MarcelZawadzki/autonomous-rover-thesis/rover_media/robot.png

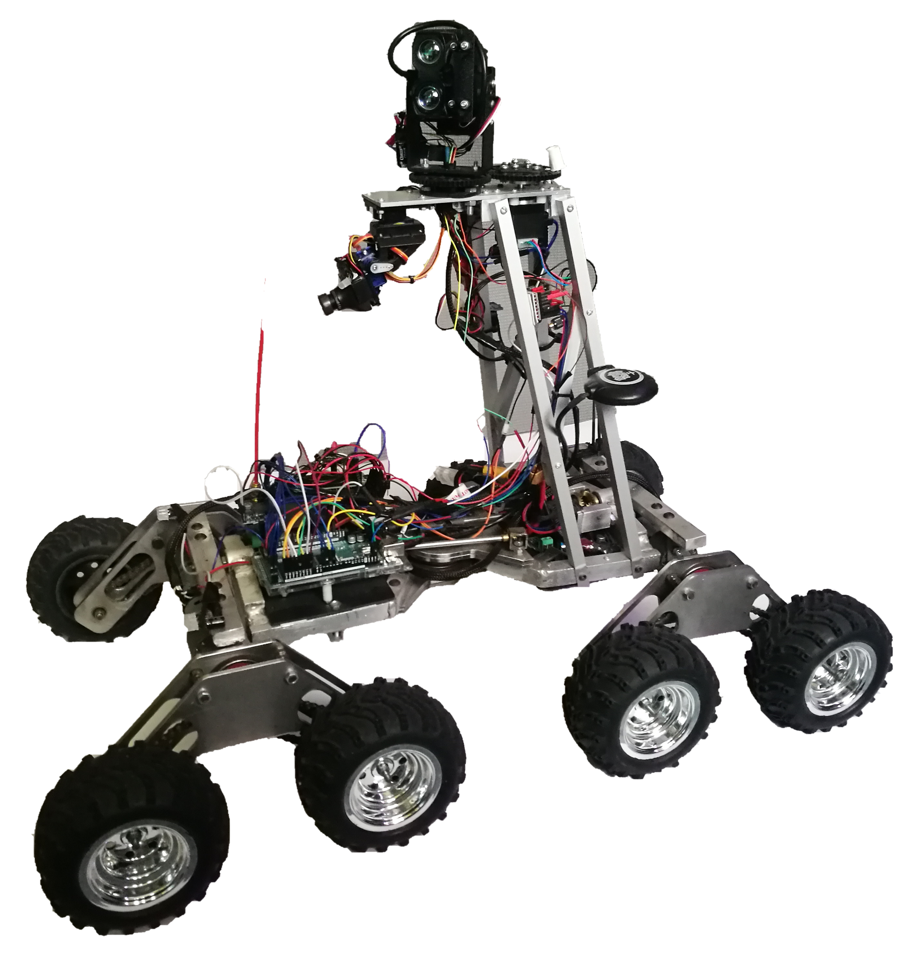
rover_media/robot.png
