MarcelZawadzki/autonomous-rover-thesis/autonomous_navigation_system_for_the_outdoor_mobile_robot_PL.pdf

Instytut Automatyki i Informatyki Stosowanej

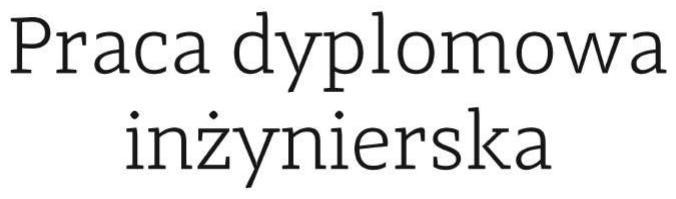
[picture p2: figure]

na kierunku Automatyka i Robotyka

### System autonomicznej nawigacji dla terenowego robota mobilnego

# Marcel Zawadzki

Numer albumu 310361

promotor
dr inz. Wojciech Dudek ˙

WARSZAWA 2024

### System autonomicznej nawigacji dla terenowego robota mobilnego

Streszczenie. Niniejsza praca skupia się na problemie autonomicznej nawigacji w nieusystematyzowanych terenach. Jej celem było opracowanie i implementacja systemu nawigacji autonomicznej dla terenowego robota mobilnego własnej konstrukcji, z wykorzystaniem skanera LiDAR.
Projekt obejmował opracowanie trójwymiarowego skanera LiDAR, rozbudowę platformy mobilnej o dodatkowe czujniki, utworzenie sterowników niskopoziomowych dla skanera i platformy mobilnej, opracowanie sterowników sprzętu w systemie ROS2 i utworzenie systemu nawigacji autonomicznej w ROS2. System ten jest zdolny do wykonywania kluczowych aspektów nawigacji, takich jak lokalizacja robota, mapowanie otoczenia, planowanie ściezki i jej realizacja. ˙
W ramach badań przeprowadzono szczegółowe testy poszczególnych modułów systemu, a następnie zweryfikowano skuteczno´sć całego systemu w zadaniu nawigacji autonomicznej. Wyniki testów potwierdziły efektywno´sć oraz poprawno´sć działania systemu, wskazuj ąc na jego zdolno´sć do skutecznego poruszania się w naturalnych, nieusystematyzowanych środowiskach.

Słowa kluczowe: robotyka, nawigacja autonomiczna, robot mobilny, łazik, LiDAR, ROS

### Autonomous navigation system for the outdoor mobile robot

Abstract. This thesis addresses the problem of autonomous navigation in unstructured environments. The goal was to develop and implement an autonomous navigation system for an all-terrain mobile robot made by the author, utilising a LiDAR scanner.
The project involved the development of a 3D LiDAR scanner, an expansion of the mobile platform’s capabilities with additional sensors, the creation of low-level controllers for the scanner and mobile platform, the development of hardware drivers in ROS2, and the creation of an autonomous navigation system in ROS2. This system is capable of executing the key aspects of navigation, such as robot localization, environment mapping, path planning and path execution.
As part of the research, detailed tests were conducted on individual modules of the system. Afterwards, the effectiveness of the entire system in the task of autonomous navigation was verified. The test results confirmed the effectiveness of the system, proving its ability to successfully navigate in natural, unstructured environments.

Keywords: robotics, autonomous navigation, mobile robot, rover, LiDAR, ROS

## Spis treści

0. Spis treści

## 1. Wstęp

Współczesna robotyka stanowi obszar nasilonych badań i rozwoju, który dynamicznie kształtuje krajobraz technologiczny. Dziedzina ta ł ączy obszary inzynierii mechanicznej, ˙ elektronicznej i oprogramowania pozwalaj ąc inzynierom na tworzenie robotów, zaawan- ˙ sowanych systemów zdolnych do interakcji ze światem rzeczywistym, których głównym celem jest wspomaganie człowieka w niektórych czynnościach, lub zastępowanie go [1]
- szczególnie gdy automatyzowana czynno´sć wi ąze się z niebezpieczeństwem dla wyko- ˙ nawcy lub cechuje się powtarzalności ą i monotoni ą, mog ąc ą doprowadzić do spadku dokładności wykonywanego przez człowieka zadania.
Roboty mobilne, w szczególności, staj ą się istotnym punktem zainteresowania ze względu na swoj ą zdolno´sć do poruszania się w przestrzeni i wykonywania róznorodnych ˙ zadań, poza określonym stanowiskiem instalacji. Umozliwiaj ą większ ą elastyczno´sć wyko- ˙ nywania zadań niz tradycyjne rozwi ązania automatyczne, jednocześnie nie wymagaj ąc ˙ zastosowania ludzkiej siły roboczej.
Najpopularniejsz ą podkategori ą robotów mobilnych s ą roboty przeznaczone do uzytku ˙ w przestrzeniach zamkniętych. Stanowi ą rozwi ązania łatwiejsze w implementacji, gdyz˙ pozwalaj ą na przyjęcie wielu załozeń upraszczaj ących projekt robota, m.in: ˙
- ograniczony poślizg kół,
- brak przechyłu robota,
- analizę przeszkód jedynie dwóch wymiarach,
- wykorzystanie infrastruktury np. przygotowanych punktów orientacyjnych lub linii

magnetycznych.

W przeciwieństwie do robotów mobilnych przeznaczonych do przestrzeni zamkniętych, roboty terenowe stawiaj ą przed inzynierami dodatkowe wyzwania. Musz ą podołać ˙ niebezpiecznym warunkom terenowym, zmiennym nachyleniom trenu i przeszkodom trójwymiarowym, co wymaga bardziej zaawansowanych systemów nawigacyjnych i lepszej adaptacji do zmiennych warunków otoczenia. Dzięki temu ich zastosowania mog ą być znacznie szersze. Cechuj ą się zdolności ą do operowania w nieustrukturyzowanych środowiskach, takich jak krajobrazy naturalne i rolnicze oraz obszary po kataklizmach. Umozliwia to wykorzystanie ich w zadaniach jak m.in.: ˙

- eksploracji trudno dostępnych i niebezpiecznych terenów np. obszarów skazonych, ˙
- zadaniach inspekcyjnych infrastruktury np. energetycznej i gazowej,
- zastosowaniach militarnych np. patrolowych i rozbrajaniu ładunków wybuchowych,
- branzy rolniczej np. monitorowania rozległych upraw. ˙

Szczególn ą odmian ą pierwszego z wymienionych zastosowań jest eksploracja kosmiczna Księzyca i Marsa, będ ąca pierwotnym zastosowaniem terenowych robotów mobilnych - ˙
łazików kosmicznych. Łaziki umozliwiaj ą przeprowadzanie badań bez zagro ˙ | zenia ˙ | zycia ˙
ludzkiego i konieczności transportu zywności, wody, czy tworzenia systemów podtrzyma- ˙ nia zycia. ˙

1. Wstęp
Powyzsze zastosowania wymagałyby od człowieka nara ˙ | zenia na niebezpieczeństwo lub ˙
wykonywania powtarzalnych czynności, s ą więc dobrze dostosowane do wykonywania przez robota w sposób autonomiczny. W przypadku aplikacji pozaziemskich, dodatkowym argumentem za automatyzacj ą jest znacz ące opóźnienie w komunikacji - w przypadku transmisji pomiędzy Ziemi ą a Marsem wynosi ono od 5 do 20 minut[2], co znacz ąco utrudnia bezpośrednie sterowanie.
W niniejszej pracy omówiona zostanie problematyka zwi ązana z projektowaniem i implementacj ą autonomicznego systemu nawigacji dla robota terenowego. W tym kontek-ście analizowane będ ą rózne aspekty, takie jak platforma mobilna, systemy sensoryczne, a ˙ takze algorytmy nawigacyjne. ˙

## 2. Cel pracy

Celem niniejszej pracy było stworzenie autonomicznego systemu dla robota mobilnego własnej konstrukcji, zdolnego do nawigacji w nieustrukturyzowanych środowiskach. Zastosowana platforma mobilna technicznie umozliwia poruszanie się po nieregularnym ˙ terenie. Opracowany system posiada zdolno´sć lokalizacji robota, mapowania otoczenia, wyznaczania trasy do określonego celu, a następnie skutecznego jej pokonywania, uwzględniaj ąc omijanie przeszkód. W ramach projektu opracowano trójwymiarowy skaner LiDAR jako kluczowe narzędzie do percepcji otoczenia przez robota. Dodatkowo, przygotowano sterowniki niskopoziomowe, umozliwiaj ące zbieranie danych oraz skuteczne sterowanie ˙ ruchem robota.

### 2.1. Załozenia projektowe ˙

Na podstawie analizy dziedziny i istniej ących rozwi ązań, które zostan ą szczegółowo przeanalizowane w rozdziałach 3 i 4, przyjęte zostały następuj ące załozenia projektowe: ˙

- Nawigacja autonomiczna - system zdolny będzie do wykonywania zadania nawigacji

autonomicznej zgodnie z definicj ą w sekcji 3.5.
- Dane wejściowe do systemu - współrzędne celu
- Wykorzystanie autorskiej terenowej platformy mobilnej, opisanej w sekcji 3.2. Oferuje

ona bardzo dobr ą mobilno´sć i jest przystosowana do poruszania się po nieregularnym terenie, oraz pozwala na instalację szerokiego zakresu czujników.
- Skonstruowanie trójwymiarowego skanera LiDAR. Z przyczyn przytoczonych w sekcji

3.3 jest odpowiednim źródłem danych w robocie terenowym, jednocześnie mieszcz ąc się w budzecie autora. Ponadto, konstrukcja własnego czujnika pozwoli na zbadanie ˙ wpływu parametrów skanera na działanie systemu.
- Wykorzystanie mikrokontrolerów ATmega i języka C++ do sterowania niskopozio-

mow ą części ą systemu. W ramach niniejszej pracy oprogramowanie zostało poszerzone o obsługę dodatkowych sensorów oraz mozliwo´sć komunikacji z komputerem ˙ obsługuj ącym funkcje wysokopoziomowe.
- Zastosowanie struktury ramowej ROS2 w wersji Humble [3] przeznaczonej na system

Ubuntu 22.04 LTS do rozwijania oprogramowania wysokopoziomowego, z powodów przedstawionych w sekcji 3.6. Wybrana została najnowsza wersja z długim terminem wsparcia. Ponadto ROS w wersji 2 oferuje zwiększone bezpieczeństwo i stabilno´sć. Do programowania pojedynczych węzłów uzyto język Python, ze względu na szybko´sć ˙ tworzenia kodu i dostępności obszernej gamy bibliotek.
- Do tworzenia schematów blokowych SysML zgodnie z metamodelem MeROS [4]

wykorzystano Visual Paradigm.
- Pozostałe wykorzystane oprogramowanie: IDE VS Code, MatLab R2021a do analizy

danych, Solidworks 2021 do modelowania 3D, CURA 5.0 do przygotowania modeli do druku 3D.

2. Cel pracy

### 2.2. Ograniczenia

Ponadto, przyjęte zostały następuj ące ograniczenia zakresu pracy:
- Podczas wykonywania zadania nawigacji ignorowane będ ą dynamiczne przeszkody. Robot z załozenia poruszać ma się po terenach niezamieszkanych, ponadto jego ˙ niska prędko´sć ogranicza wpływ poruszaj ących się z duz ą prędkości ą obiektów na ˙ jego ściezkę. ˙
- Mozliwości porównania wyników z innymi rozwi ązaniami s ą ograniczone, ze względu ˙ na brak dostępu do standaryzowanych warunków testowych i duze ró ˙ znice w kon- ˙ strukcjach robotów.
- W czasie nawigacji ignorowane s ą zbiorniki wodne. Woda jest przezroczysta i odblaskowa, co uniemozliwia poprawne jej wykrycie przez czujnik LiDAR. Konieczne ˙ byłoby zastosowanie dodatkowych czujników np. ultradźwiękowych, których wi ązka odbija się od wody.

### 2.3. Walidacja działania systemu

Skuteczno´sć rozwi ązania przetestowana została podczas testów terenowych całości systemu oraz testów działania odseparowanych podsystemów. Działanie skanera LiDAR zostało przetestowane w szerokim zakresie warunków otoczenia i porównane z komercyjnym sensorem. Sterowniki niskopoziomowe testowane były w odseparowaniu od warstwy wysokopoziomowej. Algorytmy autonomiczne przetestowano w pomieszczeniu w poblizu˙ stanowiska roboczego, w celu ułatwienia modyfikacji oprogramowania na biez ąco. Dalsze ˙ testy przeprowadzono w warunkach naturalnych, w nierównym terenie z przeszkodami, najczęściej drzewami lub dodatkowymi przeszkodami umieszczonymi ręcznie w środowisku. W celu walidacji działania kompletnego systemu, przeprowadzono testy w naturalnym, nieregularnym środowisku z przeszkodami. Zadano robotowi cel, następnie obserwowano realizację zadania. Przejazd zarejestrowano z wykorzystaniem zewnętrznej kamery, oraz zapisano wizualizację stanu systemu.

## 3. Narzędzie i technologie

### 3.1. Roboty mobilne

Robot mobilny jest to robot zdolny do zmiany połozenia w przestrzeni, je ˙ | zd˙ z ąc, krocz ąc, ˙
lataj ąc lub pływaj ąc. Ponizsza analiza ograniczona będzie do robotów l ądowych. Podstaw ą ˙ robota jest napęd. W robotach terenowych najczęściej wykorzystywane s ą napędy:
- napęd róznicowy - podstawowo obejmuj ący dwa współosiowe koła o regulowanej ˙

prędkości. W takiej konfiguracji powszechny w robotach zaprojektowanych do poruszania się po płaskim terenie. W robotach terenowych na ogół poszerzony o dodatkowe nieskrętne koła, lub wyposazony w g ąsienice zamiast kół. Dodatkowe koła ˙ lub g ąsienice powoduj ą poślizg podczas skręcania, ale ułatwiaj ą jazdę po nierównym terenie.
- napęd holonomiczny (ang. omnidirectional) - robot wyposazony w wiele kół skręt- ˙ nych, lub inne, niestandardowe rozwi ązanie. Robot holonomiczny z definicji moze˙ mieć zadany dowolny wektor prędkości. Wad ą takiego rozwi ązania jest wysokie skomplikowanie konstrukcji.
- robot krocz ący - ruch robota odbywa się poprzez poruszanie kończynami skonstru-
owanymi na wzór organizmów zywych. Wyposa ˙ | zone w du ˙ | z ą liczbę stopni swobody, ˙
skomplikowane mechaniczne i wymagaj ące do sterowania skomplikowanych algorytmów.

Dany rodzaj napędu determinuje konstrukcję robota. Przy robotach kołowych zalecane jest wykorzystanie mechanizmu umozliwiaj ącego utrzymanie kontaktu kół z nierów- ˙ nym podłozem, czyli zawieszenia. Zastosowanie takiego mechanizmu poprawia zdolno´sć ˙ robota do pokonywania przeszkód, zwiększa stabilno´sć robota, zmniejsza poślizg kół i
zapewnia równomierne obci ązenie napędów. Typ zawieszenia zale ˙ | zny jest od liczby kół, ˙
powszechnie wykorzystywane jest np. zawieszenie typu rocker-bogie [5], wykorzystane m.in. w łaziku NASA Perserverence [2] (rys. 3.1) lub zawieszenie wahaczowe.
Ponadto, aby robot mobilny był uzyteczny, powinien dysponować autonomi ą energe- ˙
tyczn ą, co oznacza, ze powinien posiadać zintegrowane źródło zasilania. Takie źródło mo ˙ | ze˙
obejmować akumulatory, ogniwa paliwowe lub reaktor j ądrowy (w przypadku łazików ko-
smicznych). Kluczowe jest równiez wyposa ˙ | zenie robota w układy niezbędne do sterowania ˙
napędami i innymi elementami mechanicznymi. Co więcej, w kontekście współczesnych systemów robotycznych, istotnym aspektem jest równiez brak konieczności wykorzystania ˙ przewodów do komunikacji. W przypadku robotów autonomicznych wystarczaj ące jest otrzymanie komend z celem i przesyłanie telemetrii drog ą radiow ą.

### 3.2. Platforma mobilna

W niniejszej pracy wykorzystano platformę mobiln ą własnej konstrukcji (rys. 3.2), zbudowan ą we wcześniejszym czasie. Ponizej przedstawiona została jej specyfikacja. ˙

3. Narzędzie i technologie

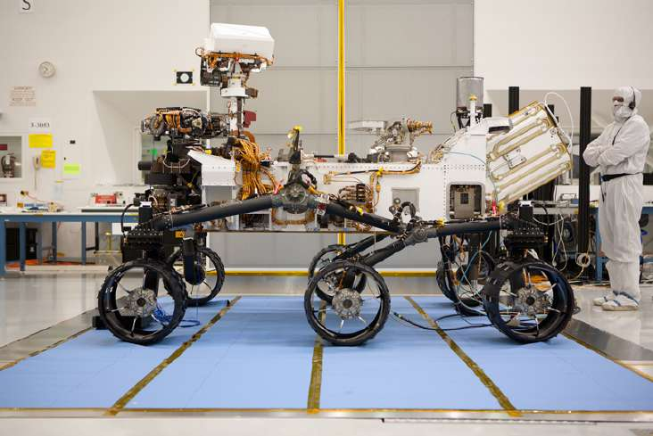
[picture p3: figure]

Rysunek 3.1. Zawieszenie łazika Perserverence [2]

Robot jest wyposazony w niestandardowy rodzaj napędu, składaj ący się z 8 napędza- ˙ nych kół oraz centralnie umieszczonego przegubu. Koła napędzane s ą silnikami pr ądu stałego (po 2 koła na pojedynczy silnik). Wykorzystane zostały silniki szczotkowe Igarashi 2738-125 [6] wraz z przekładni ą 50:1. Do wychylenia przegubu wykorzystywany jest serwonapęd PowerHD LF-20MG [7] z systemem cięgien.
Napęd w istocie stanowi rozszerzenie napędu róznicowego - steruj ąc jedynie prędko- ˙ ści ą kół z prawej i lewej strony sterowanie odbywałoby się na zasadzie standardowego napędu róznicowego. Dodany przegub poprawia właściwości jezdne platformy, redukuj ąc ˙ poślizg kół podczas skręcania. Poślizg (w obrocie robota wokół osi pionowej) nie zachodzi, gdy o´s koła przechodzi przez środek rotacji robota. Przyjmuj ąc obrót wokół punktu O, z przegubem w punkcie S odpowiednie wychylenie przegubu powoduje zmniejszenie k ąta odchylenia kierunku osi kół (o1,o2,o3,o4) od kierunku promienia skrętu (Promień skrętu robota Rs

, promienie dla poszczególnych kół odpowiednio o1,o2,o3,o4). (Rys. 3.3, 3.4). Szczegółowe równania ruchu układu napędowego zostan ą wyprowadzone w dalszej części pracy. Napęd ma tak ą sam ą swobodę ruchu jak napęd róznicowy. Nie jest holonomiczny, ˙
moze realizować trajektorie o niezerowej prędkości liniowej w osi ˙ | x oraz prędkości k ątowej
wokół osi z w układzie odniesienia robota ¹
Zastosowanie przegubu, poza ograniczeniem poślizgu skutkuje zwiększeniem pre-
cyzji pokonywania zakrętów i zmniejsza obci ązenie silników podczas skręcania. Nale ˙ | zy˙
jednak zaznaczyć, ze k ąt wychylenia przegubu jest ograniczony. W przypadku obrotów ˙ o zbyt małym promieniu skrętu, na przykład podczas skręcania w miejscu, gdy środek obrotu znajduje się pomiędzy prawymi i lewymi kołami, przegub nie moze być efektywnie ˙

1 Konwencja nazewnictwa osi w tej i kolejnych wzmiankach, to o´s x skierowana w przód robota, o´s z w górę

3. Narzędzie i technologie

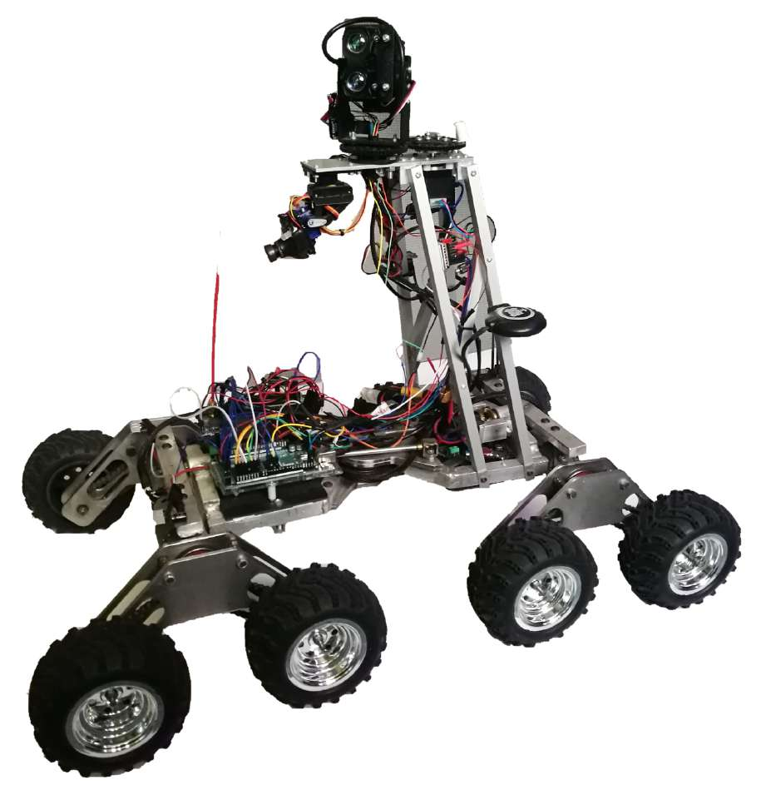
[picture p4: figure]

Rysunek 3.2. Platforma mobilna

3. Narzędzie i technologie

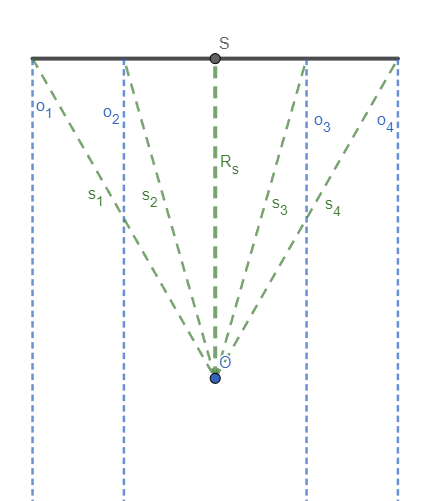
[picture p5: figure]

Rysunek 3.3. Skręt w napędzie róznicowym ˙

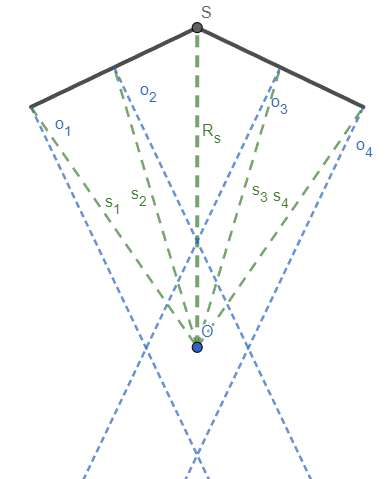
[picture p6: figure]

Rysunek 3.4. Skręt z dodatkowym przegubem

3. Narzędzie i technologie

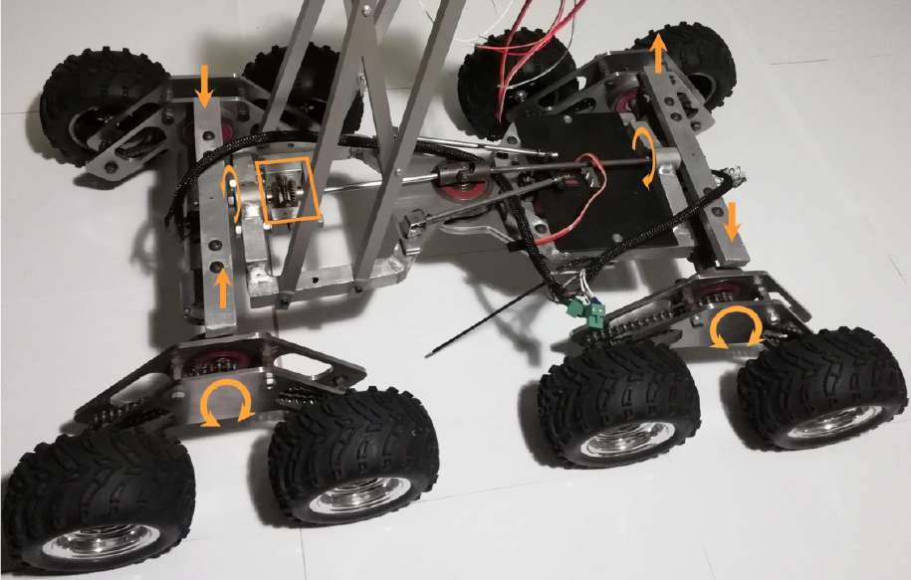
[picture p7: figure]

Rysunek 3.5. Zawieszenie platformy mobilnej

wykorzystywany. W takich sytuacjach robot traktowany jest jako platforma z napędem róznicowym. ˙
Kolejnym istotnym komponentem jest zawieszenie łazika (Rys. 3.5). Składa się ono z dwóch poziomych kolebek, umieszczonych z przodu i z tyłu pojazdu. Na końcach kazdej ˙ kolebki znajduje się wózek, który obraca się wokół osi kolebki. Kazdy z tych wózków ˙ jest wyposazony w dwa koła, napędzane jednym silnikiem. Napęd ten jest przenoszony ˙ poprzez łozysko umieszczone między kolebk ą a wózkiem, a następnie za pomoc ą łańcu- ˙ cha wewn ątrz wózka. Dodatkowo, przez środek łazika przechodzi wał, który ł ączy obie kolebki. Wewn ątrz kadłuba znajduje się przekładnia odwracaj ąca kierunek obrotu wału. W rezultacie, k ąt wychylenia kadłuba jest średni ą z k ątów wychyleń obu kolebek. Ten złozony ˙ system zawieszenia umozliwia łazikowi utrzymanie stabilności na nierównym terenie, ˙ dostosowuj ąc k ąt pochylenia kadłuba do warunków terenowych.
Robot zasilany jest dwiema bateriami litowo-polimerowymi poł ączonymi równolegle, o ł ącznej pojemności 3,6Ah i napięciu nominalnym 18,5V.
W rezultacie robot posiada następuj ąc ą specyfikację:
- maksymalna prędko´sć liniowa: 0,230 m/s
- maksymalna prędko´sć k ątowa: 1,34 rad/s
- maksymalne wychylenie przegubu: 20,1◦
- wymiary podwozia: 660mm długości x 410mm szerokości x 160mm wysokości (520mm z wiez ą sensoryczno-komunikacyjn ą) ˙
Ponadto, robot jest wyposazony w wie ˙ | zę sensoryczno-komunikacyjn ą, która umo ˙ | zliwia ˙

3. Narzędzie i technologie

umieszczenie sensorów z dala od potencjalnych źródeł zakłóceń, zwiększa widoczno´sć anten w przypadku nierównego terenu, oraz pozwala na montaz skanerów lub kamer na ˙ większej wysokości, co z kolei zwiększa ich efektywno´sć i pole widzenia.
Funkcje niskopoziomowe platformy sterowane s ą za pomoc ą mikrokontrolera ATmega2560. Obejmuj ą sterowanie silnikami, odczyt danych z czujników oraz zarz ądzanie komunikacj ą z urz ądzeniami steruj ącymi. Mozliwości komunikacyjne samej platformy ˙ obejmuj ą dwustronn ą ł ączno´sć radiow ą w częstotliwości 433 MHz ze stacj ą bazow ą (obsługuj ąc ą sterowanie i telemetrię), a takze przesyłanie obrazu z kamery analogowej na ˙ głowicy typu Pan-Tilt (ang., obrót i pochylenie) w częstotliwości 5.8 GHz. Te funkcje umoz-˙ liwiaj ą operatorowi na ręczne sterowanie platform ą, co było pierwotnym przeznaczeniem platformy.

### 3.3. Czujniki wizyjne

Aby mozliwa była automatyzacja robota, kluczowa jest jego zdolno´sć do efektywnego ˙ pozyskiwania informacji o otoczeniu. Porównane zostanie kilka popularnych technologii słuz ących do pozyskiwania danych z otoczenia. ˙

LiDAR
LiDAR (ang. Light Detection and Ranging) to technologia wykorzystywana do mierzenia odległości poprzez pomiar czasu, jaki wysłana przez emiter wi ązka laserowa potrzebuje na powrót do sensora po odbiciu od obiektu. Proces ten umozliwia precyzyjne określe- ˙ nie odległości między czujnikiem a otaczaj ącymi obiektami. LiDAR charakteryzuje się
duz ą szybkości ą pojedynczego odczytu, co sprawia, ˙ | ze jest efektywnym narzędziem do ˙
pomiarów w dynamicznych środowiskach. Dodatkowo, technologia ta cechuje się wysok ą
dokładności ą, sięgaj ąc ą ponizej 1 cm, oraz du ˙ | zym zasięgiem działania do 300 metrów [ ˙ | 8].

Skaner LiDAR 2D
Skaner LiDAR 2D składa się z pojedynczego sensora z mechanizmem obrotowym lub wielu sensorów (przykładowy sensor na rys. 3.6). Dostarcza informacji o odległości do obiektów znajduj ących się w płaszczyźnie sensora, co sprawia, ze jest dedykowany głównie ˙ do regularnych pomieszczeń, gdzie większo´sć przeszkód ma niewielkie zmiany w pionie. Dodatkowo, w przypadku przechylenia robota względem płaszczyzny poziomej, pomiar moze ulec zaburzeniu. W rezultacie, skaner LiDAR 2D nie sprawdza się dobrze w przypadku ˙ nieusystematyzowanego terenu.

Kamera głębi
Kamera głębi opiera się na technologii stereowizji, wykorezystuj ąc 2 kamery RGB (przykła-
dowy sensor na rys. 3.7). Jej działanie jest wrazliwe na warunki oświetleniowe [ ˙ | | 10], co moze˙
stanowić utrudnienie w otwartych przestrzeniach. Dodatkowo, moze napotykać trudności ˙ przy interpretacji nieregularnych, naturalnych obiektów takich jak roślinno´sć czy skały, które znacz ąco zmieniaj ą wygl ąd zaleznie od padania światła i niewielkich przesunięć. ˙

3. Narzędzie i technologie

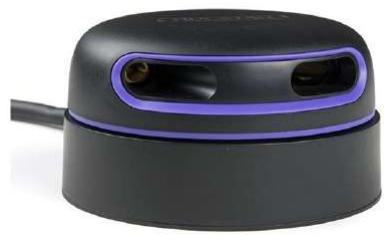
[picture p8: figure]

Rysunek 3.6. Skaner 2D RPLIDAR A3M1 [9]

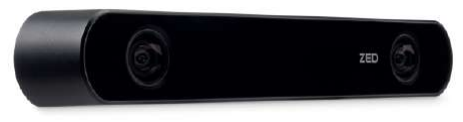
[picture p9: figure]

Rysunek 3.7. Kamera głębi StereoLabs ZED 2 [11]

Skaner LiDAR 3D
Skaner LiDAR 3D składa się z pojedynczego lub wielu sensorów z mechanizmem obrotowym w jednej lub wielu osiach (przykładowy sensor na rys. 3.8). Skaner LiDAR 3D generuje chmurę punktów reprezentuj ąc ą całe otoczenie, co czyni go odpowiednim do pozyskiwania danych z nieusystematyzowanego terenu. Wad ą rozwi ązania jest wysoki koszt, przekraczaj ący 10 000 zł.

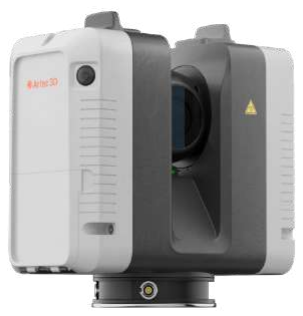
[picture p10: figure]

Rysunek 3.8. Skaner 3D Artec Ray II [12]

Własny skaner LiDAR 3D
Alternatyw ą jest zbudowanie własnego skanera LiDAR 3D, stworzonego przy uzyciu czuj- ˙ nika 1D. Rozwi ązanie to posiada zalety charakterystyczne dla skanerów 3D, ale cechuje
się znacznie nizszym kosztem, który mo ˙ | ze być jednak skorelowany z potencjalnie ni ˙ | zsz ą ˙
szybkości ą i rozdzielczości ą w porównaniu do urz ądzeń komercyjnych.

3. Narzędzie i technologie

### 3.4. Pozostałe czujniki

W robotach mobilnych powszechnie wykorzystywane s ą równiez inne rodzaje czujni- ˙ ków:

IMU
IMU (ang. Inertial measurement unit), czyli jednostka pomiarowa inercji, to moduł zawieraj ący akcelerometr, zyroskop i magnetometr. Akcelerometr mierzy przyspieszenie liniowe, ˙ zyroskop rejestruje prędko´sć k ątow ą, a magnetometr dostarcza informacje o wektorze pola ˙ magnetycznego. Uzyskiwany jest wektor 9 wartości. Dzięki tym danym IMU umozliwia ˙ śledzenie ruchu i orientacji obiektu. Przykładowy czujnik przedstawiono na rys. 3.9.

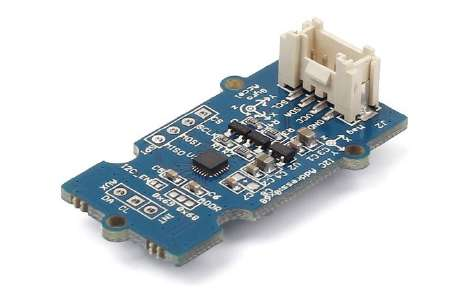
[picture p11: figure]

Rysunek 3.9. Czujnik Grove IMU 9DOF v2.0 MPU-9250 [13]

GNSS
GNSS (ang. Global Navigation Satellite System) to system obejmuj ący rózne grupy sateli- ˙ tów umieszczonych na orbicie, takie jak najbardziej znany GPS, oraz GLONASS, Galileo czy BeiDou. Czujnik GNSS, wykorzystuj ąc sygnały z tych satelitów, dostarcza informacje o lokalizacji - współrzędne geograficzne (długo´sć, szeroko´sć, wysoko´sć). Te informacje pozwalaj ą na określenie globalnej lokalizacji. Przykładowy odbiornik przedstawiono na rys. 3.10.

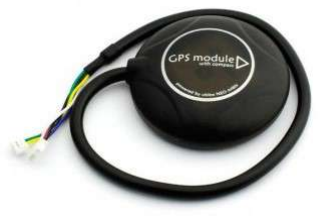
[picture p12: figure]

Rysunek 3.10. Odbiornik GNSS Ublox NEO-M8N [14]

3. Narzędzie i technologie

### 3.5. Autonomiczna nawigacja

Zadanie nawigacji autonomicznej odnosi się do zdolności do autonomii decyzyjnej robota. Obejmuje kompleksowy zestaw operacji, maj ących na celu umozliwienie robotowi ˙ skutecznego poruszania się w nieznanym środowisku. Kluczowymi aspektami tego zadania s ą:
- Lokalizacja robota: Określenie dokładnego połozenia robota w przestrzeni, w pew- ˙

nym globalnym układzie odniesienia.
- Mapowanie otoczenia: Tworzenie reprezentacji otoczenia robota poprzez zbieranie informacji o strukturze przestrzeni wokół niego. Mapowanie moze obejmować ˙ zarówno elementy stałe, jak i zmienne, takie jak przeszkody, ściany, drzewa i skały.
- Wyznaczanie ściezki do celu: Opracowanie optymalnej trasy prowadz ącej z aktualnej ˙

lokalizacji robota do, określonego przez operatora lub algorytm, celu. Algorytmy planowania trasy uwzględniaj ą trudno´sć ściezki i znajduj ące się na niej przeszkody. ˙
- Przejechanie ściezki omijaj ąc przeszkody: Realizacja zaplanowanej trasy przez robota, ˙

przy jednoczesnym unikaniu przeszkód oraz dostosowywaniu się do zmieniaj ącego się otoczenia.

Wszystkie te operacje maj ą być wykonane autonomicznie, bez konieczności ingerencji
ze strony operatora. To oznacza, ze robot musi być wyposa ˙ | zony w zaawansowane systemy ˙
percepcji oraz oprogramowanie zdolne do planowania i sterowania, umozliwiaj ące mu ˙ samodzielne funkcjonowanie w róznorodnych warunkach środowiskowych. ˙

### 3.6. Robot Operating System

Najpopularniejszym rozwi ązaniem do tworzenia oprogramowania robotów jest ROS [3] (ang. Robot Operating System). ROS to oprogramowanie typu open source stanow ące strukturę ramow ą dedykowan ą tworzeniu systemów robotycznych. System ten oferuje zestaw narzędzi i bibliotek, które ułatwiaj ą programowanie, kontrolę i interakcję między
róznymi komponentami. Jedn ą z kluczowych cech ROS jest modularno´sć, która umo ˙ | zliwia ˙
łatwe ł ączenie programów w jeden konfigurowalny system. Komunikacja między róznymi ˙ komponentami systemu opiera się na mechanizmach tematów i węzłów.
Węzły (Nodes): Węzły to autonomiczne jednostki wykonawcze w systemie ROS, które
realizuj ą konkretne zadania. Kazdy węzeł mo ˙ | ze zawierać logikę programu, kontrolować ˙
konkretne elementy robota lub zbierać dane z sensorów. Węzły komunikuj ą się ze sob ą
poprzez tematy. Rózne węzły mog ą być zaimplementowane w ró ˙ | znych językach programo- ˙
wania, co pozwala na wykorzystanie niskopoziomowych języków w węzłach krytycznych dla wydajności systemu.
Tematy (Topics): Tematy s ą jednym z podstawowych mechanizmów komunikacyjnych w ROS. S ą to nazwane strumienie danych, które pozwalaj ą jednemu węzłowi publikować informacje (dane sensoryczne, dane stanu, itp.), a inne węzły mog ą się na nie subskrybować.

3. Narzędzie i technologie

Tematy umozliwiaj ą bezpośredni ą komunikację między węzłami poprzez przekazywanie ˙ komunikatów w czasie rzeczywistym.
Mechanizm ten umozliwia elastyczn ą i zdecentralizowan ą architekturę systemu, gdzie ˙
rózne węzły, odpowiedzialne za ró ˙ | zne aspekty funkcjonalne robota, mog ą współpracować ˙
poprzez publikowanie i subskrybowanie danych.
| ROS obsługuje szeroki zakres zastosowań w robotyce mobilnej, manipulacyjnej, sen-
sorycznej i innych dziedzinach. Dzięki bogatej społeczności uzytkowników i aktywności ˙ deweloperskiej, ROS stanowi preferowane narzędzie wśród badaczy i inzynierów. ˙

### 3.7. Lokalizacja

Lokalizacja w kontekście robotyki często wykorzystuje dwa kluczowe układy odniesienia: układ odometrii (odom) i układ mapy (map). Lokalizację w układzie odom stanowi lokalizację lokaln ą, za´s w układzie map globaln ą.
Układ odometrii opiera się na pomiarach przemieszczenia robota, wykorzystuj ąc dane z ruchu kół, jednostki inercyjnej, lub odometrii wizualnej. Jest to lokalny układ odniesienia, który dostarcza informacji o ruchu w czasie rzeczywistym, w sposób ci ągły. Jest jednak podatny na kumulację błędów.
Z drugiej strony, układ mapy reprezentuje globalne środowisko, w którym porusza się robot. Jest to reprezentacja przestrzeni zawieraj ąca informacje o przeszkodach, kształcie terenu itp. Układ mapy umozliwia robotowi orientację w globalnej skali, co jest istotne dla ˙ nawigacji w duzych środowiskach. Układ globalny pozwala na wyeliminowanie kumulowa- ˙ nego błędu odometrii.

### 3.8. SLAM

SLAM (ang. Simultaneous Localization and Mapping) to algorytm, który jednocześnie lokalizuje obiekt (np. robota) w przestrzeni oraz aktualizuje na biez ąco mapę otoczenia. ˙ Algorytmy SLAM integruj ą dane pochodz ące z sensorów wizyjnych, takich jak kamery i skanery, w czasie rzeczywistym. Algorytm moze działać zarówno na mapach otoczenia ˙ i źródłach danych dwu- i trójwymiarowych. SLAM dopasowuje najnowszy skan lub obraz do przechowywanej w pamięci mapy - uzyskane połozenie nowego skanu stanowi ˙ now ą wyznaczon ą lokalizację. Następnie nowy skan jest wykorzystywany do aktualizacji mapy. Dodatkowo, wraz z algorytmem SLAM często stosuje się algorytmy domykaj ące
pętlę (ang. loop closure), które koryguj ą cało´sć mapy, gdy wykryj ą, ze znane ju ˙ | z miejsce ˙
zostało ponownie odwiedzone. Zapewnia to zachowanie ci ągłości mapy, i jednoznaczno´sć odwzorowania rzeczywistych lokalizacji na mapie.

### 3.9. Filtr komplementarny

Filtr komplementarny działa na zasadzie ł ączenia informacji z sensorów w IMU. Bazuje na dokładnych danych z zyroskopu, eliminuj ąc przy tym dryf tego sensora za pomoc ą ˙

3. Narzędzie i technologie

informacji z akcelerometru i magnetometru. Te ostatnie, choć charakteryzuj ą się mniejsz ą dokładności ą, nie posiadaj ą dryfu. Dzięki takiemu podejściu, filtr komplementarny eliminuje dryf pomiarowy i zapewnia stabiln ą orientację obiektu.

### 3.10. Filtr Kalmana

Filtr Kalmana to algorytm estymuj ący wektor stanu modelu na podstawie pomiarów wejścia i wyjścia. W robotyce jego głównym celem jest integracja informacji z róznych ˙ rodzajów sensorów, wykorzystuj ąc informacje o niepewności pomiarów dostarczane przez czujniki. W efekcie uzyskiwana jest najdokładniejsza mozliwa ci ągła estymata stanu sys- ˙ temu. Algorytm reprezentowany jest następuj ącymi wzorami [15]:
Predykcja stanu:

xˆk|k−1 = F xˆk−1|k−1 +Guk

Predykacja kowariancji:

Pk|k−1 = F Pk−1|k−1F

T +Q

Wzmocnienie Kalmana:

Kk = Pk|k−1H

T
(HPk|k−1H

T +Rk)
−1

Aktualizacja stanu:

xˆk|k = xˆk|k−1 +Kk(zk − Hxˆk|k−1)

Aktualizacja kowariancji:

Pk|k = (I −KkH)Pk|k−1(I −KkH)

T +KkRkK

T
k

Oznaczenia:

xˆk|k−1 : Przewidywana warto´sć stanu w chwili k, obliczona w chwili k −1.

F : Macierz przejścia stanu.

xˆk−1|k−1 : Estymowana warto´sć stanu w chwili k −1

G : Macierz sterowania.

uk : Wejście (sterowanie) w chwili k.

Pk|k−1 : Przewidywana kowariancja stanu w chwili k, obliczona w chwili k −1.

Q : Kowariancja szumu procesu.

3. Narzędzie i technologie

Kk : Wzmocnienie Kalmana.

H : Macierz obserwacji.

Rk : Kowariancja szumu pomiarowego.

xˆk|k : Estymowana warto´sć stanu w chwili k

zk : Wektor pomiarów w chwili k.

I : Macierz jednostkowa.

Istnieje równiez rozszerzony filtr Kalmana (ang. Extended Kalman Filter, EKF) - roz- ˙ szerzony o przypadki, gdy model matematyczny systemu jest nieliniowy, umozliwiaj ąc ˙ skuteczn ą estymację stanu nieliniowych systemów dynamicznych.

### 3.11. MeROS

MeROS [4] to metamodel ułatwiaj ący modelowanie systemów robotycznych bazuj ących na ROS1 i ROS2 z wykorzystaniem SysML (ang. Systems Modeling Language). Zapewnia ustandaryzowan ą formę diagramów blokowych, ułatwiaj ąc ą projektowanie i interpretację.

## 4. Przegl ąd rozwi ązań

W niniejszym rozdziale przedstawiono przegl ąd róznych rozwi ązań istniej ących na ˙ rynku i prac naukowych, które konkuruj ą lub stanowi ą alternatywę dla proponowanego systemu.

### 4.1. Łaziki marsjańskie

Pierwsze łaziki marsjańskie (Sojourner (1997), Spirit (2003), Opportunity (2003)) [16] nie wykorzystywały pełnej nawigacji autonomicznej. Roboty realizowały uproszczon ą autonomię bazuj ąc ą na wykonywaniu określonych zachowań, z reakcjami na zagroze- ˙ nia. Stopniowo wprowadzano planowanie ruchów. Rozwi ązania w pełni autonomicznej nawigacji zaczęto stosować w robotach Curiosity (2011) i Perseverance (2020) (rys. 4.1). Pozwoliło to na znacz ące zmniejszenie czasu reakcji sterowania i zwiększyło bezpieczeństwo działania.

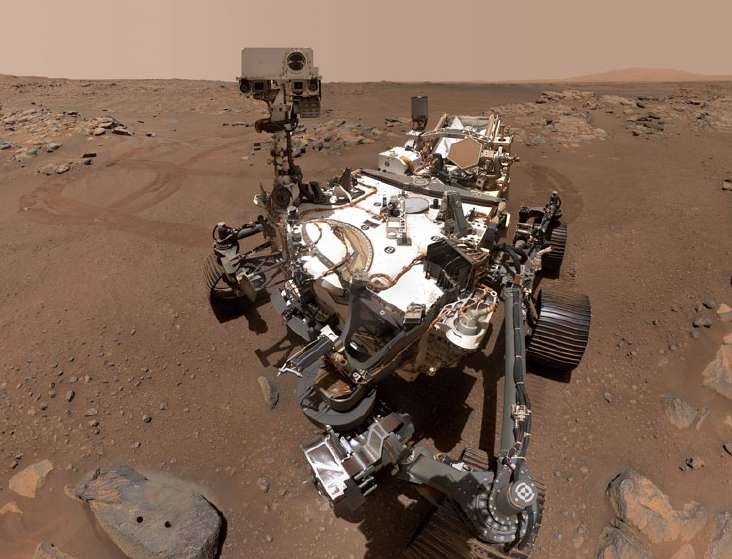
[picture p13: figure]

Rysunek 4.1. Łazik Perseverance [2]

### 4.2. Leo rover

Leo Rover [17] (rys. 4.2) to platforma mobilna dostępna na rynku, dedykowana zastosowaniom edukacyjnym. Stanowi gotowe rozwi ązanie sprzętowe z mozliwości ą samodziel- ˙ nego programowania z wykorzystaniem ROS 1. Stanowi jednakze zamknięty produkt, z ˙
ograniczonymi mozliwościami modyfikacji przez u ˙ | zytkownika, wykorzystuje określony ˙
zestaw sensorów (domyślnie wyposazony w kamerę). Ponadto cechuje się wysokim kosz- ˙

4. Przegl ąd rozwi ązań

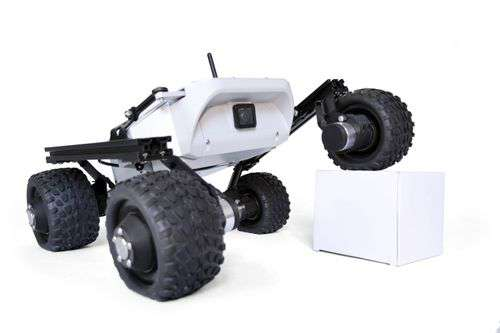
[picture p14: figure]

Rysunek 4.2. Leo Rover [17]

tem zakupu ok. 20000 zł. Stanowi pewn ą alternatywę dla proponowanego rozwi ązania, w zakresie sprzętowym.

### 4.3. Mapowanie pni

W pracy "SLAM-Aided Stem Mapping for Forest Inventory with Small-Footprint Mobile LiDAR"[18] wykorzystano robota mobilnego (rys. 4.3) wyposazonego w LiDAR. System jest ˙ dostosowany do nawigacji w terenach leśnych. Wykorzystuje kształt pni do mapowania i
lokalizacji - przy załozeniu ˙ | ze pnie s ą pionowe, mo ˙ | zliwe jest zwiększenie precyzji lokalizacji ˙
dzięki wykorzystaniu trójwymiarowego skanera. Jednakze, choć rozwi ązanie jest efektywne ˙ w specyficznych warunkach leśnych, jego zastosowanie moze być ograniczone ze względu ˙ na niewielk ą uniwersalno´sć. Celem autora niniejszej pracy jest natomiast utworzenie rozwi ązania do nawigacja w dowolnym terenie.

### 4.4. Nawigacja w nierównym terenie

W pracy "Autonomous mobile robot navigation in uneven and unstructured indoor environments"[19] wykorzystano robota mobilnego (rys. 4.4) wyposazonego w LiDAR o ˙ niskiej rozdzielczości. Robot nawiguje w nieusystematyzowanym środowisku, jest ono jednak uproszczone względem naturalnego - reprezentowane przez rampy i bryły. Pewnym ograniczeniem jest tu zastosowanie robota nie terenowego.

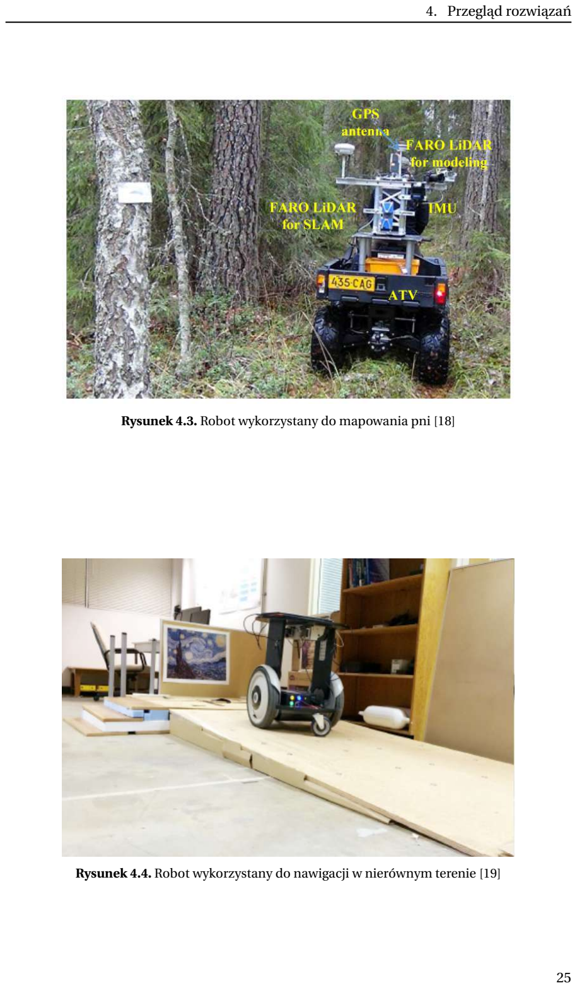
[picture p15: page 25]

4. Przegl ąd rozwi ązań

Rysunek 4.3. Robot wykorzystany do mapowania pni [18]

Rysunek 4.4. Robot wykorzystany do nawigacji w nierównym terenie [19]

## 5. Projekt systemu

### 5.1. Struktura systemu

Zaprojektowany system składa się z kilku kluczowych modułów, reprezentuj ących zarówno fizyczne urz ądzenia, jak i fragmenty oprogramowania. Strukturę systemu przedstawiono na rys. 5.1. Komunikację pomiędzy poszczególnymi modułami przedstawiono na rys. 5.2. Ponadto, system mozna podzielić na warstwę sprzętow ą, niskopoziomow ą i ˙ wysokopoziomow ą.

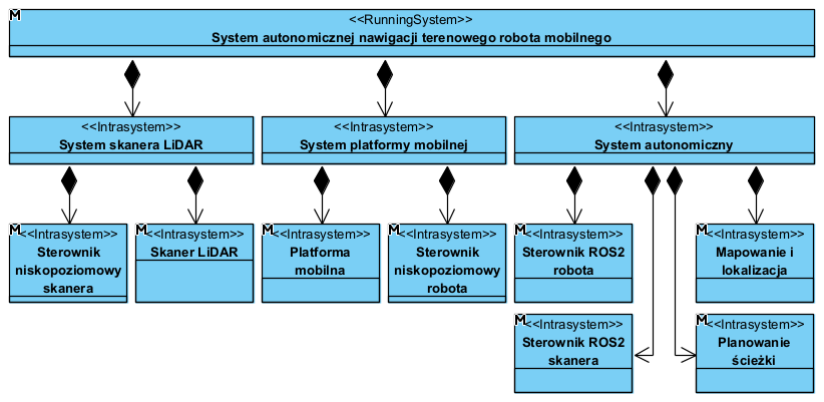
[picture p16: figure]

Rysunek 5.1. Proponowana kompozycja systemu

Warstwa sprzętowa to fizyczna czę´sć systemu, obejmuj ąca wszystkie urz ądzenia, komponenty elektroniczne, czujniki, efektory. Składaj ą się na ni ą:
- Fizyczna platforma mobilna, z efektorami (silniki napędowe) i zainstalowanymi

czujnikami.
- Moduł skanera LiDAR, z efektorami (silniki poruszaj ące mechanizmem) i czujnikiem

odległości.

Warstwa niskopoziomowa to element systemu, który zajmuje się bezpośrednim sterowaniem sprzętem i realizacj ą podstawowych funkcji, często w kontekście interakcji z fizycznym środowiskiem. Składaj ą się na ni ą:
- Sterownik robota, odpowiadaj ący za kontrolę silników powoduj ących ruch robota i

przesyłanie do warstwy wysokopoziomowej danych z czujników.
- Sterownik skanera, komponent zarz ądzaj ący działaniem skanera LiDAR, kontroluj ący

ruch głowicy skanuj ącej i przesyłaj ący pomiary.

Warstwa wysokopoziomowa to fragment systemu, który obejmuje bardziej złozone ˙ funkcje i algorytmy, działaj ące na wyzszym poziomie abstrakcji. Jest odpowiedzialna za ˙ nawigację autonomiczn ą, gdzie jedyn ą informacj ą wymagan ą od uzytkownika s ą współ- ˙

5. Projekt systemu

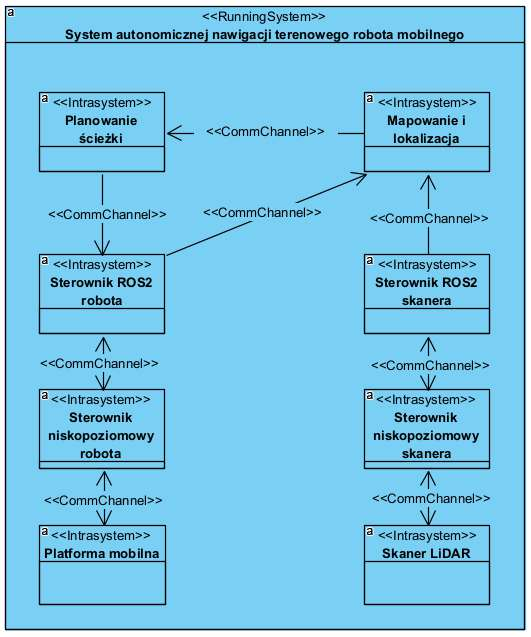
[picture p17: figure]

Rysunek 5.2. Proponowana struktura komunikacji

rzędne celu robota. W oparciu o te współrzędne oraz dane otrzymywane z nizszych warstw ˙ systemu, warstwa wysokopoziomowa przeprowadza autonomiczn ą nawigację, wykonuj ąc zadania opisane w sekcji 3.5.
Podział systemu na warstwy i moduły pozwala na oddzielenie róznych funkcjonalności ˙
i mozliwo´sć ich niezale ˙ | znej rozbudowy i testowania, pod warunkiem zachowania określo- ˙
nych interfejsów komunikacji. Ponadto wykonywanie funkcjonalności niskopoziomowych i wysokopoziomowych na oddzielnych urz ądzeniach, zapewnia ci ągło´sć działania. W kolejnych rozdziałach opisany zostanie projekt, realizacja i działanie wymienionych powyzej ˙ fragmentów systemu.

### 5.2. Skaner LiDAR

### 5.2.1. Projekt skanera

Zadaniem skanera LiDAR jest wykonanie skanu otoczenia, poprzez pomiar odległości pomiędzy czujnikiem a elementami środowiska, w wielu kierunkach, o określonej rozdziel-

5. Projekt systemu

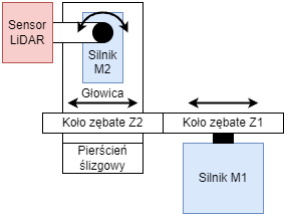
[picture p18: figure]

Rysunek 5.3. Szkic struktury mechanicznej skanera

czości. Poniewaz w pracy wykorzystany ma być jeden czujnik jednowymiarowy, konieczne ˙ jest zaprojektowanie mechanizmu obracaj ącego czujnikiem w dwóch osiach.
Czujnik powinien cechować się jak największ ą częstotliwości ą odczytów aby zmaksymalizować równiez częstotliwo´sć pełnych skanów. Zasięg sensora powinien być adekwatny ˙ do uzytku w otwartych przestrzeniach i przekraczać 10m. ˙
Przeszkody oraz obiekty charakterystyczne znajduj ą się w płaszczyźnie robota, na róznych wysokościach. Optymalne jest więc wykonanie skanu we wszystkich kierunkach w ˙ poziomie (obrót wokół osi z), oraz w róznych odchyleniach od płaszczyzny (obrót wokół ˙
osi y czujnika). Mozliwe byłoby równie ˙ | z skanowanie jedynie wycinka przestrzeni (np. ˙
z przodu robota), byłoby to jednak niepraktyczne - zmiana kierunku ruchu głowicy na
skrajach wycinka obci ązałaby silnik bezwładności ą głowicy i uniemo ˙ | zliwiałaby uzyskanie ˙
wysokich prędkości. Przy ci ągłym obrocie, bezwładno´sć głowicy jest utrzymywana. Skoro więc szybka zmiana kierunku ruchu jest kosztowna, optymalnym sposobem skanowania jest wykonywanie szybkich obrotów wokół osi z, zmieniaj ąc za kazdym razem ˙ nachylenie o pewien k ąt. Wówczas ruch którego zwrot musi być zmieniany będzie na
tyle wolny, ze nie obci ą ˙ | zy znacz ąco silnika i sterowanie nim nie będzie zaburzone przez ˙
bezwładno´sć.
Wybrany sposób poruszania wymaga dwóch silników. Silnik M1 obracaj ący głowic ą wokół osi z i silnik M2 nachylaj ący czujnik wokół osi y. Schemat opracowanej struktury przedstawiono na rys. 5.3. Obrót wokół osi z jest szybszy, wymaga więc silnika o większej mocy i masie. W łańcuchu kinematycznym umieszczony więc został on jako pierwszy, zamontowany do platformy mobilnej będ ącej podstaw ą. Porusza on głowic ą, do której zamontowany jest silnik M2, zmieniaj ący nachylenie sensora przegubem obrotowym.
Silnik M1 musi umozliwiać precyzyjne sterowanie pozycj ą - w ka ˙ | zdej chwili wykony- ˙
wania pomiaru kierunek musi być zgodny z zadanym, aby ten był poprawny. Ponadto, pomiary powinny następować w równych odstępach k ątowych. W powyzsze wymagania ˙

5. Projekt systemu

doskonale wpisuje się silnik krokowy. Wykonanie kroku następuje między odczytami i skutkuje przemieszczeniem głowicy do pozycji następnego pomiaru. Precyzja jest zachowywana w przypadku gdy kroki wykonywane s ą asynchronicznie (co moze nast ąpić, ˙ poniewaz czas wykonywania pomiaru przez LiDAR nie jest stały). Silnik krokowy wymaga ˙ dedykowanego sterownika, aby mozliwe było sterowanie nim za pomoc ą mikrokontrolera. ˙ Wymagania wobec silnika M2 s ą mniejsze, poniewaz mo ˙ ze poruszać się on wolniej. ˙ Priorytetem jest natomiast minimalna masa silnika, gdyz umieszczony jest na ruchomej ˙ głowicy. Sprawdzi się więc w tym przypadku serwomechanizm modelarski. Umozliwia on ˙ zadanie i utrzymanie pozycji.
Ci ągły obrót głowicy uniemozliwia wykorzystanie przewodów do zasilania i komunika- ˙ cji z czujnikiem i silnikiem M2. Zastosowany został więc pierścień ślizgowy, umozliwiaj ący ˙ transmisję bez skręcania przewodów poprzez szczotki i pierścienie do elementu obracaj ącego się. Pierścień uniemozliwia napędzanie obrotu współosiowo, dodana została więc ˙ przekładnia z dwóch kół zębatych (Z1 przyczepione do wału silnika krokowego, Z2 do obrotowej części pierścienia i głowicy).
Aby wykonać skan poprawnie, konieczna jest znajomo´sć centralnej pozycji skanera,
poniewaz silnik krokowy nie daje mo ˙ | zliwości pomiaru absolutnej pozycji. Aby j ą wykryć ˙
wykorzystany jest czujnik magnetyczny typu kontaktron.
Skaner ma obracać się z duz ą prędkości ą, konieczne jest więc ˙ | zeby jego środek cię ˙ | z-˙
kości znajdował się jak najblizej osi obrotu jak to mo ˙ | zliwe, aby zapewnić równomierne ˙
obci ązenie mechanizmu i ograniczyć wibracje. ˙

### 5.2.2. Sterownik niskopoziomowy skanera

System sterowania skanerem oparty jest na mikrokontrolerze, oddzielnym od mikrokontrolera obsługuj ącego niskopoziomowe funkcje łazika. Pozwala to ograniczyć potencjalne opóźnienia (które mogłyby wynikać z równoległej obsługi róznych sensorów), oraz ˙ ułatwić oddzielne testowanie skanera. Zadaniem układu jest akwizycja danych z sensora, sterowanie silnikami i przesyłanie danych.
Mikrokontroler obsługuje następuj ące urz ądzenia:
- LiDAR, wykorzystuj ąc interfejs I2C.
- Sterownik silnika krokowego do kontroli obrotu wokół osi z, poł ączony z silnikiem

krokowym za pomoc ą 4 przewodów fazowych, z wyprowadzeniami do sygnałów kroku i kierunku kroku podł ączonymi do mikrokontrolera. Kalibracja pr ądu sterownika i mikrokroków odbywa się poprzez zwory.
- Serwonapęd do sterowania obrotem wokół osi y, sterowany sygnałem PWM.
- Kontaktron do centrowania.

Układ komunikuje się z głównym komputerem za pośrednictwem protokołu UART przez kabel USB.
Oprogramowanie na mikrokontrolerze pozwala na:

5. Projekt systemu
- Zlecanie i odczyt pomiaru z czujnika LiDAR za pomoc ą odpowiednich wiadomości

przesyłanych protokołem I2C.
- Sterowanie silnikami poruszaj ącymi głowic ą.
- Otrzymywanie poleceń (start, stop) i ustawień przez UART.
- Przesyłanie pomiarów przez UART.
- Kalibrację i centrowanie skanera z wykorzystaniem kontaktronu. Głowica obraca się

wokół osi z do momentu rozł ączenia kontaktronu (po wcześniejszym zał ączeniu). Jako pozycja centralna wykorzystywana jest średnia pozycji rozł ączenia i zał ączenia.
- Rozpędzanie głowicy po rozpoczęciu skanowania - natychmiastowe zadanie peł-

nej prędkości silnikowi krokowemu doprowadziłoby do pomijania kroków i utraty pozycji.

Proces sterowania silnikami i przesyłania danych realizowany jest w czasie, gdy sensor dokonuje pomiaru, a operacje te s ą przerwane w chwili, gdy nadejdzie czas na odczyt.
Pomiary dokonywane s ą od najnizszej linii do najwy ˙ | zszej. Aby przeskoki między liniami ˙
były jak najmniejsze, po dotarciu do najwyzszej linii kierunek ruchu jest odwracany. ˙
Z zewn ątrz przez odpowiedni ą wiadomo´sć przesłan ą przez UART (gdy nie jest wykony-
wany skan) mozliwa jest zmiana ustawień wymienionych w tab. ˙ | 5.1.
Warto´sć | Jednostka | Opis
Rozdzielczo´sć mikrokroków | Liczba (1, 2, 4, 8) | Zmienia rozdzielczo´sć poziom ą skanu (odpowiednio 200, 400, 800, 1600).
Rozdzielczo´sć pionowa | Liczba całkowita | Zmienia rozdzielczo´sć pionow ą skanu (liczba róznych nachyleń). ˙
Minimalny k ąt nachylenia | Warto´sć w stopniach | Określa nachylenie najnizszej linii skanu. ˙ Warto´sć 90 stopni odpowiada skanom w płaszczyźnie skanera.
Krok skanu w pionie | Warto´sć w stopniach | Określa róznicę w k ącie pomiędzy ˙ pomiarami w pionie.
Maksymalny k ąt nachylenia | n.d. (wyliczany automatycznie) | Obliczany z wzoru (Minimalny k ąt + Krok w pionie · Rozdzielczo´sć pionowa)

Tabela 5.1. Ustawienia skanera

Pomiary przesyłane s ą pojedynczo protokołem UART, jako odległości w centymetrach, bez zbędnego przetwarzania. Kierunek danego odczytu określany jest w wysokopoziomowym sterowniku na podstawie kolejności napływaj ących danych. Aby umozliwić wykrycie ˙ błędu w transmisji np. pominięcia odczytu, na koniec kazdej linii i skanu przesyłane s ą ˙ dodatkowe znaki informacyjne.

### 5.3. Dostosowanie platformy mobilnej

Aby platforma mobilna mogła operować autonomicznie, konieczne jest rozszerzenie jej funkcjonalności. Musi być mozliwe sterowanie robotem poprzez komunikację z kom- ˙ puterem autonomii (w odróznieniu od domyślnego sposobu sterowania drog ą radiow ą) ˙

5. Projekt systemu

oraz platforma musi być wyposazona w dodatkowe czujniki dostarczaj ące informacji o ˙ połozeniu i orientacji robota. ˙

### 5.3.1. Czujniki

Poza skanerem LiDAR opisanym w rozdziale 5.2, platforma została wyposazona w IMU ˙ i odbiornik GNSS (opisane w sekcji 3.4).
Z IMU pozyskiwane s ą dane z akcelerometru, zyroskopu i magnetometru. Pomiar ˙ kierunku wektora przyspieszenia ziemskiego (z akcelerometru), oraz całkowanie warto-ści prędkości k ątowej (z zyroskopu) pozwala na precyzyjne obliczenie orientacji robota. ˙
Całkowanie prędkości k ątowej narazone jest na dryf w czasie (je ˙ | zeli rejestrowana jest ˙
niezerowa prędko´sć gdy sensor się nie obraca). Wykorzystanie kierunku wektora przyspieszenia ziemskiego pozwala skorygować ten bł ąd. W niniejszej pracy wykorzystane będzie bardziej kompleksowy sposób obliczania orientacji, opisany w sekcji 5.4.3. Dane z magnetometru pozwalaj ą na określenie kierunku północy, co zapewnia bezwzględn ą warto´sć obrotu robota wokół osi z. Dane z akcelerometru, po dwukrotnym całkowaniu, stanowi ą potencjalne źródło informacji do wyznaczenia połozenia robota. Dwukrotne ˙ całkowanie powoduje jednak kumulację błędów, co prowadzi do powstania znacznego dryfu w krótkim czasie i ogranicza praktyczn ą uzyteczno´sć tej informacji. ˙
Odbiornik GNSS pozwala na uzyskanie informacji o lokalizacji globalnej. Komunikacja z satelitami GNSS jest mozliwa w dowolnym miejscu, poza zamkniętymi przestrzeniami. ˙
Warto jednak podkreślić, ze dokładno´sć pomiarów GNSS mo ˙ | ze być podatna na zakłóce- ˙
nia, przez co precyzja pomiarów jest ograniczona do około ±1 m. Ponadto lokalizacja otrzymywana przez GNSS zmienia się w sposób skokowy, gdy otrzymywane s ą nowe dane.

### 5.3.2. Model ruchu

Robot jest kompatybilny z modelem ruchu napędu róznicowego, poniewa ˙ | z jego model ˙
ruchu stanowi rozszerzenie napędu róznicowego (omówione w sekcji ˙ | 3.2). Standardowo
robotowi zadawana jest prędko´sć liniowa wzdłuz osi ˙ | x (Vx ) oraz prędko´sć k ątowa wokół
osi z (ωz ). Wówczas wzory na prędko´sć k ątow ą kół prezentuj ą się następuj ąco [20]:

θ˙
L =

Vx
R

−

L ·ωz
2R
θ˙
R =

Vx
R

+

L ·ωz
2R

5. Projekt systemu

Gdzie:

Vx = prędko´sć liniowa

ωz = prędko´sć k ątowa

R = promień koła

L = odległo´sć między kołami
θ˙
L = prędko´sć k ątowa lewego koła θ˙
R = prędko´sć k ątowa prawego koła

Wyznaczony został wzór na k ąt wychylenia przegubu zaleznie od zadanych prędkości: ˙

α = 2arctan(

Dωz
Vx

)

Gdzie:

D = odległo´sć między przegubem

i osi ą wózka napędowego

α = k ąt skrętu

Warto´sć k ąta skrętu jest ograniczona mechanicznie do 90◦ ± 20,1

◦
. Gdy wymagane jest
większe wychylenie robot moze być sterowany jako standardowy napęd ró ˙ | znicowy (z ˙
zablokowanym przegubem w środkowej pozycji).
Wartości uzywanych we wzorach parametrów zostały zmierzone i wynosz ą: ˙

R = 59,3mm

L = 344mm

D = 192mm

### 5.3.3. Sterownik niskopoziomowy

Robot pierwotnie wyposazony był w sterownik niskopoziomowy bazuj ący na mikrokon- ˙ trolerze ATmega2560 w Arduino Mega 2560. Do mikrokontrolera podł ączono dodatkowo:
- IMU, wykorzystuj ąc interfejs I2C.
- GPS, wykorzystuj ąc interfejs UART.

Do oprogramowania zainstalowanego na mikrokontrolerze dodano obsługę oraz pozyskiwanie danych z wymienionych czujników. Dane z modułu GNSS nie wymagaj ą wstępnego przetwarzania. Konieczna natomiast była wstępna konfiguracja modułu. Czujnik IMU natomiast wymaga kalibracji. Proces kalibracji został opisany w sekcji 6.2.2. Ponadto dodano mozliwo´sć sterowania silnikami platformy poprzez interfejs UART. ˙

5. Projekt systemu

Otrzymywane s ą wiadomości ze sterowaniem, zgodne z opracowanym interfejsem przedstawionym w tab. 5.2.

Warto´sć | Jednostka | Opis
Prędko´sć lewa | Liczba (0 - 510) | Prędko´sć zadana kół z lewej strony. 255 odpowiada wył ączeniu, wartości > 255 jeździe w przód, < 255 jeździe w tył
Prędko´sć prawa | Liczba (0 - 510) | Prędko´sć zadana kół z prawej strony. 255 odpowiada wył ączeniu, wartości > 255 jeździe w przód, < 255 jeździe w tył
Wychylenie skrętu | Liczba (0 - 180) | Skręt centralnego przegubu. 90 odpowiada jeździe prosto, wartości > 90 skręcaniu w prawo, < 90 w lewo

Tabela 5.2. Interfejs sterowania robotem

Sterowanie jest realizowane w pętli otwartej ze względu na brak enkoderów w wyposa-
zeniu platformy mobilnej. Napędy korzystaj ą z przekładni o bardzo niskim przeło ˙ | zeniu, co ˙
skutkuje niewielkim obci ązeniem silników. Gdy silnik jest obci ą ˙ | zony małym momentem ˙
obrotowym, dana zmiana procentowa momentu (np. wynikaj ąca ze zmiany nachylenia terenu), powoduje proporcjonalnie mał ą zmianę prędkości, poniewaz zmiana prędkości ˙ silnika jest proporcjonalna do wartości zmiany obci ązaj ącego go momentu obrotowego ˙ [21]:

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
dω = −

R
k

2

·d M

Gdzie:

U = Napięcie zasilania

R = Rezystancja silnika

k = Współczynnik zalezny od projektu silnika ˙

M = Moment obrotowy

ω = Prędko´sć k ątowa silnika

Taka konfiguracja bezpośrednio przyczynia się do zwiększenia precyzji sterowania w pętli otwartej. Obliczanie współczynników do przeliczania prędkości zadanej na prędko´sć silników odbywa się w sekcji 5.4.2 zgodnie z wzorami wyznaczonymi w 5.3.2. Gdy wymagany k ąt skrętu jest większy od maksymalnego wychylenia przegubu, ale ponizej określonego ˙ progu, k ąt wychylenia przegubu utrzymywany jest na maksymalnej wartości. Powyzej tego ˙ progu przegub blokowany jest w pozycji środkowej.

5. Projekt systemu

System sterowania i komunikacji został zabezpieczony przed błędami. Po otrzymaniu zadanej wartości prędkości, jest ona utrzymywana do momentu nast ąpienia jednego z następuj ących wydarzeń:
- otrzymania nowej wiadomości z zadan ą prędkości ą (np. w szczególności prędkości

255 w celu zatrzymania),
- upłynięcia określonego limitu czasu od ostatniej wiadomości z prędkości ą (ustawione

na 0.5s co odpowiada przejechaniu przez robota maksymalnie 12 cm),
- utraty komunikacji radiowej ze stacj ą bazow ą (wykorzystywanej standardowo do

sterowania ręcznego robotem).

Ponadto, platforma mobilna przesyła dane z czujników, równiez za pośrednictwem ˙ interfejsu UART. Przesyłane s ą bezpośrednio, skalibrowane dane, pozyskane z sensorów.

### 5.4. Obsługa sprzętu w systemie ROS2

Aby umozliwić integrację sprzętu w systemie ROS, konieczne jest stworzenie dedykowa- ˙ nych sterowników zapewniaj ących skuteczn ą komunikację z urz ądzeniami. Te sterowniki powinny równiez wspierać standardy komunikacji wewn ątrz ROS2 poprzez subskrybo- ˙ wanie i publikowanie wiadomości odpowiedniego typu, które zawieraj ą dane z sensorów oraz polecenia steruj ące dla robota. Taka implementacja umozliwi efektywn ą interak- ˙
cję z innymi węzłami w systemie ROS2 oraz umozliwi wizualizację danych przy u ˙ | zyciu ˙
zintegrowanej aplikacji RVIZ.

### 5.4.1. Obsługa skanera

Utworzono węzeł ROS dedykowany do obsługi skanera. Po uruchomieniu węzła przesyłane s ą do skanera ustawienia rozdzielczości (ustawiane jako parametry ROS) i polecenie rozpoczęcia skanowania. Po kalibracji i rozpędzeniu głowicy przesyłane s ą pomiary. Głównym zadaniem węzła jest przetworzenie otrzymywanych pomiarów w chmurę punktów. W ROS2 chmura punktów standardowo przesyłana jest jako wiadomo´sć typu sensor_msgs/PointCloud2 [22] na temacie /lidar_scan. Ma ona zawierać listę współrzędnych punktów. Na podstawie kolejności otrzymywanych punktów, określany jest kierunek w jakim skierowany był sensor podczas wykonywania danego pomiaru i obliczane s ą współrzędne punktu w przestrzeni odpowiadaj ące pomiarowi, zgodnie z wzorami:

x = d · cosφ· sinθ

y = d · cosφ· cosθ

z = d · sinφ

5. Projekt systemu

Gdzie:

φ = K ąt pionowy

θ = K ąt poziomy

d = Odległo´sć z pomiarów

x = Współrzędna x w przestrzeni

y = Współrzędna y w przestrzeni

z = Współrzędna z w przestrzeni

Następnie po otrzymaniu wszystkich punktów z danego skanu, publikowana jest wiadomo´sć PointCloud2, z odpowiedni ą sygnatur ą czasow ą i układem współrzędnych.

### 5.4.2. Obsługa robota

Utworzono węzeł ROS dedykowany do obsługi platformy mobilnej. Węzeł odbiera od sterownika platformy mobilnej dane z IMU i odbiornika GNSS (3.4), oraz przesyła do robota informacje o prędkości.
Węzeł subskrybuje w ROS temat /cmd_vel, na którym publikowana jest zadana prędko´sć. Gdy otrzymana jest nowa wiadomo´sć, jest ona przeliczana na prędkości kół oraz nachylenie przegubu, zgodnie z wzorami w sekcji 5.3.2. Następnie jest przeliczana do zakresu wartości [0, 510] do sterowania w pętli otwartej, tak aby maksymalne prędkości w obu kierunkach ruchu odpowiadały wartościom na skraju przedziału. Skręt przegubu jest przeliczany do zakresu [0, 180]. Prędko´sć jest ponadto ograniczana aby nie przekroczyła wartości maksymalnej.
Gdy otrzymane s ą dane z IMU przez interfejs UART. Jednostki zostaj ą przekonwertowane do standardowych dla ROS, aby dane mogły być poprawnie interpretowane. Następnie zostaj ą opublikowane na tematach /imu/data_raw (przyspieszenie, prędko´sć k ątowa) i /imu/mag (wektor pola magnetycznego). Dane musz ą być podzielone na 2 tematy ze względu na typ danych wiadomości w systemie ROS - wiadomo´sć typu sensor_msgs/Imu
[23] powinna zawierać orientację robota, nie wektor pola magnetycznego. Konieczne będzie więc dokonanie dalszego przetwarzania.
Dane z GNSS po otrzymaniu zostaj ą publikowane na temacie /gps_rover w wiadomości typu sensor_msgs/NavSatFix [24]. Na podstawie uzyskanych wartości błędu generowana jest macierz kowariancji błędu sensora.
Ze względu na brak enkoderów na kołach robota, utworzony został dodatkowy węzeł, generuj ący informacje o odometrii kół na podstawie zadanej prędkości. Nie zastępuje rzeczywistych danych o prędkości pojazdu, ale moze być wykorzystana jako dodatkowe ˙ źródło informacji o ograniczonej dokładności.

5. Projekt systemu

### 5.4.3. Przetwarzanie IMU

Aby uzyskać dane o orientacji i utworzyć pełn ą wiadomo´sć w systemie ROS, konieczne jest dokonanie dodatkowego przetwarzania na danych w temacie /imu/data_raw. W tym celu został wykorzystany filtr komplementarny (3.9). Na podstawie danych z zyroskopu ˙ i akcelerometru, filtr komplementarny eliminuje dryf pomiarowy i zapewnia stabiln ą orientację obiektu. Węzeł publikuje wiadomo´sć ze skomponowanymi danymi z IMU (generowany jest kwaternion orientacji) na temacie /imu/data.

### 5.5. System autonomiczny

### 5.5.1. Struktura oprogramowania wysokopoziomowego

Elementy opisane w sekcji 5.4 dostarczaj ą danych, umozliwiaj ących utworzenie funk- ˙ cjonalnego oprogramowania zarz ądzajacego nawigacj ą autonomiczn ą. Oprogramowa-
nie musi umozliwiać lokalizację robota, mapowanie, planowanie ście ˙ | zki i jej wykonanie. ˙
Opracowano strukturę wykonuj ąc ą te zadania, przedstawion ą na rys. 5.4. Komunikację pomiędzy modułami przedstawiono na rys. 5.5

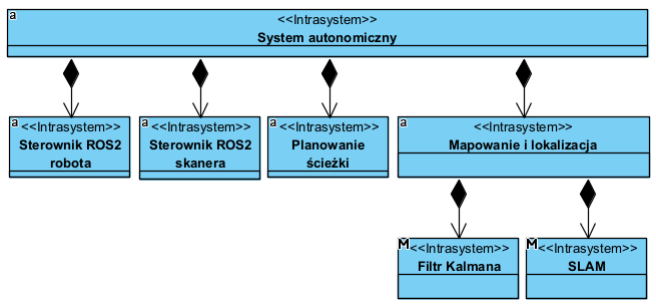
[picture p19: figure]

Rysunek 5.4. Proponowana struktura oprogramowania

Lokalizacja, zgodnie z konwencj ą opisan ą w sekcji 3.7 została podzielona na lokalizację lokaln ą i globaln ą. Lokalizacja lokalna realizowana jest z wykorzystaniem filtru kalmana (3.10), na podstawie danych z IMU i zadanej prędkości kół. Dostarcza informację o lokalizacji robota w układzie odniesienia odometrii. Lokalizacja globalna natomiast, generowana jest z wykorzystaniem algorytmu SLAM (3.8), na podstawie skanów z LiDARA
a takze danych z czujników IMU i GPS. Algorytm tworzy równie ˙ | z mapę otoczenia. W efekcie ˙
uzyskane jest przesunięcie układu odom względem układu map (z lokalizacji globalnej) i przesunięcie robota względem układu odom (z odometrii).
Dysponuj ąc lokalizacj ą robota, map ą otoczenia i zadanymi współrzędnymi celu, za-
daniem planera jest wygenerowanie ściezki po której ma poruszać się robot. ˙ | Scie ´ | zka ta ˙

podobnie do lokalizacji jest podzielona na plan globalny, aktualizowany z nisk ą częstotli-

5. Projekt systemu

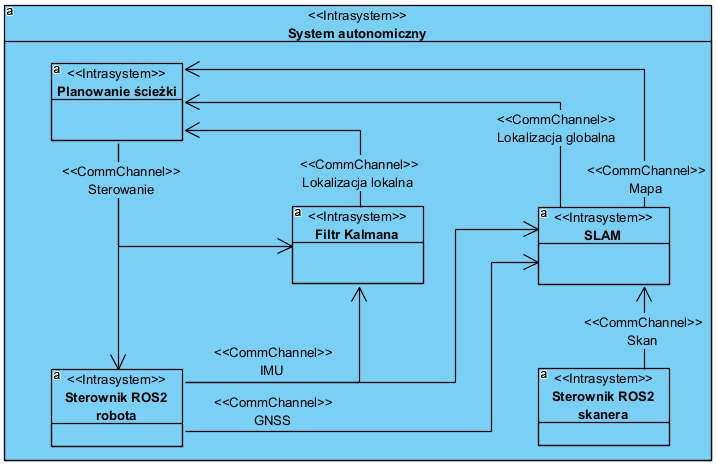
[picture p20: figure]

Rysunek 5.5. Proponowana struktura oprogramowania

wości ą i uwzględniaj ący topologię terenu oraz plan lokalny, bior ący pod uwagę pobliskie przeszkody. Następnie ściezka jest wykonywana, poprzez zadanie odpowiedniej prędkości ˙ liniowej i k ątowej robota.

### 5.5.2. Lokalizacja

Filtr Kalmana uzywany do lokalizacji lokalnej wykorzystuje jedynie informacje o orien- ˙ tacji z IMU. Wykorzystanie informacji o prędkości k ątowej doprowadziłoby do dwukrotnego wykorzystania tych samych danych - orientacja jest obliczana na podstawie danych z zyroskopu przez filtr komplementarny. Wykorzystanie przyspieszenia mogłoby pozwolić ˙ na obliczanie przesunięcia robota, ale doprowadziłoby do duzego dryfu lokalizacji spowo- ˙ dowanego przez dwukrotne całkowanie przyspieszenia. Ponadto filtr wykorzystuje zadan ą prędko´sć liniow ą. Zadana prędko´sć k ątowa została pominięta, poniewaz IMU jest znacznie ˙ precyzyjniejszym źródłem orientacji. Prędko´sć zadana zastępuje bezpośrednie dane o
prędkości kół, gdyz platforma nie jest wyposa ˙ | zona w enkodery. ˙
Do lokalizacji globalnej wykorzystany został algorytm SLAM w wersji trójwymiarowej. Jego zadaniem jest dopasowywanie chmur punktów ze skanów do przechowywanej w pamięci mapy otoczenia. Zastosowanie trójwymiarowej wersji algorytmu jest kluczowe
przy nawigacji w nieusystematyzowanym terenie - robot moze znajdować się pod ró ˙ | znymi ˙
nachyleniami, oraz zmienia połozenie równie ˙ | z w osi pionowej. Dane o orientacji otrzymy- ˙
wane z IMU s ą wykorzystywane przez algorytm do ograniczenia mozliwych przekształceń ˙ pomiędzy map ą a nowymi skanami. Ponadto dane otrzymane przez SLAM s ą ł ączone

5. Projekt systemu

ze współrzędnymi pochodz ącymi z odbiornika GNSS. Współrzędne GNSS cechuj ą się zdecydowanie mniejsz ą dokładności ą niz dopasowania skanów, ale pomagaj ą wyelimi- ˙ nować dryf lokalizacji podczas długich przejazdów, oraz porównać mapę globaln ą do rzeczywistych współrzędnych geograficznych.

### 5.5.3. Mapowanie

Trójwymiarowa mapa otoczenia generowana jest równiez przez algorytm SLAM. Jed- ˙ nakze planowanie trajektorii robota w przestrzeni byłoby problematyczne - robot, jako ˙ pojazd l ądowy, zdolny jest jedynie to sterowania prędkości ą w płaszczyźnie. Wobec tego generowane s ą na biez ąco dwuwymiarowe mapy kosztu otoczenia (ang. costmap), lokalna ˙ i globalna, przeznaczone do wyznaczania trajektorii. Koszt na mapie reprezentuje trudno´sć przejechania danego fragmentu przez robota. Mapa lokalna odnosi się do niewielkiego obszaru w bezpośrednim s ąsiedztwie robota i jest aktualizowana na podstawie najnowszych skanów otoczenia. Mapa globalna obejmuje cały obszar znanego środowiska, w którym porusza się robot. Aktualizowana jest równiez ze skanów LiDAR i wykorzystuje ˙ lokalizację wyznaczon ą przez algorytm SLAM. W mapach stosowana jest tzw. inflacja -wykryte przeszkody s ą powiększane, aby zmniejszyć prawdopodobieństwo kolizji robota.

### 5.5.4. Planowanie

Na podstawie dwuwymiarowej mapy globalnej, i celu zdanego przez operatora opracowywana jest ściezka prowadz ąca od lokalizacji robota do docelowych współrzędnych. ˙
Scie ´ | zka omija znane przeszkody znajduj ące się na mapie, bior ąc równie ˙ | z pod uwagę ich ˙
inflację. Scie ´ | zka globalna nie jest jednak ˙ | ze realizowana w czasie rzeczywistym - to bezpo- ˙

średniego sterowania robotem w czasie rzeczywistym wykorzystywana jest mapa lokalna i umieszczane na niej dynamicznie wykrywane przeszkody. Kierunek ściezki globalnej jest ˙ celem dla planera lokalnego. Planer lokalny bezpośrednio oblicza zadan ą prędko´sć dla robota, bior ąc pod uwagę mobilno´sć platformy.

## 6. Realizacja projektu

Utworzone zasoby s ą udostępnione w repozytorium w serwisie github [25] .

### 6.1. Realizacja skanera

### 6.1.1. Budowa skanera

Zrealizowane zostały dwie wersje skanera. Opisana zostanie implementacja ostatecznej wersji, a następnie przedstawione będ ą problemy pierwotnej wersji oraz sposób ich naprawy. Ostateczn ą wersję przedstawiono na rys. 6.1.

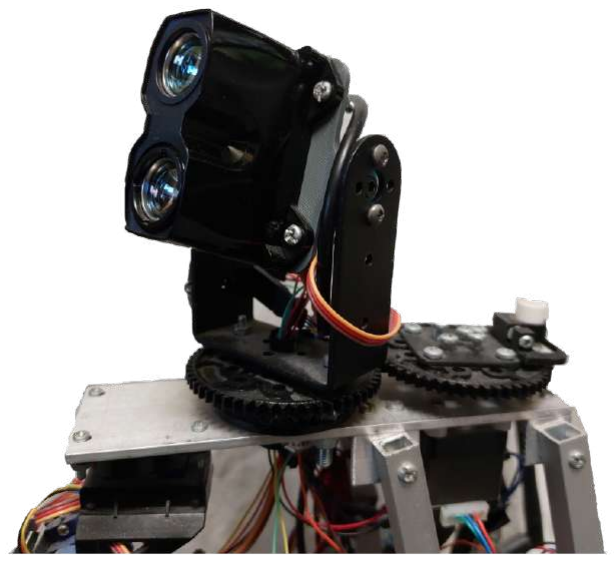
[picture p21: figure]

Rysunek 6.1. Skaner LiDAR

Jako punkt montazu skanera wybrano najwy ˙ | zszy punkt platformy mobilnej, na szczycie ˙
masztu sensoryczno-komunikacyjnego. Pozwala to zminimalizować przysłanianie otoczenia przez robota, oraz zapewnić większe pole widzenia, dalej od podłoza. Na szczycie ˙ masztu zamontowano silnik krokowy, pierścień ślizgowy i przekładnię zębat ą z przełoze- ˙ niem 1:1. W efekcie na napędzanym kole zębatym uzyskano obrotowy punkt montazowy ˙ dla głowicy, z doprowadzonymi przewodami. Ponadto zainstalowany został kontaktron (detektor na szczycie platformy i magnes w określonej pozycji na kole zębatym). Wykorzystano silnik krokowy JK28HS32-0674 [26] w standardzie NEMA 11. Zapewnia on wystarczaj ący moment obrotowy i prędko´sć, zachowuj ąc nisk ą jak na silnik krokowy masę. Ma on rozdzielczo´sć wynosz ąc ą 200 kroków na obrót, co odpowiada k ątowi 1,8 stopnia na krok.
Dodany został mechanizm kalibracji kontaktronu – zaprojektowany został mechanizm umozliwiaj ący przesuwanie magnesu prostopadle do promienia zębatki, co przekłada się ˙

6. Realizacja projektu

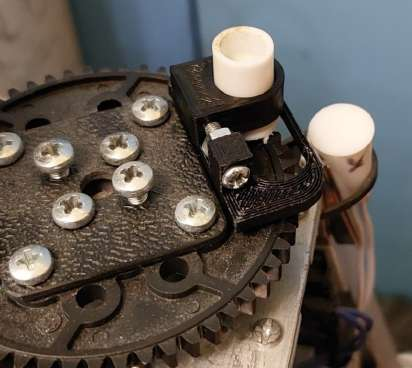
[picture p22: figure]

Rysunek 6.2. Mechanizm kalibracji kontaktronu

na kalibracje k ąta uznawanego za środkow ą pozycję LiDARu (rys. 6.2). Wykonany został w technologii druku 3D.
Do koła zębatego zamontowana została aluminiowa rama głowicy, sztywno poł ączona z wałem silnika M2. Wybrany został serwomechanizm TowerPro SG-90 [27] o masie 9g. Obudowa silnika i czujnik odległości poł ączone zostały za pomoc ą dedykowanego zaprojektowanego elementu wykonanego technologi ą druku 3D. W efekcie, ruch wału silnika powoduje zmianę nachylenia sensora.
Do pomiaru odległości wybrany został moduł firmy Garmin, Lidar Lite V3 HP [28]. Moduł pozwala na dokonywanie odczytów z częstotliwości ą do 1500 Hz na odległo´sć do 40m. Mozliwa jest komunikacja z nim za pośrednictwem interfejsu I2C. ˙
Czujnik wazy 38 g i nie jest umieszczony na osi obrotu głowicy. W celu osi ągnięcia ˙ równowagi, konieczne było zainstalowanie przeciwwagi symetrycznie względem sensora. Przeciwwaga została dobrana tak, aby środek cięzkości całego zespołu sensora (czujnik, ˙ element drukowany, silnik M2 i przeciwwaga) znajdował się na obu osiach obrotu skanera. Dzięki temu konstrukcja jest zbalansowana niezaleznie od orientacji sensora. Rozmieszcze- ˙ nie podzespołów zostało starannie dobrane, aby zminimalizować moment bezwładności modułu. Wybrano modele o jak najmniejszej masie, umieszczone jak najblizej osi obrotu ˙ (minimalne ramię momentu).
Silnik M1 sterowany jest za pomoc ą sterownika silników krokowych Pololu 2968 [29] bazuj ącego na układzie MP6500. Pozwala on na poruszanie silnikiem w trybie mikrokroków (do 1/8 kroku), co zwiększa rozdzielczo´sć obrotu silnika na 1600 mikrokroków/obrót. Sterownik zasilany jest pr ądem 1A i napięciem 32V (bliskim maksymalnemu), aby uzyskać jak
najwyzszy moment obrotowy przy wysokich prędkościach [ ˙ | 30]. Wyzsze napięcie powoduje ˙
szybsze narastanie zboczy sygnału na fazach, przy tym samym pr ądzie ustawionym w sterowniku.
Jako sterownik skanera, wybrany został mikrokontroler ATMega 328 w Arduino Nano

6. Realizacja projektu

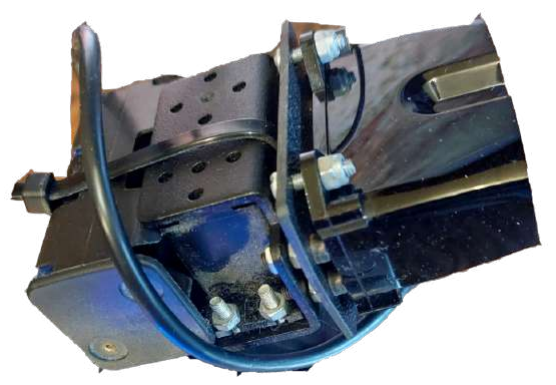
[picture p23: figure]

Rysunek 6.3. Stara wersja zespołu czujnika

z uwagi na wystarczaj ące mozliwości obliczeniowe, dostępn ą liczbę wyprowadzeń i ko- ˙ rzystn ą cenę. Sterownik widoczny jest na rys. 6.7.
Do obsługi czujnika LiDAR wykorzystano dedykowan ą bibliotekę LIDARLite_v3HP [31].
W konfiguracji biblioteki dodana została własna konfiguracja czujnika, pozwalaj ąca na wykonywanie szybszych odczytów poprzez ograniczenie liczby powtórzeń odczytów (SIG_COUNT_VAL, REF_COUNT_VAL) oraz zmianę trybu szybkiego zako ńczenia odczytu (ACQ_CONFIG_REG). Parametry s ą opisane w dokumentacji sensora [28].
Aby zwiększyć stabilno´sć czasu pomiaru, wprowadzono dodatkowe opóźnienia, równowazne czasowi zmiany nachylenia skanera, gdy w danym pomiarze nie zachodzi jego ˙ zmiana. Wprowadzono równiez opóźnienia stabilizuj ące czas przesyłania wyniku skanu, ˙ bez względu na ilo´sć przesyłanych znaków (liczbę cyfr wyniku w centymetrach). Inne podej-ścia mogę wydawać się skuteczniejsze, na przykład zastosowanie przerwań od wyst ąpienia zdarzenia uzyskania nowego wyniku, czy wykorzystanie timerów. Pierwsze podejście nie było jednak mozliwe - czujnik nie udostępnia przerwań. Drugie podejście nie pozwala- ˙ łoby wykorzystać pewnych róznic w czasach pomiarów, więc wszystkie skany musiałyby ˙ być wykonywane z równ ą, mniejsz ą częstotliwości ą. Opóźnienia dobrano mierz ąc czas wykonywania równowazonych operacji w mikrosekundach na mikrokontrolerze. ˙

### 6.1.2. Porównanie wersji skanera

Najpierw została zbudowana wstępna wersja skanera, nie stosuj ąca elementów wy-
konanych w druku 3D i wykorzystuj ąca większy i cięzszy serwonapęd (rys. ˙ | 6.3. W efekcie
waga zespołu czujnika wynosiła 167g (w porównaniu do 80g w najnowszej wersji).
Stara wersja borykała się z duz ą bezwładności ą, powoduj ąc ą niekiedy pomijanie kro- ˙ ków przez silnik, co doprowadzało do skorumpowania skanu. Redukcja wagi wyeliminowała to zjawisko poprzez zmniejszenie obci ązenia silnika. Ponadto, stara wersja ce- ˙ chowała się niezbalansowaniem, co doprowadzało do obserwowalnych oscylacji wiezy˙

6. Realizacja projektu

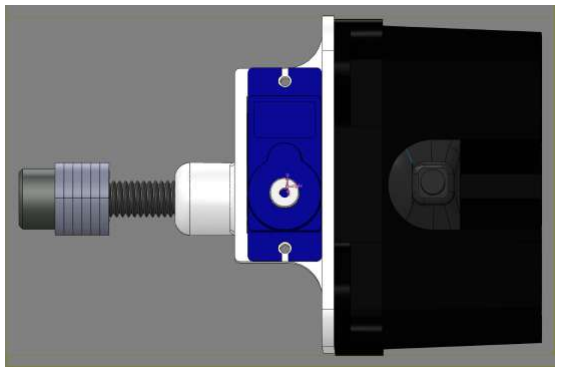
[picture p24: figure]

Rysunek 6.4. Symulacja środka cięzkości zespołu czujnika ˙

komunikacyjno-sensorycznej, zaburzaj ących stabilno´sć pomiaru. W nowej wersji więc, przygotowany został model 3D i połozenie oraz masa przeciwwagi została dobrana w ˙ symulacji w programie Solidworks, tak, aby środek cięzkości zespołu sensora znajdował ˙ się na osiach obrotu sensora (rys. 6.4). Ponadto, dzięki wykorzystaniu śruby jako przeciw-
wagi mozliwe było dostrojenie środka cię ˙ | zkości na fizycznym obiekcie. Waga przeciwwagi ˙
została dostosowana poprzez obserwację oscylacji masztu. Nagranie filmu w zwolnio-
nym tempie pozwoliło na obserwację środka cięzkości głowicy. Zastosowano równie ˙ | z˙
dodatkow ą przeciwwagę na głowicy, aby zbalansować j ą wzdłuz osi ˙ | y.

### 6.2. Dostosowanie platformy mobilnej

### 6.2.1. Czujniki

Jako sensor IMU w projekcie zastosowany został czujnik Grove IMU 9DOF v2.0 [13], bazuj ący na układzie MPU-9250. Pozwala na odczyt wartości z dokładności ą do 16 bit i komunikację przez magistralę I2C.
Istotnym aspektem było umieszczenie czujnika na robocie. Sensor został zamontowany w poziomie, zgodnie z orientacjami osi. Magnetometr jest wrazliwy na zakłócenia pola ˙ magnetycznego, które mog ą być powodowane przez silniki, przewody pr ądu, lub duze˙ elementy wykonane z ferromagnetyków. Czujnik został więc umieszczony na maszcie robota, z dala od innych komponentów (rys. 6.5). Pole magnetyczne w tym miejscu zostało wcześniej zmierzone (43µT ), i nie odbiegało od typowych wartości (średnio 45µT w pomieszczeniu). W głównej części robota pole ma warto´sć ok. 100µT . Do montazu˙ zaprojektowany został dedykowany element, wytworzony metod ą druku 3D.
Jako odbiornik GNSS wykorzystany został Ublox NEO-M8N [32]. Jest on kompatybilny ze wspomnianymi systemami satelit i jest wyposazony w zintegrowan ą antenę. Komunika- ˙ cja z modułem odbywa się przez protokół UART.
Odbiornik został równiez umieszczony na maszcie platformy mobilnej, przesunięty w ˙ bok aby ograniczyć przysłanianie satelit przez resztę masztu. Antena została skierowana

6. Realizacja projektu

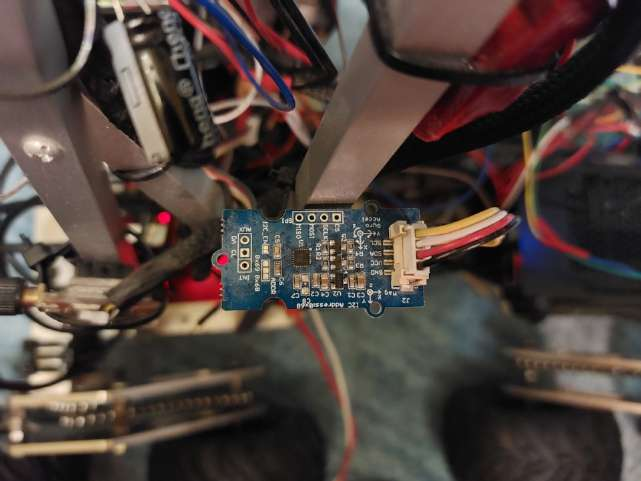
[picture p25: figure]

Rysunek 6.5. Czujnik Grove IMU 9DOF v2.0 zamontowany na robocie

pionowo w górę by zapewnić widoczno´sć satelit na całym niebie (rys. 6.6). Do montazu˙ zaprojektowany został dedykowany element, wytworzony metod ą druku 3D.

### 6.2.2. Sterownik niskopoziomowy

Sterownik niskopoziomowy stanowi rozwinięcie pierwotnego sterownika robota, wykorzystuj ącego mikrokontroler ATmega2560. Sterownik widoczny jest na rys. 6.7.
Do obsługi IMU wykorzystano bibliotekę MPU9250[33]. Proces kalibracji magnetometru odbywa się za pomoc ą wbudowanych funkcji dostępnych w bibliotekę. Kalibracja
polega na zbieraniu danych w róznych orientacjach. Natomiast kalibracja ˙ | zyroskopu ˙
przeprowadzana została ręcznie przez autora. Przeprowadzono akwizycję danych, gdy czujnik był w spoczynku. Odczyty s ą przesuwane o średni ą warto´sć zarejestrowanych pomiarów, aby podczas działania czujnika nie następował dryf orientacji. W przypadku akcelerometru kazda o´s została przeskalowana tak, aby warto´sć odpowiadała przyspieszeniu ˙ grawitacyjnemu, gdy czujnik był umieszczony zgodnie ze zwrotem danej osi w pionie. Moduł GNSS obsługiwany jest przez bibliotekę NeoGPS[34]. Moduł został skonfigurowany aby uzyskać wybrane wiadomości w standardzie NMEA [35] przy maksymalnej częstotliwości odczytu, poprzez przesłanie odpowiednich ramek z danymi. Wybrane zostały wiadomości w standardzie NMEA: RMC, GGA, GST - zapewniaj ące współrzędne geograficzne z wysokości ą oraz dokładno´sć pomiaru (odchylenie standardowe pozycji). Zmieniona została częstotliwo´sć odczytu na maksymaln ą mozliw ą przy wybranych wiado- ˙ mościach, wynosz ąc ą 4Hz.

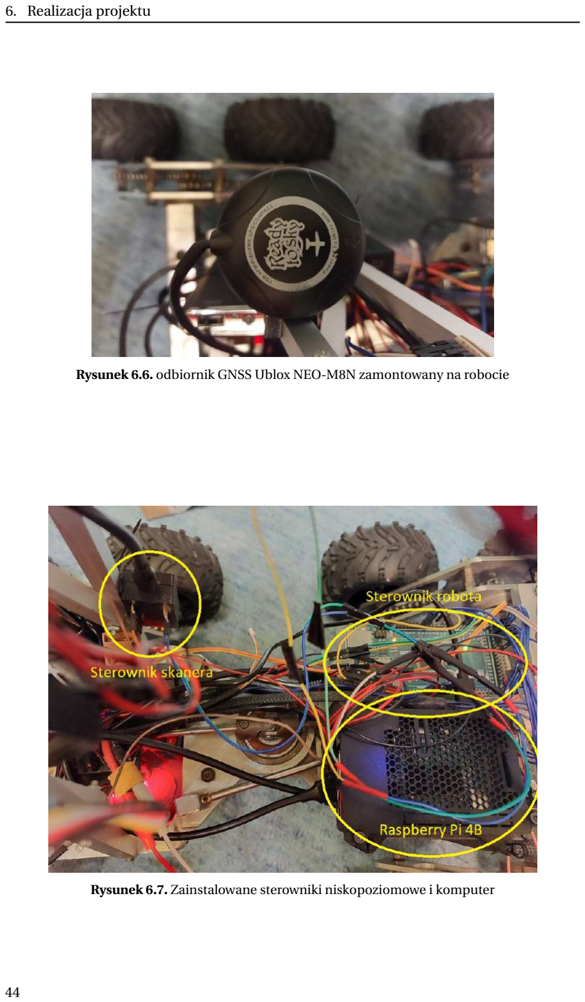
[picture p26: page 44]

6. Realizacja projektu

Rysunek 6.6. odbiornik GNSS Ublox NEO-M8N zamontowany na robocie

Rysunek 6.7. Zainstalowane sterowniki niskopoziomowe i komputer

6. Realizacja projektu

### 6.3. Obsługa sprzętu w systemie ROS2

Główny komputer wykorzystywany w sekcji autonomicznej to Raspberry Pi 4B. Jest to kompaktowy komputer jednopłytkowy. Czterordzeniowy procesor ARM Cortex-A72, oraz 4GB pamięci RAM w wybranym wariancie zapewniaj ą wystarczaj ąc ą wydajno´sć do obsługi wysokopoziomowej części projektu. Niewielkie wymiary i pobór mocy ponizej ˙ 15W s ą adekwatne do wielkości robota i dostępnej pojemności baterii. Ponadto dzięki wystarczaj ącej mocy obliczeniowej, komputer nie ogranicza uzytkownika pod względem ˙ wyboru systemu operacyjnego, pozwalaj ąc wykorzystać standardowe dystrybucje. Wybrano systemem Ubuntu Server 22.04 LTS, pozbawiony interfejsu graficznego i zbędnych dodatków oraz kompatybilny z wybran ą wersj ą ROS2. Zainstalowany komputer widoczny jest na rys. 6.7.
Zarówno robot jak i skaner podł ączone zostały do głównego komputera przez UART, przewodami USB. Konieczna jest więc obsługa portu szeregowego w systemie. Aby ujednolicić działanie po podł ączeniu i odł ączeniu urz ądzeń (aby zachować stałe identyfikatory portów), dodano zasady udev mapuj ące urz ądzenia do własnych portów na podstawie identyfikatorów producenta i modelu, odpowiednio do ttyRVR dla łazika i ttyLID dla skanera.
Węzły ROS do obsługi skanera (lidar controller) i robota (rover controller) zostały zaimplementowane w języku Python. Do obsługi komunikacji szeregowej wykorzystano bibliotekę pySerial [36]. Skonfigurowano baud rate na maksymaln ą obsługiwan ą warto´sć 115200 bps. Istotne było skonfigurowanie limitów czasu dla komunikacji szeregowej, aby zapewnić płynn ą komunikację bez zbędnego oczekiwania. Realizacja przesyłania danych wykorzystuje mechanizm odwołań zwrotnych (ang. callback) aby zapewnić płynn ą obsługę róznych funkcji. Reakcja na wiadomości wewn ątrz systemu ROS odbywa się poprzez ˙ bezpośrednie odwołania, natomiast odbieranie danych od robota odbywa się poprzez timer.
Obsługa sprzętu została zabezpieczona na wypadek wył ączenia. W przypadku wył ączenia węzła steruj ącego skanerem, przesyłana jest komenda kończ ąca skanowanie i zatrzymuj ąca głowicę skanuj ąc ą, poprzez obsługę sygnału przerwania SIGINT. Dzięki temu głowica skanuj ąca nie porusza się gdy jest to zbędne i oszczędzana jest energia poprzez odcięcie zasilania silnika krokowego. W przypadku wył ączenia węzła odpowiedzialnego za komunikację z robotem, wysyłana jest komenda steruj ąca z zerow ą prędkości ą. Utworzono równiez węzeł odom cmd, zastępuj ący enkodery robota. Subskrybuje on ˙ wiadomości na temacie /cmd_vel i na ich podstawie generuje wiadomości na temacie /odom_cmd. Gdy nie jest zadawana prędko´sć, węzeł nadaje wiadomości z zerow ą prędko-ści ą. Ponadto, wygenerowano macierz kowariancji symulowanego czujnika - odchylenie standardowe prędkości określono na 10% prędkości maksymalnej, na podstawie pomiarów prędkości pojazdu na róznych nawierzchniach. ˙
Do generowania orientacji został wykorzystany filtr komplementarny w implementacji

6. Realizacja projektu

z biblioteki imu_tools: imu_complementary_filter [37]. Filtr został skonfigurowany, aby wykorzystywać dane z magnetometru.

### 6.4. System autonomiczny

### 6.4.1. Wstępne wymagania

Aby stworzyć system robotyczny z wykorzystaniem ROS2, niezbędne jest przeprowadzenie pocz ątkowej konfiguracji. W tym celu utworzono przestrzeń robocz ą projektu, a takze˙ przygotowano uproszczon ą reprezentację robota w formie pliku URDF. Konfiguracja URDF opisuje transformacje między układami współrzędnymi obecnymi w robocie, jednocześnie stanowi ąc wizualn ą reprezentację, któr ą mozna wykorzystać do wizualizacji. Schemat ˙ układów współrzędnych przedstawiono na rys. 6.8.

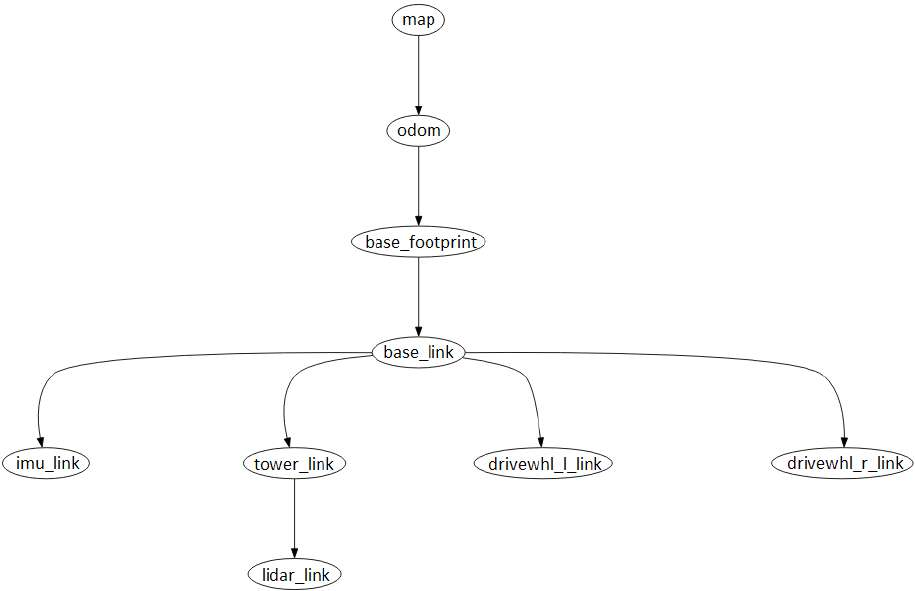
[picture p27: figure]

Rysunek 6.8. Układy współrzędnych w robocie

Następnie przygotowano plik uruchamiaj ący system w języku python, z wykorzystaniem biblioteki launch będ ącej części ą ROS2. Uruchamia on następuj ące programy:
- robot state publisher
- joint state publisher
- rviz2
- rover controller
- lidar controller
- odom cmd
- imu filter

6. Realizacja projektu

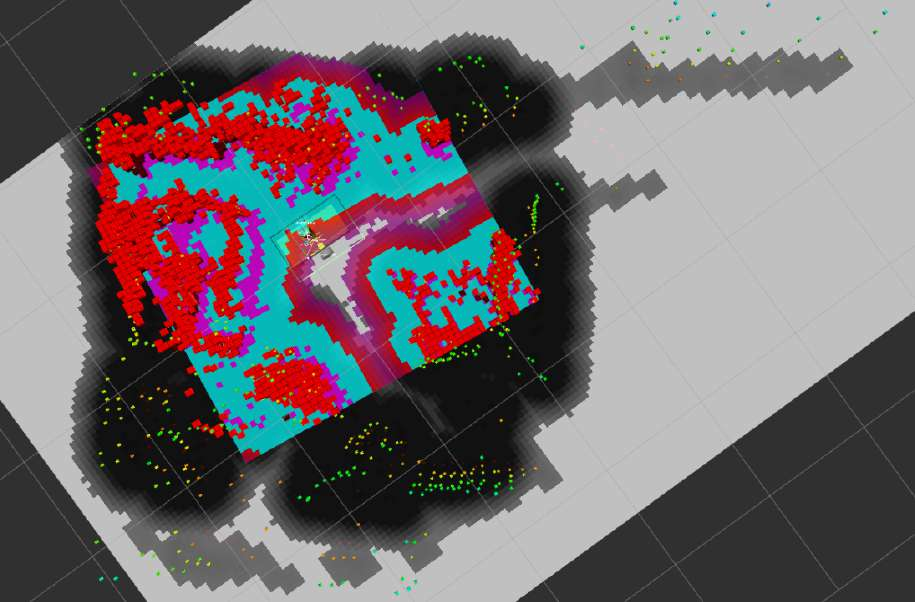
[picture p28: figure]

Rysunek 6.9. Wizualizacja działaj ącego systemu w RVIZ 2

- robot localiztion
- cartographer occupancy grid
- cartographer
- nav2
- nav2 costmap 2d markers

Robot state publisher i joint state publisher to standardowe narzędzia ROS, odpowiedzialne za publikowanie przekształceń pomiędzy układami współrzędnych, i stanu stawów pomiędzy nimi.
Węzeł rviz2 odpowiedzialny jest za wyświetlanie wizualizacji działania systemu (rys. 6.9). Uruchamiany jest jedynie w konfiguracji z aktywnym interfejsem graficznym. W wizualizacji zastosowano następuj ące oznaczenia, zgodnie ze standardem ROS:
- Mapa globalna - skala szarości, proporcjonalna do kosztu
- Mapa lokalna - koszt malej ący w kolejności magenta -> cyjan -> czerwony
- Robot - zółty ˙
- Najnowszy skan LiDAR - punkty, wysoko´sć punktu w osi z rosn ąca w kolejności

czerwony -> zielony
- Lokalne przeszkody - czerwone voxele

Węzły rover controller, lidar controller, odom cmd i imu filter to węzły których tworzenie opisano w sekcji 6.3. Pozostałe programy i ich role zostan ą opisane kolejno w dalszej części pracy.

6. Realizacja projektu

### 6.4.2. Odometria

Do lokalizacji lokalnej robota wykorzystano węzeł robot localization. Węzeł wykorzystuje ekf_filter_node z pakietu robot_localization [38], stanowi ący standardowe rozwi ązanie w systemie ROS. Węzeł bazuj ące na rozszerzonym filtrze Kalmana i publikuje przekształcenie z układu odom do układu robota. Został skonfigurowany, aby wykorzystywać dane o orientacji z imu zgodnie z planem projektowym. Z węzła odom cmd, do estymacji stanu wykorzystywana jest jedynie prędko´sć liniowa. Zadana prędko´sć k ątowa i rzeczywista
s ą zbyt rózne ze względu na poślizgi podczas skręcania, by dane były u ˙ | zyteczne. Zostało to ˙
potwierdzone eksperymentami, doł ączenie prędkości k ątowej pogarszało odwzorowanie. Przetestowano równiez działanie odometrii z wykorzystaniem przyspieszenia z akclero- ˙ metru. Mimo poprawnego działania po uruchomieniu, błędy szybko się kumulowały co doprowadzało do szybkiego dryfu lokalizacji lokalnej. Ponadto węzeł wykorzystuje otrzymywane kowariancje sensorów. Określono równiez ograniczenia przyspieszenia robota, ˙ na podstawie obserwacji czasu uzyskania maksymalnej prędkości przez platformę (0,5s dla przyspieszania i 0,25s dla zatrzymania).

### 6.4.3. SLAM

Zadania lokalizacji globalnej i mapowania otoczenia wykonywane s ą przez algorytm SLAM. Większo´sć dostępnych implementacji algorytmu, w tym te wbudowane w system ROS2, działa dla środowisk dwuwymiarowych i jest dostosowana do lokalizacji w pomieszczeniach z wykorzystaniem skanera 2D, co stanowi najpopularniejsz ą konfigurację robota mobilnego. W niniejszej pracy zastosowano trójwymiarowy algorytm SLAM, kompatybilny ze skanerami 3D. Tak ą funkcjonalno´sć dostarcza implementacja w bibliotece cartographer ros [39], integruj ącej z ROS rozwi ązanie firmy Google, Cartographer [40]. Rozwi ązanie zostało uruchomione w węźle cartographer. Węzeł publikuje przekształcenie z układu map do odom, oraz generowan ą mapę.
Biblioteka umozliwia zastosowanie szerokiej gamy sensorów, w tym skanerów 2D i ˙ 3D. Schemat jej działania przedstawiono na rys. 6.10 i opiera się na dwóch głównych komponentach:
- SLAM lokalny, wykorzystuj ący algorytm Ceres Scan Matcher. Dopasowuje on kolejne

skany, tworz ąc tzw. submapy. Wykorzystuje solwer Ceres [41] do zadania optymalizacji. Dopasowanie wspierane jest informacjami o względnym przesunięciu skanów, pozyskiwanymi z IMU i odometrii. Mechanizm został skonfigurowany przez autora podczas testów terenowych. Platforma poruszała się z zadan ą prędkości ą i obserwowano jako´sć lokalizacji. Zwiększono wagi przyporz ądkowane karom za przesunięcie i rotację skanu, do momentu wyeliminowania sytuacji gdy pozycja robota zmieniała się w sposób skokowy do innego, błędnego dopasowania. Zachowano przy tym ci ągło´sć trafnego odwzorowania zmian pozycji robota. Szczególnie zwiększona
została kara za rotację, poniewaz rotacja jest odwzorowana z du ˙ | z ą dokładności ą w ˙
transformacji odom -> robot.

6. Realizacja projektu

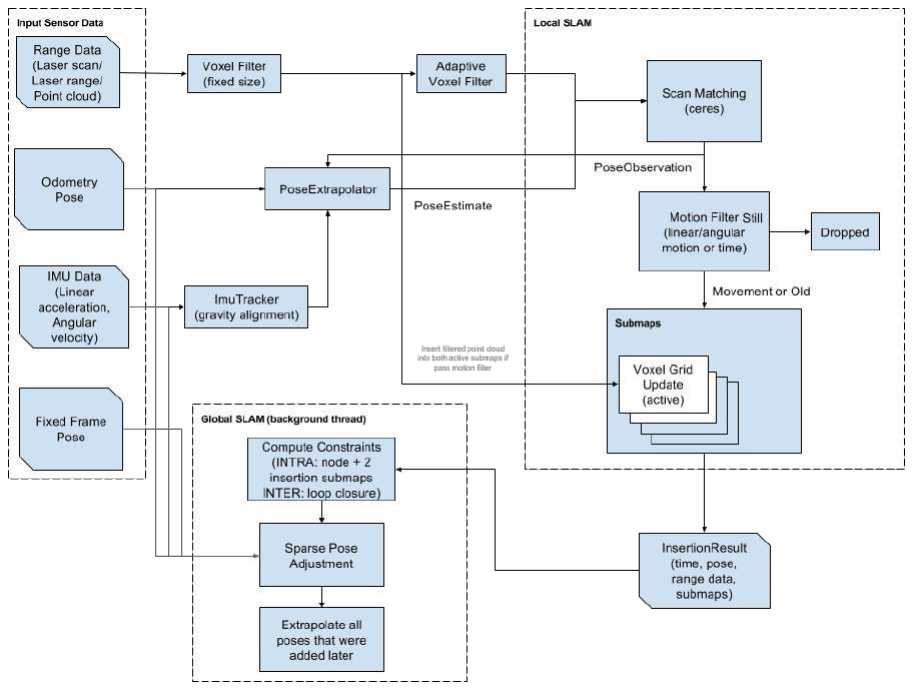
[picture p29: figure]

Rysunek 6.10. Schemat działania systemu cartographer [39]

- SLAM globalny, którego zadaniem jest optymalizacja wzajemnego ułozenia submap. ˙ Jest to wolniejszy mechanizm wykonywany w tle, rozwi ązuj ący równiez problem ˙ domykania pętli. Dzięki niemu uzyskiwana jest spójna mapa globalna. Ze względu na działanie na wysokim poziomie abstrakcji, nie było konieczna zmiana konfiguracji SLAM globalnego.

Ponadto wykorzystano węzeł cartographer occupancy grid, buduj ący na podstawie dopasowanych submap, pojedyncz ą globaln ą mapę kompatybiln ą z systemem ROS, zgodnie z dopasowaniami wygenerowanymi przez SLAM globalany.
Przetestowano równiez działanie algorytmu SLAM w wersji dwuwymiarowej, po prze- ˙ tworzeniu chmury punktów do dwuwymiarowego skanu. W takiej konfiguracji nie udało się uzyskać poprawnego działania lokalizacji, ze względu na zbyt nisk ą częstotliwo´sć i rozdzielczo´sć skanów.

### 6.4.4. System nawigacji

Do zrealizowania zadania nawigacji w zakresie planowania ściezki i jej wykonania, ˙ wykorzystano kompleksowe rozwi ązanie, jakim jest zestaw oprogramowania NAV 2 [42]. Jest to rozbudowany zbiór bibliotek, umozliwiaj ący pełn ą konfigurację mechanizmów ˙ sterowania robota w ramach systemu ROS2. Ogólny schemat systemu przedstawiono na rys. 6.11.

6. Realizacja projektu

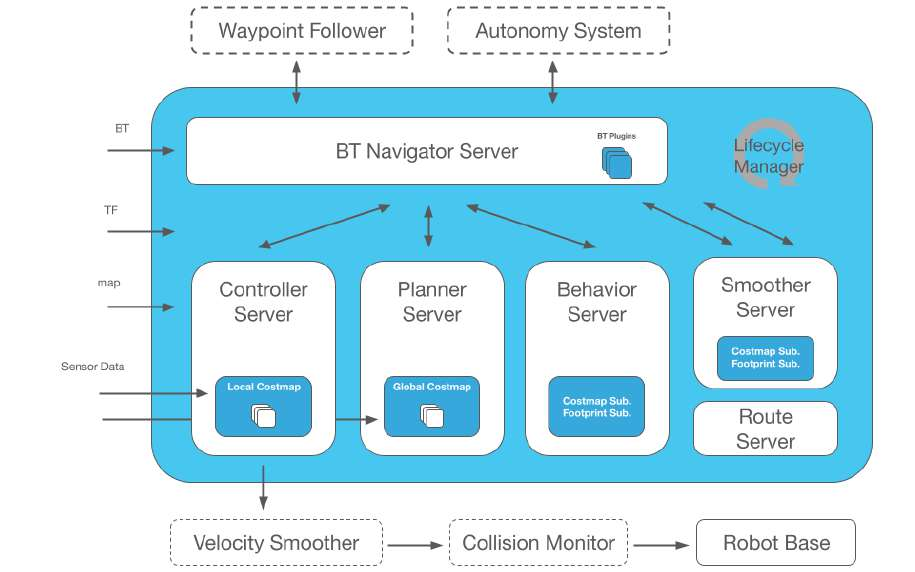
[picture p30: figure]

Rysunek 6.11. Schemat działania systemu NAV 2 [42]

W skład systemu nawigacji NAV2 wchodz ą następuj ące narzędzia:
- Globalna mapa kosztu - system NAV 2 wykorzystuje dwuwymiarow ą mapę otoczenia.

Skonfigurowana mapa składa się z trzech warstw:

— static layer - aktualizowana na podstawie mapy publikowanej przez Cartographer. — obstacle layer - aktualizowana an podstawie przeszkód wykrywanych przez chmurę punktów, rzutowana do dwóch wymiarów
— inflation layer - warstwa powiększaj ąca przeszkody by unikn ąć kolizji

W mapie skonfigurowano m.in. ślad robota - jako prostok ąt opisuj ący platformę mobiln ą bez względu na wychylenie skrętu. Dostosowano równiez parametry odpo- ˙ wiedzialne za ograniczenie dystansu i wielkości przeszkód - przeszkody nizsze ni ˙ z˙ 10cm traktowane s ą jako przejezdne. Przykładow ą zarejestrowan ą mapę globaln ą przedstawiono na rys. 6.12
- Lokalna mapa kosztu - analogiczna do globalnej, jednak reprezentuj ąca jedynie

obszar dookoła robota. Składa się z dwóch warstw:

— voxel layer - trójwymiarowa, aktualizowana an podstawie przeszkód wykrywanych przez skaner. Reprezentuje zajęto´sć wycinków widocznej przestrzeni w kształcie sześcianów.
— inflation layer - analogiczna do warstwy inflacji w mapie globalnej.

Parametry mapy zostały skonfigurowane, podobnie do mapy globalnej. Przykładow ą zarejestrowan ą mapę lokaln ą przedstawiono na rys. 6.13
- Planer - odpowiedzialny za planowanie globalnej ściezki robota. Wykorzystuje infor- ˙

6. Realizacja projektu

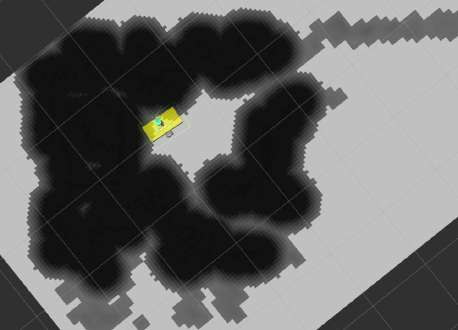
[picture p31: figure]

Rysunek 6.12. Mapa globalna. System urucho-

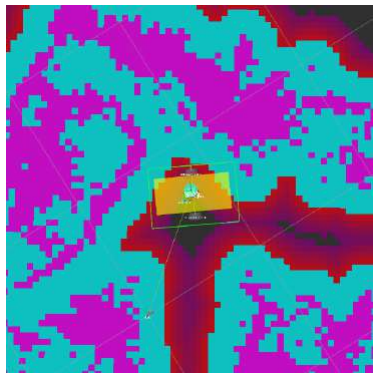
[picture p32: figure]

miony w przykładowym pomieszczeniu. | Rysunek 6.13. Mapa loklana. System urucho- miony w przykładowym pomieszczeniu.

macje z mapy globalnej. Zastosowany został niestandardowy planer SmacPlanner-Lattice [42]. Jest on znacznie lepiej przystosowany do sposobu lokomocji robota niz˙ domyślny planer NavFn [42]. Wybrany planer dostosowuje trasę do kształtu robota -jest to istotne ze względu na podłuzny kształt platformy mobilnej. Dostosowane zo- ˙ stały równiez wagi odpowiadaj ące karom za wykonywanie ostrych zakrętów - dzięki ˙ temu generowana jest ściezka o łagodnych zakrętach, odpowiednich dla układu ˙ kinematycznego robota - wówczas moze być wykorzystany centralny przegub, co za- ˙
pewnia większ ą precyzję wykonania ściezki. Ograniczone do minimum jest równie ˙ | z˙
planowanie zakrętów w punkcie - odpowiednich dla zwykłych robotów róznicowych, ˙ ale obci ązaj ących zastosowan ą platformę mobiln ą. ˙
- Kontroler - odpowiedzialny za wyznaczenie ściezki w skali lokalnej (planer loklany) i ˙

bezpośrednie wyznaczenie prędkości robota. Wykorzystuje wtyczkę DWBLocalPlanner [42]. Dostrojony został szereg parametrów planera, aby zapewnić jego kompatybilno´sć z platform ą mobiln ą. Między innymi dostosowano maksymaln ą prędko´sć do mozliwości robota oraz ograniczono maksymalne przyspieszenia by zwiększyć ˙ płynno´sć ruchu.
- Węzeł wygładzaj ący prędko´sć (ang. velocity smoother) - odpowiedzialny za ograni-

czenie nagłych zmian prędkości, które mogłyby spowodować nagłe ruchy robota. Dostosowano do momentu uzyskania płynnych zmian prędkości.
- Drzewo zachowań (ang. Behaviour tree) - umozliwia sterowanie funkcjami robota na ˙
najwyzszym poziomie abstrakcji, między innymi poprzez zadawanie celów i ście ˙ | zek, ˙
a takze bardziej skomplikowanych zadań robotycznych. W niniejszym projekcie jest ˙
stosowane w ograniczonym zakresie, logika drzewa zachowań moze być jednak ˙ | ze˙
wykorzystana do rozbudowy i wykorzystania praktycznego całego systemu. Drzewo zachowań zostało wykorzystane jedynie do wyznaczania celu, a takze obsługi zacho- ˙ wać awaryjnych (rescue).

6. Realizacja projektu

Ponadto wykorzystano węzeł nav2 costmap 2d markers, publikuj ący markery w przestrzeni oznaczaj ące przeszkody, oznaczone względem mapy lokalnej. Markery wykorzystywane s ą jedynie do wizualizacji.

## 7. Wyniki i działanie

Testy pojedynczych modułów przeprowadzany były na biez ąco, w trakcie realizacji i po ˙ ich ukończeniu. Testy całości systemu przeprowadzono po ukończeniu pierwotnej fazy realizacji. Testy spowodowały pewne zmiany w podmodułach, które zostały uwzględnione w opisach ich realizacji.

### 7.1. Działanie skanera

Przetestowane została zarówno jako´sć skanów, jak i działanie mechanizmu skanera i samego czujnika.
Uzyskano skaner o pełnej rozdzielczości poziomej 1600 punktów na obrót, co odpowiada zmianie k ąta o 0,225 stopnia pomiędzy pomiarami. Poniewaz do ruchu w pionie ˙ wykorzystany jest serwomechanizm przyjmuj ący impulsy PWM, rozdzielczo´sć pionowa jest zalezna od luzów w przekładni oraz minimalnej długości impulsu. Przetestowana ˙ została warto´sć rozdzielczości pionowej 91 punktów i kroku 1 stopnia. Wówczas kazda ˙ zmiana o 1 stopień wywołuje widoczne przemieszczenie czujnika, mozliwe jest jednak ˙ dalsze zwiększanie rozdzielczości.
Uzyteczna rozdzielczo´sć jest jednak powi ązana z szybkości ą skanowania. Ze względu ˙ na szybko´sć czujnika, dla rozdzielczości 1600x91 czas trwania pojedynczego skanu wynosi około 2 minut. Aby czujnik był praktyczniejszy, mozna zredukować rozdzielczo´sć. Wówczas ˙ potencjalna rozdzielczo´sć praktyczna, uwzględniaj ąca ograniczony k ąt widzenia w pionie, wynosi 200 punktów w poziomie na 6 punktów w pionie przy częstotliwości 1.0 Hz, co odpowiada k ątowi 1.8 stopnia na 6 stopni. Rozdzielczo´sć pozioma jest większa, poniewaz˙ przy omijaniu naturalnych przeszkód, jak np. drzewa jest ona istotniejsza. Przeszkody szerokie i niskie nie s ą tak powszechne.
Zakres skanowanych nachyleń określono w tym przypadku na od 70 stopni do 100 stopni. K ąt 70 stopni jest wystarczaj ący, poniewaz mniejsze wartości powoduj ą skanowa- ˙ nie podłoza blisko robota. (dla 70 stopni, odległo´sć 137 cm w poziomie). Niesie to mało ˙ informacji o otoczeniu kosztem czasu pracy skanera. Podobnie zbędne jest skanowanie wysokich obiektów, które nie s ą przeszkodami dla robota. Skierowanie skanera ku górze
pod duzym nachyleniem przy większych odległościach powoduje, ˙ | ze skanowane s ą punkty ˙
znajduj ące się bardzo wysoko. Np. przy odległości w poziomie 15m i nachyleniu 110 stopni, skanowane będ ą punkty na wysokości 5,5m.
Stabilno´sć skanera mozna uznać za zadowalaj ąc ą. Wibracje podczas pracy z pełn ą ˙ prędkości ą s ą niewielkie (zmierzona amplituda drgań na szczycie wiezy wyniosła 0.6 ˙ mm). Sprawdzono równiez poprawno´sć działania skanera podczas występowania wibracji ˙ zewnętrznych (np. spowodowanych przez poruszanie się łazika po przeszkodach). Nie doprowadziły one do destabilizacji skanera. Podczas rzeczywistej jazdy wibracje s ą ograniczone ze względu na nisk ą prędko´sć robota.
Testy w róznych warunkach oświetleniowych i na szerokim zakresie odległości pozwa- ˙

7. Wyniki i działanie

laj ą ocenić, jak urz ądzenie moze sprawować się w rzeczywistych warunkach. Badania ˙ zostały przeprowadzone bezpośrednio na samym sensorze, poniewaz oświetlenie nie ma ˙ wpływu na pozostałe elementy skanera.
Wyniki testów wykazały, ze czas wykonywania skanu wydłu ˙ | za się wraz ze wzrostem ˙
odległości. Gdy skaner nie napotyka przeszkody (np. gdy jest skierowany w pustkę), czas
pomiaru wydłuza się jeszcze bardziej, poniewa ˙ | z oprogramowanie układowe powtarza ˙
pomiary. Pewne nieregularności w czasie wykonywania skanu s ą akceptowalne, dzięki asynchronicznej naturze sterowania silnikiem krokowym. Czas pomiaru został ustabilizowany poprzez:
- Ograniczenie czasu maksymalnego przez zmniejszenie maksymalnej liczby powtó-

rzeń przez autora w konfiguracji czujnika.
- Wydłuzenie czasu minimalnego (gdy przeszkoda jest bliska i dobrze widoczna) przez ˙

wprowadzenie minimalnego czasu oczekiwania na pomiar w programie.
- Zapewnienie dodatkowych opóźnie ń stabilizuj ących czasy wykonywania pozostałych

operacji

Dodatkowo, dokonano weryfikacji częstotliwości odczytu poprzez analizę widma amplitudowego dźwięku generowanego przez silnik krokowy. Największa amplituda rejestrowana była dla wartości odpowiadaj ącej częstotliwości pomiarów (i jej wielokrotności). Stabilno´sć tej częstotliwości oceniano natomiast na podstawie szerokości pasa odpowiadaj ącego wysokim amplitudom. Szerszy pas sygnalizował mniejsz ą stabilno´sć częstotliwości. Zaobserwowano pewne zakłócenia przy skanowaniu błyszcz ących powierzchni, które odbijaj ą wi ązkę skanuj ąc ą, oraz jasnych obiektów. Typowe błyszcz ące powierzchnie nie występuj ą w środowiskach docelowych. Najpowszechniejsze błyszcz ące naturalne obiekty, zbiorniki wodne, s ą ignorowane w załozeniach projektu. Przykładem bardzo jasnego ˙ obiektu jest słońce. Skierowanie czujnika w słońce lub powierzchnię odbijaj ąc ą jego światło, powoduje pojedyncze błędne odczyty - mog ą one być później odfiltrowane.
Następnie przeprowadzone zostały testy wyników skanowania. Ponizej zostały przed- ˙
stawione wyniki skanowania dla róznych rozdzielczości (Rys ˙ | 7.1 - pełny zakres nachyleń,
7.2 - 7.5 - ograniczony zakres), zwizualizowane za pomoc ą programu RVIZ2 zintegrowanego w systemie ROS2.
Wyniki odpowiadaj ą topologii otoczenia. Skany w pełnej rozdzielczości zapewniaj ą najwięcej szczegółów, jednakze s ą zbyt wolne, niezbędne jest więc ograniczenie rozdzielczości. ˙ Przy wybranej rozdzielczości 200 x 6 uzyskana częstotliwo´sć 1 Hz odpowiada przejechaniu pomiędzy skanami przez robota, poruszaj ąc się z maksymaln ą prędkości ą, odległości 23 cm. O ile więc częstotliwo´sć skanów jest wolna w stosunku do rozwi ązań dostępnych na rynku, bior ąc pod uwagę prędko´sć robota powinna być wystarczaj ąca. W przeciwnym wypadku,
mozliwe jest dalsze ograniczenie prędkości robota lub zmniejszenie rozdzielczości. Je ˙ | zeli ˙
chodzi o rozdzielczo´sć skanów, powinna być ona wystarczaj ąca. W artykule "Autonomous Person Following with 3D LIDAR in Outdoor Environments"[19] wykorzystano skaner o zblizonej rozdzielczości 59 x 29. ˙

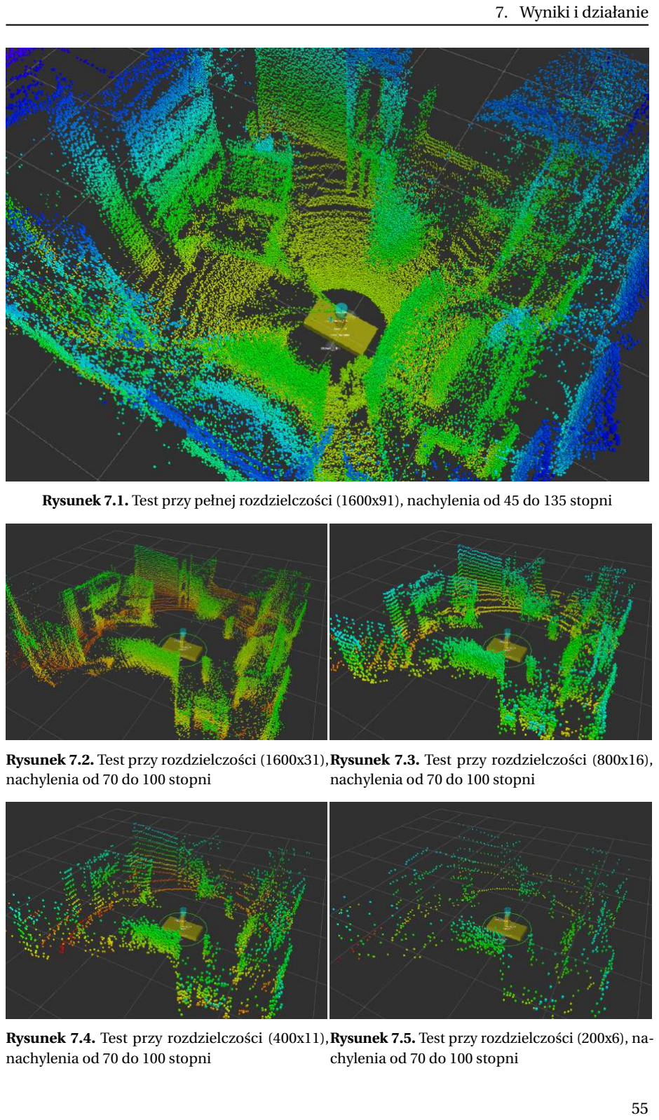
[picture p33: page 55]

7. Wyniki i działanie

Rysunek 7.1. Test przy pełnej rozdzielczości (1600x91), nachylenia od 45 do 135 stopni

Rysunek 7.2. Test przy rozdzielczości (1600x31), nachylenia od 70 do 100 stopni

Rysunek 7.3. Test przy rozdzielczości (800x16), nachylenia od 70 do 100 stopni

Rysunek 7.4. Test przy rozdzielczości (400x11), nachylenia od 70 do 100 stopni

Rysunek 7.5. Test przy rozdzielczości (200x6), nachylenia od 70 do 100 stopni

7. Wyniki i działanie

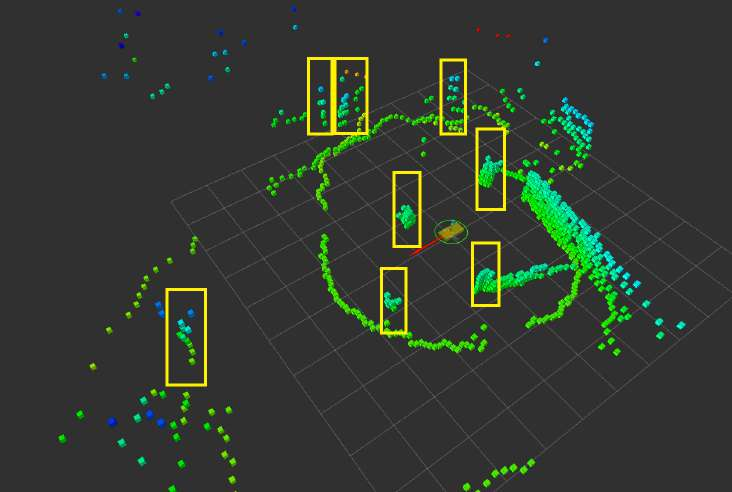
[picture p34: figure]

Rysunek 7.6. Test terenowy skanera; oznaczone drzewa

Zaobserwowano pewne odchylenia przy skanowaniu płaskich powierzchni - punkty w wizualizacji układaj ą się w płaszczyznę, ale widoczne s ą niedokładności, zalezne od ˙ m.in. koloru powierzchni i k ąta nachylenia wi ązki względem powierzchni. Niedokładności bezwzględne oszacowano na podstawie wyników na ponizej ˙ ± 5 cm.
Ponadto przetestowano działanie skanera w terenie (rys. 7.6). Rozdzielczo´sć pionowa była wystarczaj ąca do wykrycia wszelkich przeszkód. Rozdzielczo´sć pozioma wystarczała do jednoznacznego zarejestrowania przeszkód w postaci drzew do odległości około 6m (oznaczone punkty odpowiadaj ące pionowym przeszkodom). Duze odległości, nie wystę- ˙ puj ące we wcześniejszych testach, nie zaburzyły procesu skanowania.
Ostatecznym testem było porównanie działanie skanera do zewnętrznego, referencyjnego urz ądzenia. Wybrano kamerę głębi StereoLabs ZED 2 [11]. Kamera została umieszczona w osi skanera, na statywie, bez względnej rotacji. Oba urz ądzenia podł ączono do tej samej wizualizacji. Względne przesunięcie układów zostało uwzględnione. Konfigurację testow ą przedstawiono na rys. 7.7. Wyniki skanu (rys. 7.8 - 7.12)zostały porównane do kamery w dwóch konfiguracjach: pełnej rozdzielczości 1600x91 oraz wykorzystywanej rozdzielczości 200x6. Chmura punktów ze skanera wyświetlona została w skali kolorów w osi z. Wyniki z kamery głębi s ą reprezentowane kolorami obserwowanymi przez kamerę.
Podstawow ą róznic ą między sensorami s ą rozdzielczo´sć (znacznie wy ˙ | | zsza w kamerze) i ˙
k ąt widzenia (dookólny dla skanera). Istotniejsza w powyzszym teście jest jednak dokład- ˙ no´sć pomiaru. We wszystkich testowanych widokach punkty rejestrowane pokrywaj ą się z wynikami chmury punktów bez widocznych odchyleń.
Największa róznica mo ˙ | ze być zaobserwowana w teście ˙ | 7.10 - podłoga powinna być
pozioma, jednakze przez kamerę rejestrowana jest pod nachyleniem - jest to rezultat małej ˙

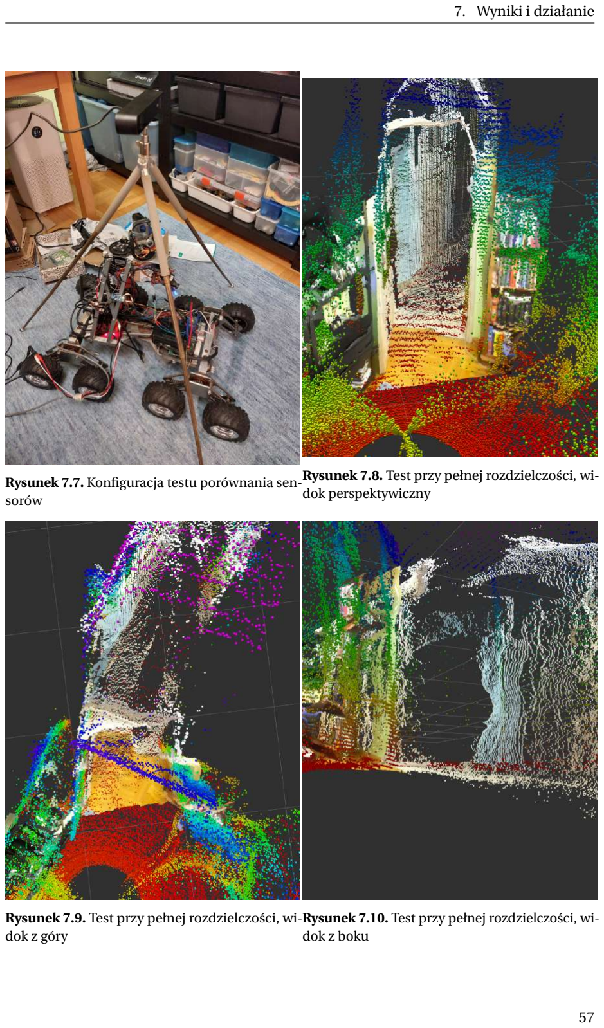
[picture p35: page 57]

7. Wyniki i działanie

Rysunek 7.7. Konfiguracja testu porównania sensorów

Rysunek 7.8. Test przy pełnej rozdzielczości, widok perspektywiczny

Rysunek 7.9. Test przy pełnej rozdzielczości, widok z góry

Rysunek 7.10. Test przy pełnej rozdzielczości, widok z boku

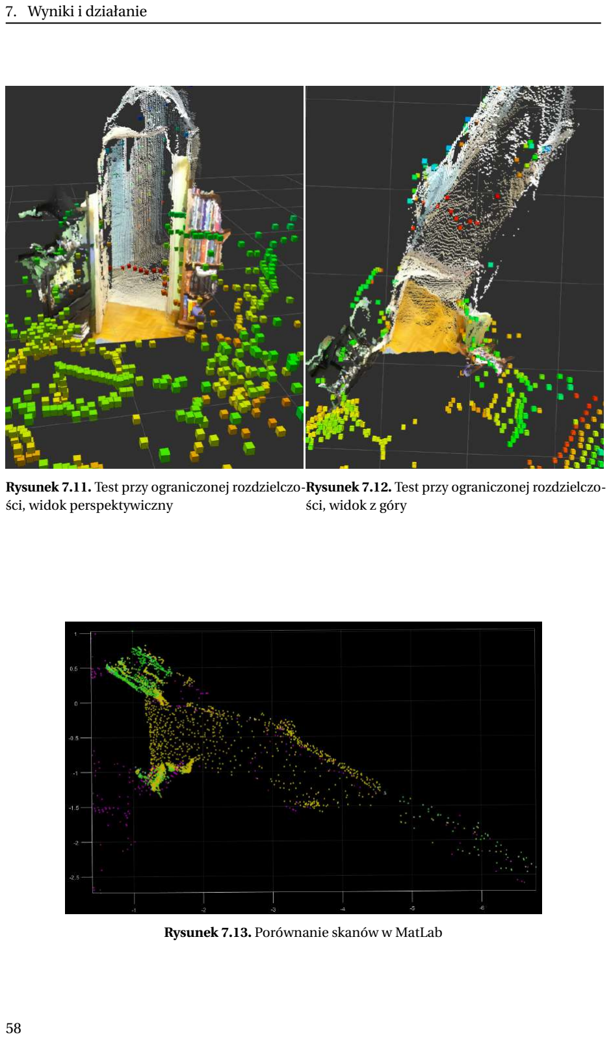
[picture p36: page 58]

7. Wyniki i działanie

Rysunek 7.11. Test przy ograniczonej rozdzielczo-ści, widok perspektywiczny

Rysunek 7.12. Test przy ograniczonej rozdzielczo-ści, widok z góry

Rysunek 7.13. Porównanie skanów w MatLab

7. Wyniki i działanie

ilości detali widocznych dla kamery, zaburzaj ący działanie algorytmów kamery. LiDAR działa tu poprawnie.
Aby potwierdzić jako´sć skanera numerycznie, dopasowano chmury wygenerowane przez skaner i kamerę głębi w programie MatLab za pomoc ą algorytmu Iterative Closest Point (pcregistericp [43]). Algorytm podczas dopasowania zwrócił warto´sć błędu średniokwadratowego dopasowania - odpowiadaj ąc ą jakości dopasowania, co jest powi ązane z podobieństwem skanów z obu urz ądzeń. Warto zaznaczyć, ze warto´sć błędu wzrasta ˙ bez względu na to które z urz ądzeń myli się z rzeczywistości ą. Uzyskano warto´sć błędu RMSE = 0.25m.
Podsumowuj ąc, dokładno´sć skanera jest satysfakcjonuj ąca i nie odbiega od standardów rozwi ązań komercyjnych. W zalezności od charakterystyki obserwowanych powierzchni, ˙
mozliwe jest osi ągnięcie jeszcze wy ˙ | zszej dokładności. Warto zauwa ˙ | zyć, ˙ | ze zarówno roz- ˙
dzielczo´sć, jak i częstotliwo´sć odczytów s ą znacznie nizsze w porównaniu do kamery ZED2 ˙ (rozdzielczo´sć 2208x1242 przy częstotliwości 15 Hz). Róznica ta wynika z fundamentalnie ˙ innej zasady działania sensora skanera, gdzie sensor odpowiada pojedynczemu pikselowi kamery.
Ze względu na nisk ą prędko´sć platformy mobilnej (maksymalna prędko´sć 0.23 m/s), nizsza częstotliwo´sć skanera nie stanowi ograniczenia dla całego systemu. Dodatkowo, ˙ umozliwia to przeprowadzanie obliczeń przy ograniczonej mocy obliczeniowej. W algoryt- ˙ mie SLAM przy sensorach wysokiej rozdzielczości przeprowadzany jest subsampling, więc wszystkie informacje nie byłyby wykorzystane.
Co więcej, skaner wykazuje się większ ą dokładności ą przy obserwacji obiektów ruchomych i oświetlanych zmiennie, takich jak roślinno´sć czy śnieg. To sprawia, ze jest on ˙ bardziej efektywny w naturalnych środowiskach. LiDAR nie wymaga równiez oświetlenia ˙ do działania - wykorzystuje jedynie emitowan ą przez skaner wi ązkę. Poprawno´sć i dokładno´sć wskazań kamery s ą natomiast bezpośrednio powi ązane z kierunkiem i jasności ą oświetlenia. W ciemności kamera nie funkcjonuje.

### 7.2. Wydajno´sć platformy mobilnej

Zostały przeprowadzone testy działania pojedynczych czujników, oraz oceniono mozli- ˙ wości platformy mobilnej.
Przy domyślnej konfiguracji, uzyskano częstotliwo´sć odczytu 100 Hz z czujnika IMU. Warto´sć ta jest w pełni wystarczaj ąca dla funkcjonowania systemu. Po kalibracji, zwracane wartości s ą zgodne z oczekiwaniami - bliskie zera wartości prędkości k ątowej gdy czujnik jest statyczny, przyspieszenia zgodne z ziemskim. Wskazania kierunku północnego zostały porównane z innym kompasem cyfrowym i nie rózniły się znacz ąco. ˙
Największ ą wad ą wykorzystanego odbiornika GNSS jest czas uzyskania ustalonej pozycji po wł ączeniu, wynosz ący około 30s. Ponadto nie mozliwe jest uzyskanie pozycji we ˙ wnętrzach, nie jest to jednak problem przy terenowym zastosowaniu robota. W nominalnych warunkach odbiornik działa poprawnie. Częstotliwo´sć odczytu wynosi 4 Hz, co

7. Wyniki i działanie

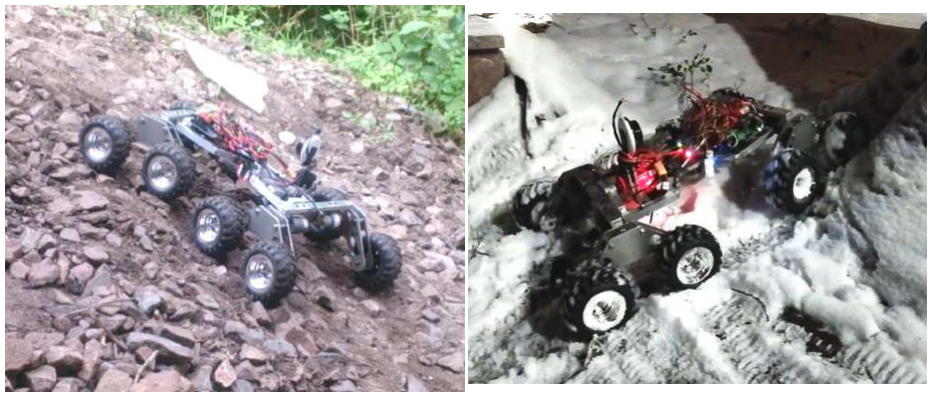
[picture p37: figure]

Rysunek 7.14. Test nachylenia | Rysunek 7.15. Test na śniegu

jest w pełni wystarczaj ące bior ąc pod uwagę dokładno´sć systemu GNSS. Przy dobrych warunkach odchylenie standardowe pozycji, odczytywane przez moduł GPS, wynosi 1-2m w otwartym terenie.
Opracowane sterowniki umozliwiaj ą stabiln ą komunikację z warstw ą niskopoziomow ą, ˙ oraz dostarczaj ą standaryzowane interfejsy wewn ątrz systemu ROS, pozwalaj ące na rozbudowę warstwy wysokopoziomowej.
Mozliwości terenowe samej platformy zostały ocenione poprzez serię testów przepro- ˙ wadzonych w róznych warunkach terenowych. Przetestowano nachylenia terenu do 45 ˙

◦
,
rózne nawierzchnie, takie jak ziemia, ˙ | zwir i śnieg, oraz przeszkody o wysokości równej ˙
średnicy koła (do 10 cm). Platformę w warunkach testowych przedstawiono na rys. 7.14,
7.15. Mechanicznie platforma z powodzeniem sprostała tym wyzwaniom. Ze względu na wysoki moment obrotowy napędów, prędko´sć kół przy tej samej zadanej wartości nie odbiegała w sposób znacz ący od prędkości podczas jazdy po płaskim terenie.
Brak enkoderów jest pewnym ograniczeniem platformy. Warto´sć danych z enkoderów podczas jazdy po nieregularnym terenie byłaby jednak niewielka - często występuj ą poślizgi
kół oraz dystans przejechany po przeszkodach jest zauwazalnie większy ni ˙ | z odpowiadaj ący ˙
mu dystans przebyty w poziomie. Konieczne natomiast będzie wyznaczenie współczynnika określaj ącego zalezno´sć prędkości rzeczywistej od zadanej. ˙

### 7.3. Testy odometrii

Precyzję wyznaczania samej orientacji przetestowano przemieszczaj ąc rzeczywistego robota i obserwuj ąc wizualizację orientacji wyznaczonej przez filtr komplementarny. Pro-
ces ten umozliwił ocenę zdolności filtru do skutecznego śledzenia zmian poło ˙ | zenia i ˙
orientacji robota w czasie rzeczywistym. Nie zaobserwowano dryfu orientacji w spoczynku, i po przeprowadzeniu testów (Rys. 7.16). Nie zaobserwowano opóźnień w odwzorowaniu pozycji. Zaaranzowana w rzeczywistości orientacja odpowiadała wizualizowanej. ˙

7. Wyniki i działanie

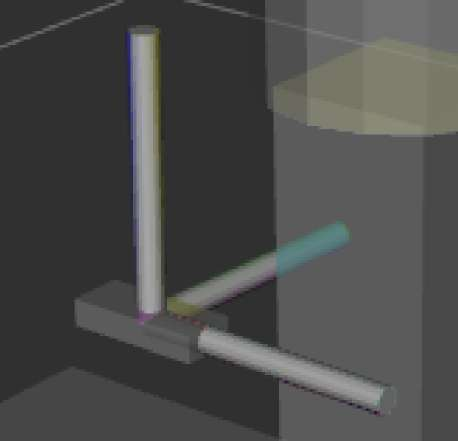
[picture p38: figure]

Rysunek 7.16. (niebieski, zielony, czerwony) - orientacja przed testem; (zółty, magenta, cyjan) - ˙ orientacja po teście; biały - pokrycie

Gdy uruchomiony był jednocześnie skaner LiDAR, rejestrowane były oscylacje robota, zgodne z rzeczywistymi. Dowodzi to dobremu odwzorowaniu orientacji przy zmianach o wysokiej częstotliwości.
W przypadku odometrii nalezy przetestować dokładno´sć odwzorowania lokalizacji ˙ robota przy rzeczywistym ruchu. W ramach testu zostały zadane kolejno prędkości, jako wiadomości na temacie /cmd_vel. Porównano zmianę współrzędnych, zmierzon ą w rzeczywistości, ze zmian ą współrzędnych w wizualizacji. Układ odom ustawiono jako statyczny, aby wykluczyć wpływ lokalizacji globalnej. Do referencyjnego pomiaru wykorzystano obraz z kamery głębi zed 2. Oba widoki wyświetlano w widoku rzutu ortogonalnego, ze statyczn ą kamer ą. Wynik testu przedstawiono na rys. 7.17 - 7.20. Zółt ą ramk ą oznaczono robota na ˙

kamerze. Czerwone strzałki oznaczaj ą trajektorię robota w wizualizacji.
Zmiana połozenia zmierzona w rzeczywistości wyniosła 150cm w poziomie i 290cm w ˙ pionie (w układzie widoku). W odometrii przebyta odległo´sć wyniosła 115cm w poziomie i 236cm w pionie. Oznacza to bł ąd względny odometrii na poziomie 24%. Przejechana
odległo´sć była większa niz zmierzona. Bł ąd orientacji nie wyst ąpił (znalazł się poni ˙ | zej ˙
dokładności pomiarowej). Przy jeździe terenowej mog ą nast ąpić dodatkowe poślizgi -wówczas moze wyst ąpić odwrotna niedokładno´sć - przejechana odległo´sć będzie mniejsza ˙
niz zmierzona. Eksperyment wykazał, ˙ | ze precyzja jest ograniczona, ze względu na brak ˙
enkoderów i występowanie poślizgu kół przy skręcaniu. Uzyskana dokładno´sć jest jednak
akceptowalna, gdyz lokalizacja w systemie jest korygowana na bie ˙ | z ąco przez algorytm ˙
SLAM.

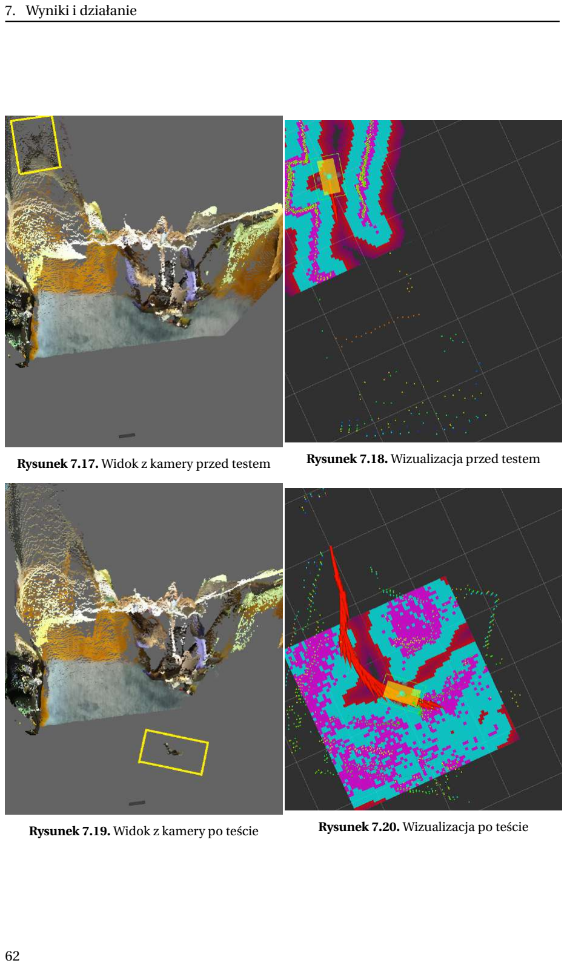
[picture p39: page 62]

7. Wyniki i działanie
Rysunek 7.17. Widok z kamery przed testem | Rysunek 7.18. Wizualizacja przed testem
Rysunek 7.19. Widok z kamery po teście | Rysunek 7.20. Wizualizacja po teście

7. Wyniki i działanie

### 7.4. Testy SLAM

Weryfikacja działania algorytmu SLAM została przeprowadzona z wci ąz wł ączon ą odo- ˙
metri ą, poniewaz SLAM został skonfigurowany z zało ˙ | zeniem ograniczonej rotacji pomiędzy ˙
skanami - orientacja jest określana precyzyjnie przez lokalizację lokaln ą. Wykorzystanie samego SLAM skutkowałoby więc licznymi błędami. Przeprowadzono przejazd robotem przy zewnętrznym sterowaniu prędkości ą. Ponownie zastosowano procedurę porównawcz ą z kamer ą głębi. Do testu wył ączono odbiornik GNSS, poniewaz został przeprowadzony w ˙ pomieszczeniu. Wynik testu przedstawiono na rys. 7.21 - 7.23. Na rys. 7.22 przedstawiono mapę nałozon ą na rzut środowiska. Kolory mapy zostały dostosowane w celu poprawy ˙ czytelności.
W wyniku przeprowadzonego testu uzyskano mapę, która zadowalaj ąco odzwierciedlała rzeczywisto´sć. W trakcie tego testu nie stwierdzono błędów polegaj ących na wykrywaniu nieistniej ących przeszkód lub ignorowaniu istniej ących przeszkód. W ramach moz-˙ liwości porównania mapy do widoku z kamery głębi, odwzorowanie okazało się precyzyjne
- elementy środowiska znajduj ące się zarówno na mapie jak i widoczne w porównawczej kamerze pokrywaj ą się. Widoczne s ą natomiast pewne błędy w obrazie generowanym przez kamerę - ściana w prawej części mapy nie została zarejestrowana poprawnie i ma kształt łuku.

### 7.5. Testy planowania

Test planowania przeprowadzono wyznaczaj ąc w zmapowanym środowisku cel dla robota, następnie obserwuj ąc wygenerowan ą trajektorię (rys. 7.24).
Uzyskana trajektoria omija przeszkody - dzięki zastosowaniu inflacji mapy, trajektoria jest odsuwana na bezpieczny dystans od przeszkód, gdy jest to mozliwe. Ponadto trajektoria ˙ jest wygładzona i nie zawiera ostrych zakrętów lub zakrętów w punkcie, co zwiększa precyzję pokonania jej przez robota.
Przeprowadzenie wydzielonych testów kontrolera (planera loklanego) jest problematyczne, gdyz wymaga działaj ącej lokalizacji, planera, i przekazania sterowania kontrolerowi. ˙ Testy te zostały więc przeprowadzone w ramach testu całości systemu.

### 7.6. Testy kompletnego systemu

### 7.6.1. Srodowisko i procedura testowa ´

Testy zostały przeprowadzone w naturalnym środowisku, reprezentuj ącym docelowe miejsce pracy robota. Teren testowy przedstawiono na rys. 7.25 i 7.26. Współrzędne obszaru to 52,583136N; 21,442931E. W środowisku występuj ą następuj ące elementy:
- Nierówny teren o zmiennym nachyleniu
- Trudna nawierzchnia (w czasie testów występowała pokrywa śniezna) ˙
- Sztuczne przeszkody (płot, postawione przeszkody)
- Naturalne przeszkody (zarośla, drzewa)

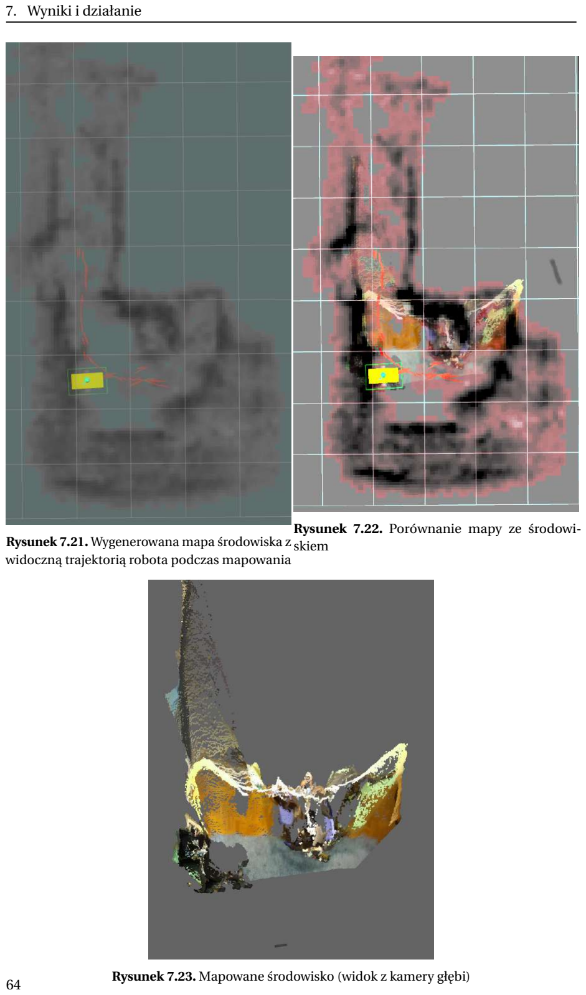
[picture p40: page 64]

7. Wyniki i działanie

Rysunek 7.21. Wygenerowana mapa środowiska z widoczn ą trajektori ą robota podczas mapowania

Rysunek 7.22. Porównanie mapy ze środowiskiem

Rysunek 7.23. Mapowane środowisko (widok z kamery głębi) 64

7. Wyniki i działanie

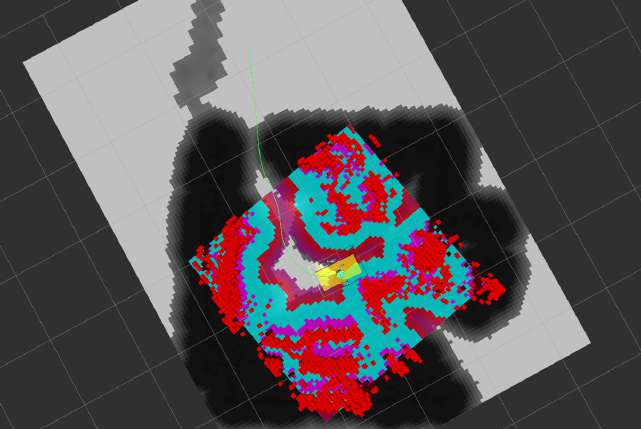
[picture p41: figure]

Rysunek 7.24. Planowana trajektoria (zielona linia)

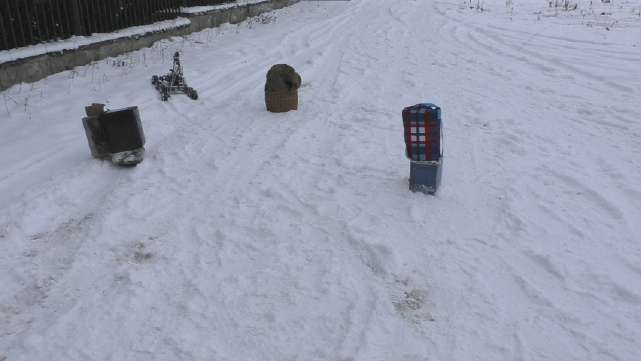
[picture p42: figure]

Rysunek 7.25. Srodowisko testu terenowego ´

- Naturalne oświetlenie dzienne

Powyzsze elementy składaj ą się na odpowiednie środowisko do testów robota terenowego. ˙ Do wykonania zadania niezbędne jest prawidłowe funkcjonowanie wszystkich systemów. Przyjęta została następuj ąca procedura testowa:
- Ustawienie robota na pozycji startowej, przed przeszkodami.
- Wybranie pozycji docelowej, znajduj ącej się za przeszkodami, uniemozliwiaj ącej ˙ pokonanie trasy prost ą ściezk ą. ˙
- Zadanie pozycji docelowej w programie RVIZ za pomoc ą funkcji 2D nav goal.
- Do czasu pokonania trasy przez robota, nie s ą przesyłane zadne komendy. ˙

Przejazd został zarejestrowany zewnętrzn ą kamer ą. Zarejestrowano równiez wizualiza- ˙ cję systemu w RVIZ, w celu porównania na biez ąco stanu systemu z rzeczywistości ą. W ˙ wizualizacji zastosowano następuj ące oznaczenia, zgodnie ze standardem ROS:
- Mapa globalna - skala szarości, proporcjonalna do kosztu

7. Wyniki i działanie

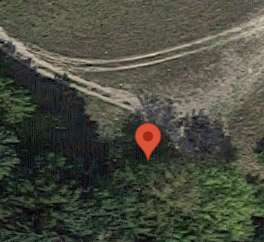
[picture p43: figure]

Rysunek 7.26. Mapa satelitarna terenu testowego

- Mapa lokalna - koszt malej ący w kolejności magenta -> cyjan -> czerwony
- Planowana trajektoria - zielona linia
- Robot - zółty ˙

### 7.6.2. Wyniki

Test przeprowadzono zgodnie z ustalon ą procedur ą na wyznaczonym obszarze testowym. Pełny zarejestrowany przejazd dostępny jest jako materiał wideo [44]. W niniejszej pracy, materiał został przedstawiony w sposób poklatkowy na rys. 7.27.
Test wykazał zdolno´sć robota do autonomicznej nawigacji w nieregularnym terenie, zgodnie z celem pracy. Wszystkie przeszkody zostały ominięte, poprawnie zastosowano planowanie. W trakcie testu wygenerowana została mapa terenu, odzwierciedlaj ąca występuj ące przeszkody. Nie zaobserwowano dryfu lokalizacji robota ani deformacji mapy w trakcie przejazdu. Wyniki były zgodne z oczekiwanymi po przeprowadzeniu cz ąstkowych testów podsystemów.
Przeprowadzono równiez testy systemu w innych środowiskach. ˙
Przejazd przez las (rys. 7.28, 7.29) polegał na pokonaniu terenu bez sztucznych przeszkód, w poblizu drzew. Mimo braku wyraźnych, bliskich przeszkód, robot lokalizował się ˙ poprawnie. Na mapie widoczne s ą pojedyncze wykryte pnie drzew.
Test we wnętrzu (wykonanie trajektorii przedstawionej na rys. 7.24) obejmował przejazd w ąskim przejściem, blisko przeszkód. Jego celem było wyznaczenie minimalnej szerokości przesmyku dla robota. Ustrukturyzowane środowisko wewnętrznego sprzyjało wysokiej dokładności lokalizacji. W takich warunkach wymagana jest jednak wysoka zwrotno´sć od robota. Robot pokonał wyznaczon ą trasę, z najwęzszym przejściem o szerokości 80cm. ˙ Planer lokalny nie wyznaczył ściezki przez przejście o szerokości 70cm, uznaj ąc je za ˙ zablokowane. Szeroko´sć robota z kołami wynosi 41cm, więc pokonanie takiej przeszkody
wymagałoby duzej precyzji i mo ˙ | ze być uznane za ryzykowne. ˙
W ogólności, algorytm SLAM moze napotkać problemy z działaniem, gdy środowi- ˙ sko jest pozbawione szczegółów - na płaskim terenie brak punktów charakterystycznych

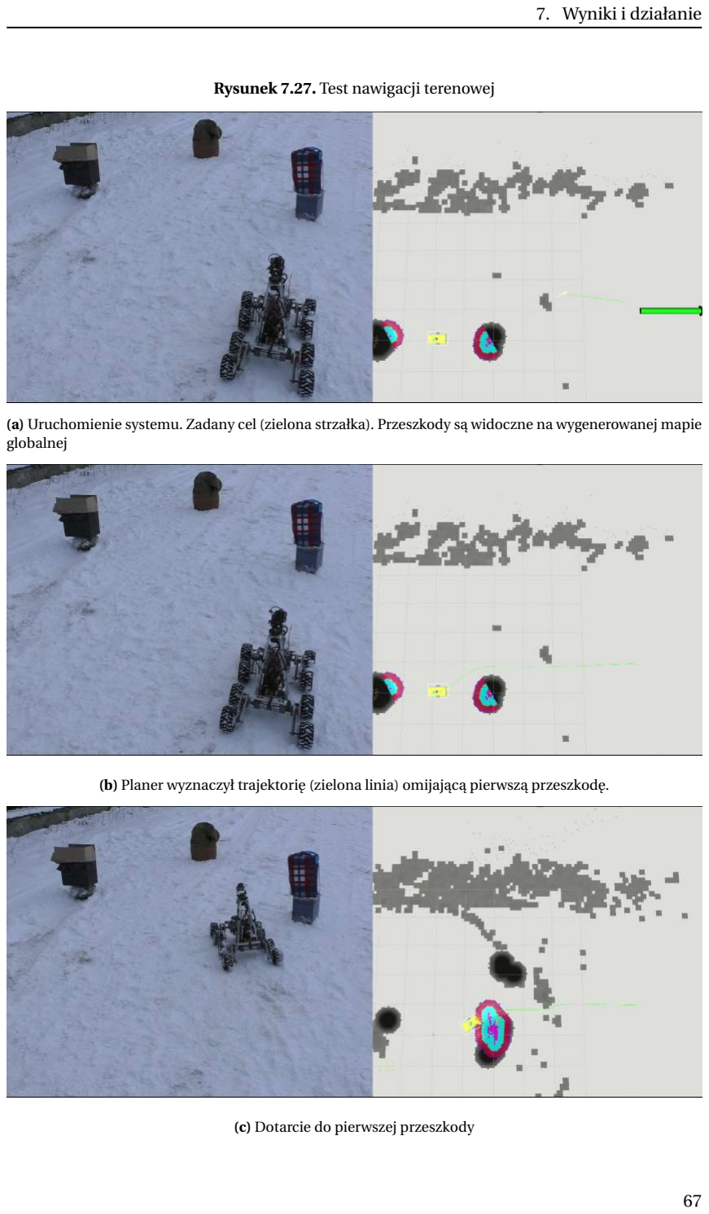
[picture p44: page 67]

7. Wyniki i działanie

Rysunek 7.27. Test nawigacji terenowej

(a) Uruchomienie systemu. Zadany cel (zielona strzałka). Przeszkody s ą widoczne na wygenerowanej mapie globalnej
(b) Planer wyznaczył trajektorię (zielona linia) omijaj ąc ą pierwsz ą przeszkodę.
(c) Dotarcie do pierwszej przeszkody

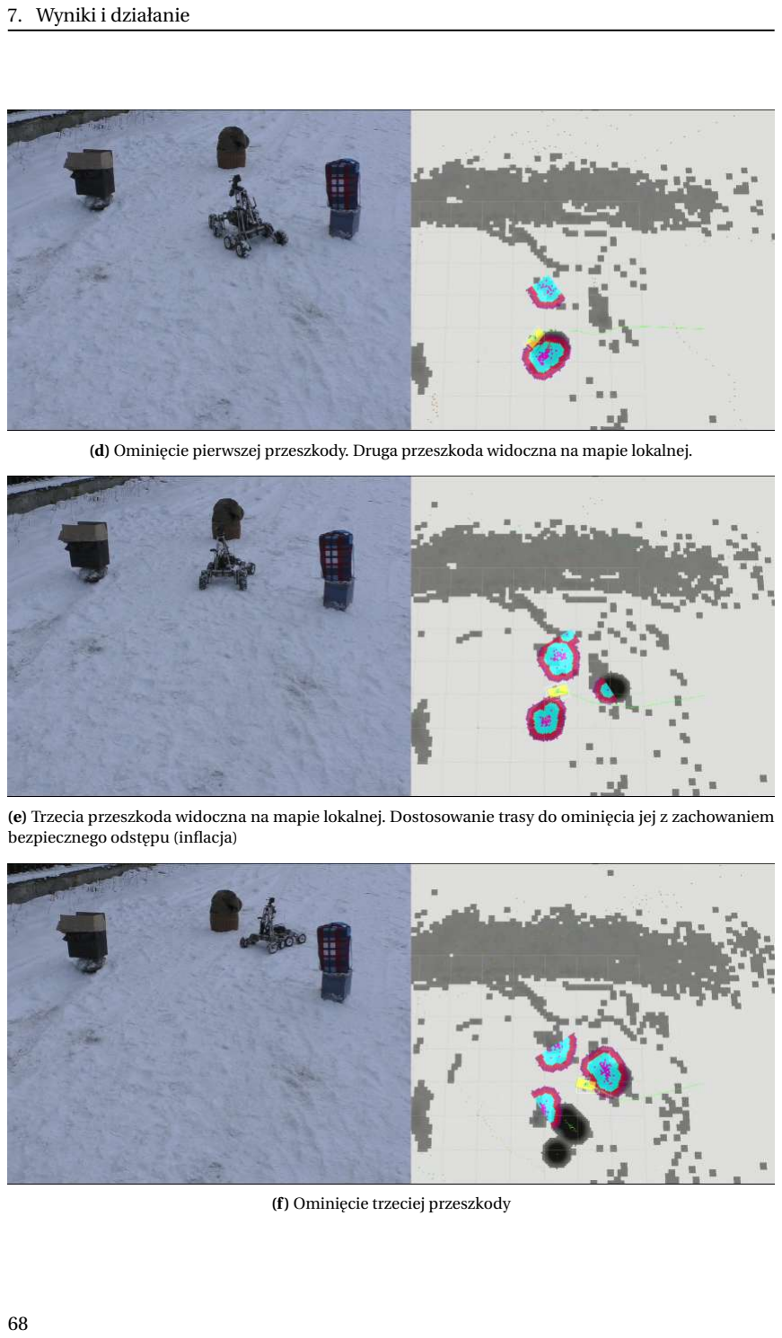
[picture p45: page 68]

7. Wyniki i działanie
(d) Ominięcie pierwszej przeszkody. Druga przeszkoda widoczna na mapie lokalnej.
(e) Trzecia przeszkoda widoczna na mapie lokalnej. Dostosowanie trasy do ominięcia jej z zachowaniem bezpiecznego odstępu (inflacja)

(f ) Ominięcie trzeciej przeszkody

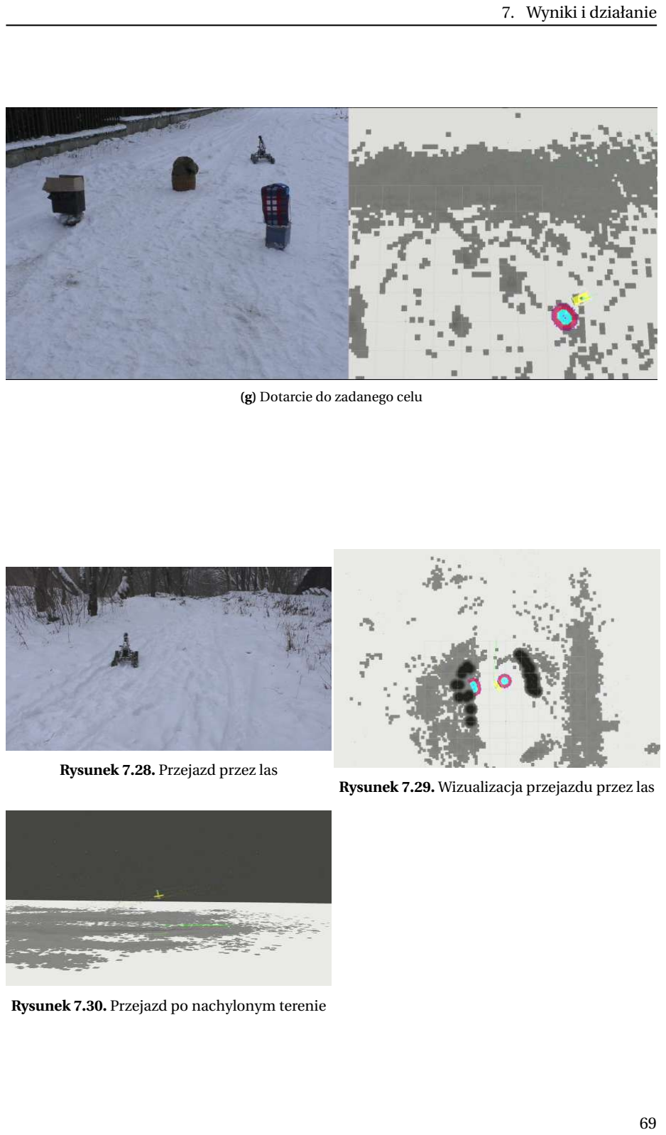
[picture p46: page 69]

7. Wyniki i działanie
(g) Dotarcie do zadanego celu

Rysunek 7.28. Przejazd przez las Rysunek 7.29. Wizualizacja przejazdu przez las

Rysunek 7.30. Przejazd po nachylonym terenie

7. Wyniki i działanie

uniemozliwia poprawne dopasowanie. Wówczas dane o lokalizacji globalnej mog ą być ˙ dostarczone przez moduł GNSS - w efekcie robot moze poruszać się po dowolnym terenie. ˙ Dokładno´sć GNSS jest jednak mniejsza niz algorytmu SLAM. ˙
Teren o zmiennym nachyleniu jest poprawnie rejestrowany przez robota (rys. 7.30). Odometria rejestruje zmianę współrzędnej z gdy robot przemieszcza się, znajduj ąc się pod nachyleniem względem płaszczyzny poziomej. Algorytm SLAM równiez dokonuje korekty ˙ wysokości podczas dopasowywania skanów. W programie RVIZ jest jednak mozliwe zwizu- ˙ alizowanie jedynie rzutu mapy globalnej na płaszczyznę poziom ą. Planowanie globalne równiez odbywa się w dwóch wymiarach. Planowanie lokalne odbywa się natomiast w ˙ płaszczyźnie robota. W efekcie system działa poprawnie przy nachylonym terenie, jednakze˙
nie jest mozliwe zadanie celu o wybranej współrzędnej ˙ | z, co czyni robota niezdolnym do
nawigacji w trójwymiarowych strukturach jak np. jaskinie.

### 7.6.3. Obci ązenie systemu ˙

Zmierzono obci ązenie Raspberry Pi 4 podczas obsługi robota. Uzyskano obci ą ˙ | zenie ˙
wszystkich 4 rdzeni procesora na poziomie 85% oraz zuzycie pamięci ram poni ˙ | zej 500MB. ˙
Wydajno´sć jest więc wystarczaj ąca, jednakze przy dodaniu dodatkowych funkcjonalności ˙ procesor mógłby być zbyt wolny.
Wykorzystana w robocie bateria wystarcza na około 6h pracy w spoczynku, lub 1h jazdy.
Mozliwa jest instalacja 2 baterii w celu wydłu ˙ | zenia czasu pracy. ˙

## 8. Podsumowanie

Podsumowuj ąc, główny cel utworzenia autonomicznego systemu dla robota mobilnego własnej konstrukcji, zdolnego do nawigacji w nieustrukturyzowanych środowiskach został osi ągnięty. Poszczególne etapy projektu zakończyły się sukcesem:
- Uzyskano precyzyjny skaner LiDAR
- Poprawnie zaimplementowano dodatkowe czujniki na platformie mobilnej
- Utworzono sterowniki umozliwiaj ące sterowanie robotem z wykorzystaniem ROS2 ˙
- Robot jest zdolny do wyznaczania lokalizacji lokalnej w sposób ci ągły z zadowalaj ąc ą

precyzj ą
- Robot jest zdolny do wyznaczania lokalizacji globalnej i tworzenia stabilnej mapy
- System umozliwia zaplanowanie trasy omijaj ącej przeszkody do wybranego celu i jej ˙

wykonanie

Działanie systemu zostało przebadane w warunkach naturalnych, reprezentuj ących rzeczywiste środowisko pracy robota.

### 8.1. Problemy

W obecnej implementacji, na systemie ci ąz ą pewne ograniczenia. Rozdzielczo´sć i ˙ częstotliwo´sć skanera s ą stosunkowo niskie. O ile system działa poprawnie, skaner wyzszej ˙ rozdzielczości pozwoliłby na wykrywanie dalszych i mniejszych przeszkód - obecnie mog ą one znaleźć się pomiędzy wi ązkami skanera i zostać wykryte dopiero po zblizeniu się ˙ robota. Wykorzystanie szybszego skanera spowodowałoby osi ągnięcie kolejnego ograniczenia, mocy obliczeniowej Raspberry Pi 4. Wówczas konieczne byłoby zastosowanie szybszego komputera lub wykonywanie części obliczeń (nie wymagaj ącej niskich opóźnień, np planowanie lub SLAM globalny) na zewnętrznej jednostce - takie rozwi ązanie jest wspierane przez ROS2.
Samo planowanie trasy nie jest pozbawione wad - poniewaz robot ignoruje niskie ˙ przeszkody, system nie będzie preferować trasy bez przeszkód nad trasę z małymi przeszkodami. W rzeczywistości, choć obie trasy s ą przejezdne, jedna z nich będzie szybsza,
obci ązy robota mniej i nie niesie ryzyka błędów. Aby jednak system mógł rozró ˙ | zniać ˙
takie sytuacje konieczne byłoby skanowanie podłoza, co z kolei wymagałoby ponownie ˙ zastosowania skanera o bardzo wysokiej rozdzielczości.
Ze względu na sposób powstania projektu i ograniczony czas realizacji, system mog ą występować błędy, np. wynikaj ące z błędnych odczytów sensora, powoduj ące zaburzenie działania systemu. Zlokalizowanie i naprawa takich błędów wymagałyby dalszych testów w róznych warunkach, prac nad projektem i ostatecznie instalacji np. dodatkowych czujni- ˙ ków. Jednym z takich błędów jest utrata pozycji przez silnik krokowy skanera, powoduj ąca błędy w skanach. Jest to sytuacja bardzo rzadka, ale obecnie nie ma sposobu na jej wykrycie. Wymagałoby to zastosowania enkodera i monitorowania pozycji głowicy.
Brak wykorzystania enkoderów w kołach powoduje zmniejszenie precyzji odometrii.

8. Podsumowanie

Zdaniem autora jednak w jeździe terenowej dodanie enkoderów nie doprowadziłoby do znacz ącej poprawy ze względu na występowanie poślizgu, szczególnie, ze testy wykazały ˙ zadowalaj ące działanie odometrii.

### 8.2. Uzyteczno´sć ˙

W obecnym stanie robot moze być praktycznie zastosowany do nawigacji autono- ˙ micznej na krótkich dystansach. Testy długodystansowe nie zostały przeprowadzone. Co oczywiste, system nie dysponuje stabilności ą wystarczaj ąco do zatwierdzenia do komercyjnej eksploatacji, ze względu na wielo´sć zmiennych w skomplikowanym zadaniu jakim jest nawigacja autonomiczna. Jednakze, ze względu na docelowe stosowanie w obszarach nie- ˙ zamieszkanych, oczekiwania wobec stabilności i bezpieczeństwa systemu s ą zdecydowanie mniejsze niz np. w przypadku samochodów autonomicznych. Dzięki temu, zdaniem autora ˙
mozliwe jest doprowadzenie systemu do stanu u ˙ | zyteczności komercyjnej poprzez dalsze ˙
testy i drobne modyfikacje. Wymagane byłoby równiez utworzenie prostego interfejsu ˙
uzytkownika, nie wymagaj ące od u ˙ | zytkownika stosowania systemu ROS. Jest to jednak ˙
zagadnienie niepowi ązane z zakresem pracy.
Z powyzszym zastrze ˙ | zeniem, robot mógłby być w praktyce zastosowany, np. do eks- ˙
ploracji terenów niebezpiecznych - po wyposazeniu w kamery wykrywaj ące ofiary katakli- ˙ zmów lub czujnik radiacji do mapowania terenów skazonych lub zadań inspekcyjnych, ˙ np. monitorowania szczelności infrastruktury gazowej. Wykorzystanie skanera LiDAR w robocie, w przeciwieństwie do powszechnych rozwi ązań bazuj ących na kamerach, otwiera
specyficzn ą mozliwo´sć - robot nie wymaga oświetlenia do funkcjonowania ˙ | zadnego z ˙
systemów. Wobec tego mógłby być wykorzystany do celów zwiadowczych w działaniach wojennych prowadzonych w nocy, bez konieczności stosowania noktowizji. Kolejn ą zalet ą wykorzystania LiDARa jest ogólna niezalezno´sć od warunków oświetleniowych, co czyni ˙ system stabilniejszym w praktyce - raz wypracowany zestaw ustawień powinien działać w kazdych warunkach, w przeciwieństwie do systemów wykorzystuj ących kamery. Zastoso- ˙ wanie robota w przestrzeni kosmicznej stanowi zupełnie inne wyzwanie, ze specyficznymi wymaganiami termicznymi, masowymi i wytrzymałościowymi.

### 8.3. Mozliwości rozwoju ˙

Poza podstawowym, krótkoterminowym planem rozwoju d ąz ącym do zwiększenia ˙ stabilności systemu, system mógłby zostać rozszerzony poprzez:
- Wykorzystanie szybszego skanera, np. rozwi ązania komercyjnego wraz z komputerem

o adekwatnej mocy obliczeniowej.
- Rozszerzenie platformy mobilnej o uniwersalny interfejs umozliwiaj ący instalację ˙ modułów zawieraj ących dodatkowe czujniki lub efektory, zalezne od zastosowania. ˙ Interfejs obejmowałby zarówno system montazu jak i komunikację oraz zasilania. ˙
- Eksperymenty nad wykorzystaniem algorytmów uczenia maszynowego do części

systemu nawigacji autonomicznej, zamiast standardowych rozwi ązań. Potencjalnie

8. Podsumowanie

pozwoliłoby to na poprawę dokładności i dostosowywanie działania systemu do warunków nie branych pod uwagę w obecnej realizacji. Zaleznie od stopnia integracji ˙ wymagane byłoby jednak pozyskanie duzej ilości danych, od której bezpośrednio ˙ zalezałaby jako´sć systemu. Potencjalnie taki system mógłby działać wraz z rozwi ąza- ˙ niem konwencjonalnym, gdzie wyniki systemów byłyby porównywane by unikn ąć nieoczekiwanych błędów wynikaj ących z charakterystyki algorytmów uczenia maszynowego.

## Bibliografia

[1] “Encyklopedia PWN”, Dostęp zdalny (01.01.2024): https://encyklopedia.pwn.pl/haslo/robot;3968150.html. (https://encyklopedia.pwn.pl/haslo/robot;3968150.html)
[2] “NASA Science Mars 2020 mission Perseverance rover”, Dostęp zdalny (01.01.2024): https : / / mars . nasa . gov / mars2020 / spacecraft / rover / communications/, (https://mars.nasa.gov/mars2020/spacecraft/rover/communications/) 2020.
[3] ROS 2 Documentation: Humble, Dostęp zdalny (01.01.2024): https://docs.ros.org/en/humble/index.html, (https://docs.ros.org/en/humble/index.html) 2023.
[4] T. Winiarski, “MeROS: SysML-Based Metamodel for ROS-Based Systems”, IEEE Access,
t. 11, s. 82 802–82 815, 2023.
[5] J. Yang, M. Dong i J. Ye, “A Literature Review of the Rocker-Bogie Suspension for the Planetary Rover”, w International Seminar on Artificial Intelligence, Networking and Information Technology, ResearchGate, 2017.
[6] Igarashi motoren GMBH 2738-125-GC-5, Dostęp zdalny (01.01.2024): https : / / asset.conrad.com/media10/add/160267/c1/- /en/000244475DS01/kartakatalogowa-244475-silnik-elektryczny-szczotkowy-uniwersalny-igarashi-2738-125-gc-5-25-w-6-24-vdc.pdf. (https://asset.conrad.com/media10/add/160267/c1/-/en/000244475DS01/karta-katalogowa-244475-silnik-elektryczny-szczotkowy-uniwersalny-igarashi-2738-125-gc-5-25-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)
[7] Serwo PowerHD LF-20MG standard, Dostęp zdalny (01.01.2024): https://botland.com.pl/serwa- typu- standard/3576- serwo- powerhd- lf- 20mg- standard-6939670200387.html. (https://botland.com.pl/serwa-typu-standard/3576-serwo-powerhd-lf-20mg-standard-6939670200387.html)
[8] F. Villa, F. Severini, F. Madonini i F. Zappa, “SPADs and SiPMs Arrays for Long-Range High-Speed Light Detection and Ranging (LiDAR)”, Sensors, t. 21, nr. 11, s. 3839, 2021.
[9] RPLIDAR A3M1 - Laserowy skaner LIDAR 360 stopni, Dostęp zdalny (01.01.2024): https://kamami.pl/czujniki-odleglosci/573426-rplidar-a3m1-laserowyskaner-lidar-360-stopni.html. (https://kamami.pl/czujniki-odleglosci/573426-rplidar-a3m1-laserowy-skaner-lidar-360-stopni.html)
[10] A. Kadambi, A. Bhandari i R. Raskar, “3D Depth Cameras in Vision: Benefits and Limitations of the Hardware”, w Springer Cham, 2014, s. 3–26.
[11] ZED 2 Camera and SDK Overview, Dostęp zdalny (01.01.2024): https : / / cdn2 (https://cdn2.stereolabs.com/assets/datasheets/zed2-camera-datasheet.pdf) . stereolabs.com/assets/datasheets/zed2-camera-datasheet.pdf, (https://cdn2.stereolabs.com/assets/datasheets/zed2-camera-datasheet.pdf) 2019.
[12] Artec Ray II, Dostęp zdalny (01.01.2024): https://www.artec3d.com/portable-3d-scanners/laser-ray. (https://www.artec3d.com/portable-3d-scanners/laser-ray)
[13] Grove - IMU 9DOF v2.0 - MPU-9250, Dostęp zdalny (01.01.2024): https://www.seeedstudio.com/Grove-IMU-9DOF-v2-0.html, 2020.
[14] GPS Ublox NEO-M8N, Dostęp zdalny (01.01.2024): https://rc-planeta.pl/pl/gps- i- kompasy/1020- gps- ublox- neo- m8n- z- kompasem- do- pixhawk- apm-5297773808819.html. (https://rc-planeta.pl/pl/gps-i-kompasy/1020-gps-ublox-neo-m8n-z-kompasem-do-pixhawk-apm-5297773808819.html)
[15] A. Becker, “Kalman Filter”, Dostęp zdalny (01.01.2024): https://www.kalmanfilter.net/multiSummary.html, (https://www.kalmanfilter.net/multiSummary.html) 2023.
[16] M. Bajracharya, M. W. Maimone i D. Helmick, “Autonomy for Mars Rovers: Past, Present, and Future”, Computer, t. 41, nr. 12, s. 44–50, 2008.

8. Bibliografia
[17] Leo Rover, Dostęp zdalny (01.01.2024): https://www.leorover.tech/the-rover, 2023.
[18] J. Tang, Y. Chen, A. Kukkoa i H. K. et. al., “SLAM-Aided Stem Mapping for Forest Inventory with Small-Footprint Mobile LiDAR”, Forests, t. 6, nr. 12, s. 4588–4606, 2015.
[19] K. Bohlmann, A. Beck-Greinwald, S. Buck i H. Marks, “Autonomous Person Following with 3D LIDAR in Outdoor Environments”, Journal of Automation, Mobile Robotics & Intelligent Systems, t. 7, nr. 2, s. 24–29, 2013.
[20] E. Maulana, M. A. Muslim i A. Zainuri, “Inverse kinematics of a two-wheeled differential drive an autonomous mobile robot”, w Electrical Power, Electronics, Communications, Controls and Informatics Seminar, ResearchGate, 2014.
[21] DC Motors : Performance, Dostęp zdalny (01.01.2024): https://www.johnsonelectric. com / en / resources - for - engineers / dc - motors / dc - motors - performance, (https://www.johnsonelectric.com/en/resources-for-engineers/dc-motors/dc-motors-performance) 2023.
[22] sensor_msgs/msg/PointCloud2 Message, Dostęp zdalny (01.01.2024): https://docs.ros2.org/foxy/api/sensor_msgs/msg/PointCloud2.html, (https://docs.ros2.org/foxy/api/sensor_msgs/msg/PointCloud2.html) 2020.
[23] sensor_msgs/msg/Imu Message, Dostęp zdalny (01.01.2024): https://docs.ros2.org/foxy/api/sensor_msgs/msg/Imu.html, (https://docs.ros2.org/foxy/api/sensor_msgs/msg/Imu.html) 2020.
[24] sensor_msgs/msg/NavSatFix Message, Dostęp zdalny (01.01.2024): https://docs.ros2.org/foxy/api/sensor_msgs/msg/NavSatFix.html, (https://docs.ros2.org/foxy/api/sensor_msgs/msg/NavSatFix.html) 2020.
[25] M. Zawadzki, “Repozytorium - System autonomicznej nawigacji dla terenowego robota mobilnego”, Dostęp zdalny (01.01.2024): https://github.com/MarcelZawadzki/autonomous-rover-thesis/, (https://github.com/MarcelZawadzki/autonomous-rover-thesis/) 2024.
[26] Silnik krokowy JK28HS32-0674, Dostęp zdalny (01.01.2024): https : / / botland (https://botland.com.pl/silniki-krokowe/3604-silnik-krokowy-jk28hs32-0674-200-krokowobr-38v067a006nm-5904422331993.html) . com . pl / silniki - krokowe / 3604 - silnik - krokowy - jk28hs32 - 0674 - 200 -krokowobr-38v067a006nm-5904422331993.html. (https://botland.com.pl/silniki-krokowe/3604-silnik-krokowy-jk28hs32-0674-200-krokowobr-38v067a006nm-5904422331993.html)
[27] Serwo TowerPro SG-90 - micro - 180 stopni, Dostęp zdalny (01.01.2024): https : //botland.com.pl/serwomechanizmy/484- serwo- towerpro- sg- 90- micro-180-stopni-5904422329488.html. (https://botland.com.pl/serwomechanizmy/484-serwo-towerpro-sg-90-micro-180-stopni-5904422329488.html)
[28] LIDAR-LITE V3HP OPERATION MANUAL AND TECHNICAL SPECIFICATIONS, Dostęp zdalny (01.01.2024): https://static.garmin.com/pumac/LIDAR- Lite_ v3HP_Instructions_EN.pdf, (https://static.garmin.com/pumac/LIDAR-Lite_v3HP_Instructions_EN.pdf) 2020.
[29] MP6500 Stepper Motor Driver Carrier, Digital Current Control, Dostęp zdalny (01.01.2024): https://www.pololu.com/product/2968, 2023.
[30] J. Fong, “Stepper Torque vs Voltage”, Dostęp zdalny (01.01.2024): https://embeddedtronicsblog.wordpress.com/2020/09/23/stepper-torque-vs-voltage/, (https://embeddedtronicsblog.wordpress.com/2020/09/23/stepper-torque-vs-voltage/) 2020.
[31] LIDARLite_Arduino_Library, Dostęp zdalny (01.01.2024): https://github.com/garmin/LIDARLite_Arduino_Library, (https://github.com/garmin/LIDARLite_Arduino_Library) 2020.
[32] NEO-M8 u-blox M8 concurrent GNSS modules Data sheet, Dostęp zdalny (01.01.2024): https://content.u-blox.com/sites/default/files/NEO-M8-FW3_DataSheet_UBX-15031086.pdf, (https://content.u-blox.com/sites/default/files/NEO-M8-FW3_DataSheet_UBX-15031086.pdf) 2022.

8. Bibliografia
[33] MPU9250, Dostęp zdalny (01.01.2024): https://github.com/hideakitai/MPU9250, 2022.
[34] NeoGPS, Dostęp zdalny (01.01.2024): https://github.com/SlashDevin/NeoGPS, 2018.
[35] “NMEA 0183”, Dostęp zdalny (01.01.2024): https://pl.wikipedia.org/wiki/NMEA_0183, (https://pl.wikipedia.org/wiki/NMEA_0183) 2022.
[36] pySerial, Dostęp zdalny (01.01.2024): https://pyserial.readthedocs.io/en/latest/pyserial.html, (https://pyserial.readthedocs.io/en/latest/pyserial.html) 2020.
[37] imu_complementary_filter, Dostęp zdalny (01.01.2024): https://wiki.ros.org/imu_complementary_filter, (https://wiki.ros.org/imu_complementary_filter) 2022.
[38] robot_localiztion, Dostęp zdalny (01.01.2024): https://github.com/cra- rospkg/robot_localization, (https://github.com/cra-ros-pkg/robot_localization) 2023.
[39] Cartographer ROS Integration, Dostęp zdalny (01.01.2024): https : / / google -cartographer.readthedocs.io/en/latest/, (https://google-cartographer.readthedocs.io/en/latest/) 2018.
[40] W. Hess, D. Kohler, H. Rapp i D. Andor, “Real-Time Loop Closure in 2D LIDAR SLAM”, w IEEE International Conference on Robotics and Automation, Google scholar, 2016,
s. 1271–1278.
[41] Ceres Solver, Dostęp zdalny (01.01.2024): http://ceres-solver.org/index.html, 2023.
[42] S. Macenski, F. Martin, R. White i J. Ginés Clavero, “The Marathon 2: A Navigation System”, w 2020 IEEE/RSJ International Conference on Intelligent Robots and Systems (IROS), 2020.
[43] pcregistericp, Dostęp zdalny (01.01.2024): https://www.mathworks.com/help/vision/ref/pcregistericp.html, (https://www.mathworks.com/help/vision/ref/pcregistericp.html) 2024.
[44] M. Zawadzki, “Film z testu terenowego - System autonomicznej nawigacji dla terenowego robota mobilnego”, Dostęp zdalny (01.01.2024): https://youtu.be/pcwmK5vn5Fg, (https://youtu.be/pcwmK5vn5Fg) 2024.

## Wykaz symboli i skrótów

EiTI – Wydział Elektroniki i Technik Informacyjnych EKF – ang. Extended Kalman filter
GNSS – ang. Global Navigation Satellite System GNSS – ang. Global Positioning System
I2C – ang. Inter-Integrated Circuit
IMU – ang. Inertial measurement unit
LiDAR – ang. Light Detection and Ranging
NASA – ang. National Aeronautics and Space Administration NEMA – ang. National Electrical Manufacturers Association PW – Politechnika Warszawska
ROS – ang. Robot Operating System
SLAM – ang. Simultaneous Localization and Mapping SysML – ang. Systems Modeling Language
UART – ang. Universal Asynchronous Receiver-Transmitter

## Spis rysunków

3.1 Zawieszenie łazika Perserverence [2] | | 12
3.2 Platforma mobilna | | 13
3.3 Skręt w napędzie róznicowym ˙ | | | 14
3.4 Skręt z dodatkowym przegubem | | 14
3.5 Zawieszenie platformy mobilnej | | 15
3.6 Skaner 2D RPLIDAR A3M1 [9] | | 17
3.7 Kamera głębi StereoLabs ZED 2 [11] | | 17
3.8 Skaner 3D Artec Ray II [12] | | 17
3.9 Czujnik Grove IMU 9DOF v2.0 MPU-9250 [13] | | 18
3.10 Odbiornik GNSS Ublox NEO-M8N [14] | | 18
4.1 Łazik Perseverance [2] | | 23
4.2 Leo Rover [17] | | 24
4.3 Robot wykorzystany do mapowania pni [18] | | 25
4.4 Robot wykorzystany do nawigacji w nierównym terenie [19] | | 25
5.1 Proponowana kompozycja systemu | | 26
5.2 Proponowana struktura komunikacji | | 27
5.3 Szkic struktury mechanicznej skanera | | 28
5.4 Proponowana struktura oprogramowania | | 36
5.5 Proponowana struktura oprogramowania | | 37
6.1 Skaner LiDAR | | 39
6.2 Mechanizm kalibracji kontaktronu | | 40
6.3 Stara wersja zespołu czujnika | | 41

6.4 Symulacja środka cięzkości zespołu czujnika ˙ | | | 42
6.5 Czujnik Grove IMU 9DOF v2.0 zamontowany na robocie | | 43
6.6 odbiornik GNSS Ublox NEO-M8N zamontowany na robocie | | 44
6.7 Zainstalowane sterowniki niskopoziomowe i komputer | | 44
6.8 Układy współrzędnych w robocie | | 46
6.9 Wizualizacja działaj ącego systemu w RVIZ 2 | | 47
6.10 Schemat działania systemu cartographer [39] | | 49
6.11 Schemat działania systemu NAV 2 [42] | | 50
6.12 Mapa globalna. System uruchomiony w przykładowym pomieszczeniu | | 51
6.13 Mapa loklana. System uruchomiony w przykładowym pomieszczeniu | | 51
7.1 Test przy pełnej rozdzielczości (1600x91), nachylenia od 45 do 135 stopni . . . | 55
7.2 Test przy rozdzielczości (1600x31), nachylenia od 70 do 100 stopni | | 55
7.3 Test przy rozdzielczości (800x16), nachylenia od 70 do 100 stopni | | 55
7.4 Test przy rozdzielczości (400x11), nachylenia od 70 do 100 stopni | | 55
7.5 Test przy rozdzielczości (200x6), nachylenia od 70 do 100 stopni | | 55
7.6 Test terenowy skanera; oznaczone drzewa | | 56
7.7 Konfiguracja testu porównania sensorów | | 57
7.8 Test przy pełnej rozdzielczości, widok perspektywiczny | | 57
7.9 Test przy pełnej rozdzielczości, widok z góry | | 57
7.10 Test przy pełnej rozdzielczości, widok z boku | | 57
7.11 Test przy ograniczonej rozdzielczości, widok perspektywiczny | | 58
7.12 Test przy ograniczonej rozdzielczości, widok z góry | | 58
7.13 Porównanie skanów w MatLab | | 58
7.14 Test nachylenia | | 60
7.15 Test na śniegu | | 60
7.16 (niebieski, zielony, czerwony) - orientacja przed testem; (zółty, magenta, cyjan) ˙
- orientacja po teście; biały - pokrycie | | 61
7.17 Widok z kamery przed testem | | 62
7.18 Wizualizacja przed testem | | 62
7.19 Widok z kamery po teście | | 62
7.20 Wizualizacja po teście | | 62
7.21 Wygenerowana mapa środowiska z widoczn ą trajektori ą robota podczas
mapowania | | 64
7.22 Porównanie mapy ze środowiskiem | | 64
7.23 Mapowane środowisko (widok z kamery głębi) | | 64
7.24 Planowana trajektoria (zielona linia) | | 65
7.25 Srodowisko testu terenowego ´ | | | 65
7.26 Mapa satelitarna terenu testowego | | 66
7.27 Test nawigacji terenowej | | 67
7.28 Przejazd przez las | | 69

7.29 Wizualizacja przejazdu przez las | | 69
7.30 Przejazd po nachylonym terenie | | 69

## Spis tabel

5.1 Ustawienia skanera | | 30
5.2 Interfejs sterowania robotem | | 33
