MarcelZawadzki/autonomous-rover-thesis/rover_cad/lidar_assembly.SLDASM

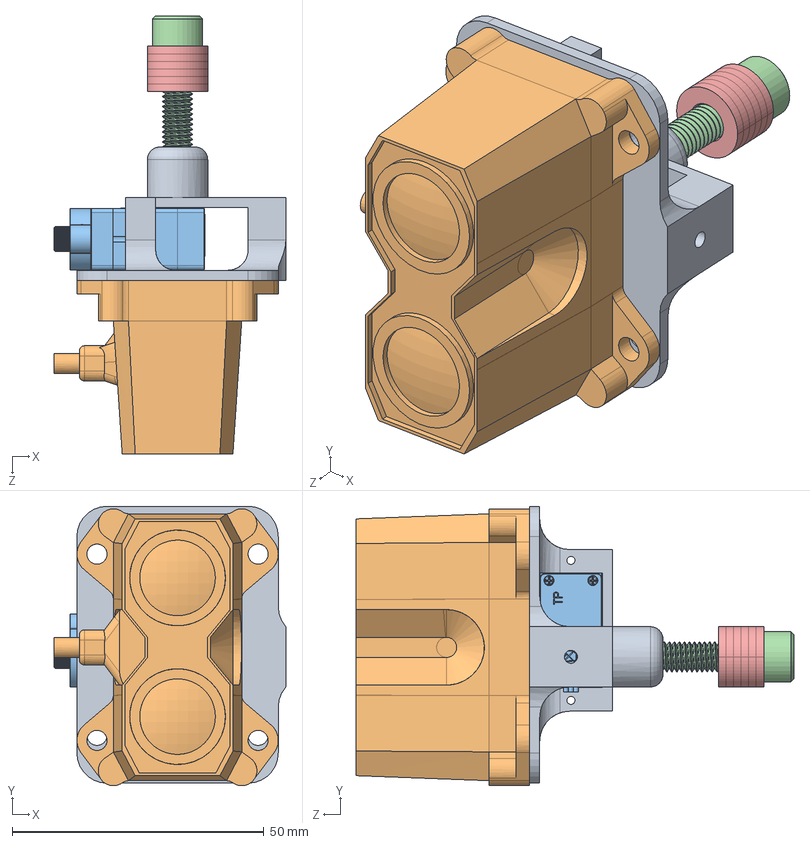
[picture p47: CAD file, 2024-01-23]
rover_cad/lidar_assembly.SLDASM
46.0 x 55.5 x 87.0 mm
lidar_mount
Garmin LIDAR-Lite V3HP
SG90 - Micro Servo 9g - Tower Pro.1
M6x30
9430109.stp x 6
