MarcelZawadzki/autonomous-rover-thesis/rover_cad/gps_mount.SLDPRT

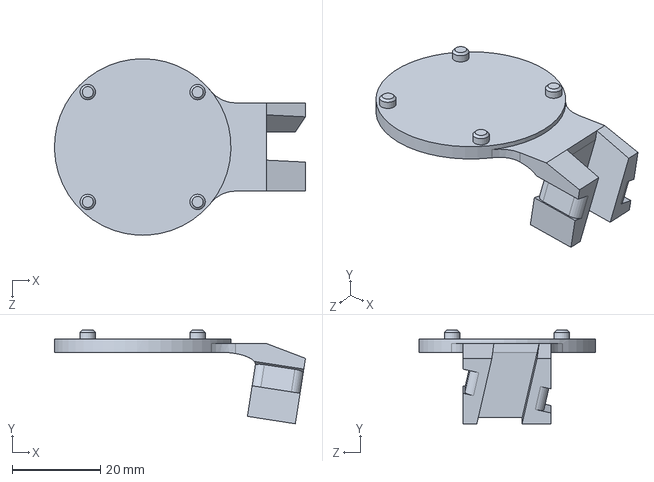
[picture p48: CAD file, 2024-01-23]
rover_cad/gps_mount.SLDPRT
56.9 x 21.2 x 40.0 mm
