MarcelZawadzki/autonomous-rover-thesis/rover_cad/SG90 - Micro Servo 9g - Tower Pro.4.SLDPRT

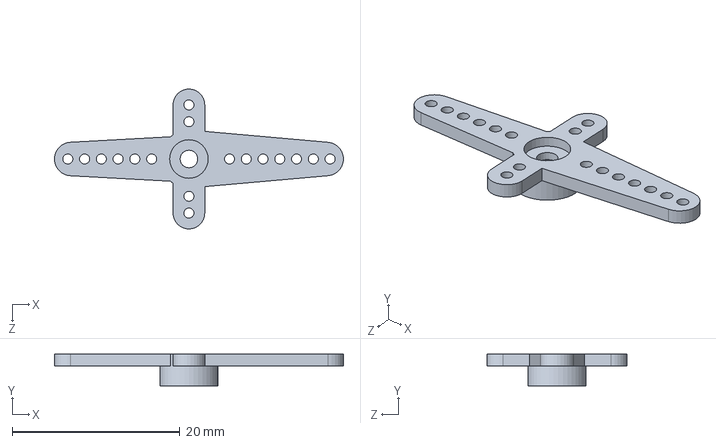
[picture p49: CAD file, 2024-01-23]
rover_cad/SG90 - Micro Servo 9g - Tower Pro.4.SLDPRT
34.5 x 3.80 x 16.7 mm
