MarcelZawadzki/autonomous-rover-thesis/rover_cad/SG90 - Micro Servo 9g - Tower Pro.1.SLDPRT

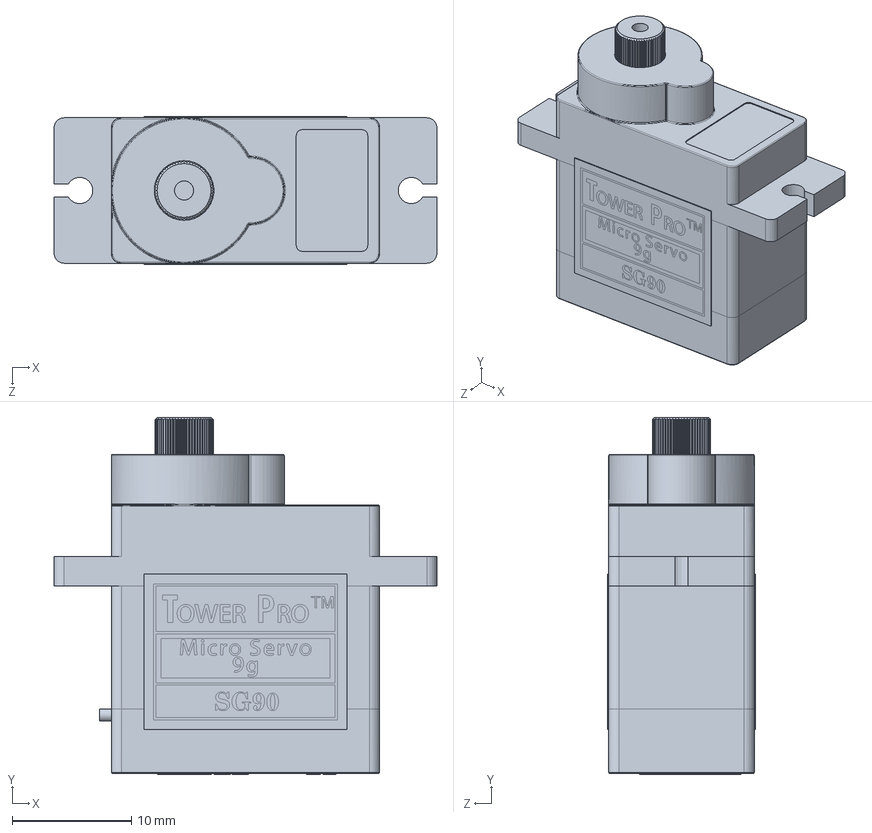
[picture p50: CAD file, 2024-01-23]
rover_cad/SG90 - Micro Servo 9g - Tower Pro.1.SLDPRT
32.1 x 30.0 x 12.4 mm
