MarcelZawadzki/autonomous-rover-thesis/rover_cad/Position_sensor_lidar_slider.SLDPRT

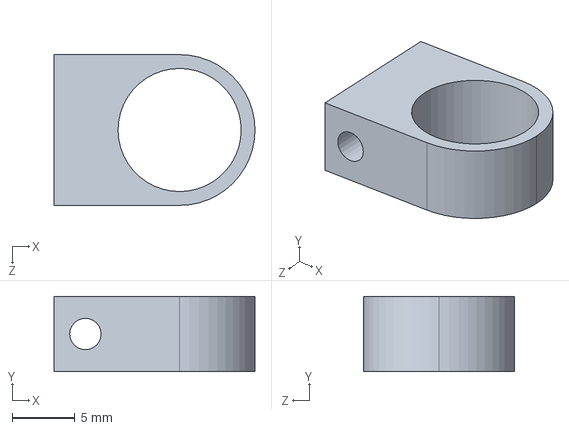
[picture p51: CAD file, 2024-01-23]
rover_cad/Position_sensor_lidar_slider.SLDPRT
16.0 x 6.00 x 12.0 mm
