MarcelZawadzki/autonomous-rover-thesis/rover_cad/Garmin LIDAR-Lite V3HP.SLDPRT

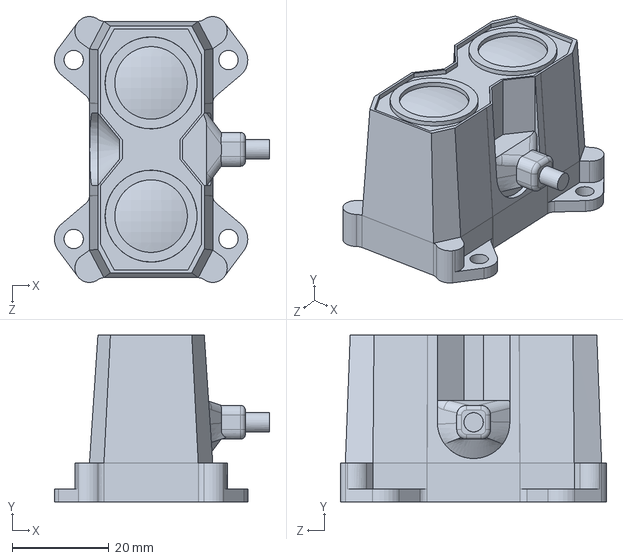
[picture p52: CAD file, 2024-01-23]
rover_cad/Garmin LIDAR-Lite V3HP.SLDPRT
44.5 x 34.4 x 55.0 mm
