MarcelZawadzki/autonomous-rover-thesis/rover_cad/lidar_mount.SLDPRT

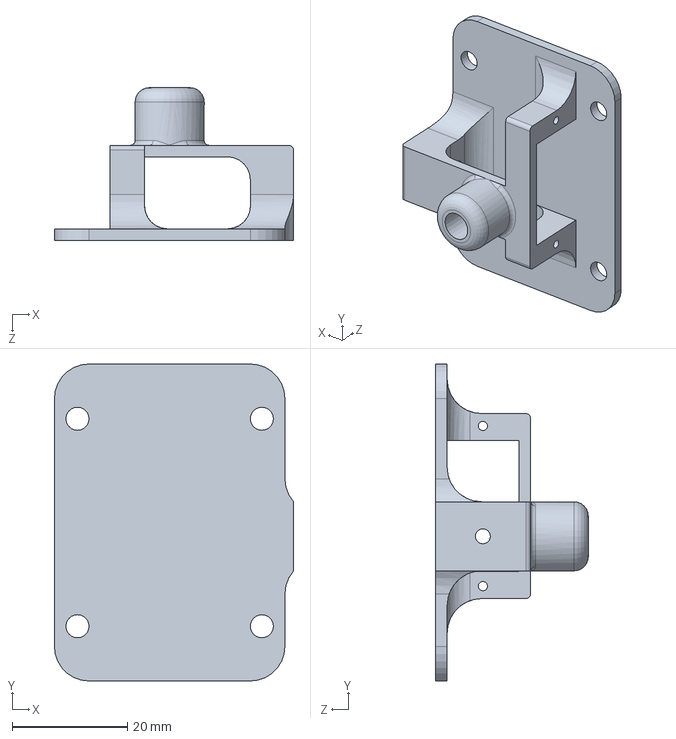
[picture p53: CAD file, 2024-01-23]
rover_cad/lidar_mount.SLDPRT
41.5 x 55.0 x 26.5 mm
