MarcelZawadzki/autonomous-rover-thesis/rover_cad/Position_sensor_lidar_mount.SLDPRT

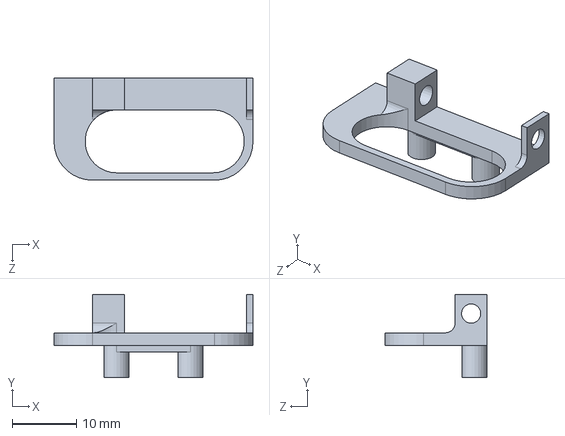
[picture p54: CAD file, 2024-01-23]
rover_cad/Position_sensor_lidar_mount.SLDPRT
31.0 x 13.0 x 16.0 mm
