MarcelZawadzki/autonomous-rover-thesis/rover_autonomy/instructions.txt

Komenda do testów cmd vel

ros2 topic pub -t 1 /cmd_vel geometry_msgs/msg/Twist "{linear: {x: -0.2, y: 0.0, z: 0.0}, angular: {x: 0.0, y: 0.0, z: 1.0}}"

Konfiguracja udev dla uart

https://gist.github.com/edro15/1c6cd63894836ed982a7d88bef26e4af

/etc/udev/rules.d/49-custom.rules

# Rover symlink acm
KERNEL=="ttyACM[0-9]*", SUBSYSTEM=="tty", ATTRS{idVendor}=="2341", ATTRS{idProduct}=="0042", SYMLINK="ttyRVR"

# Rover symlink usb
KERNEL=="ttyUSB[0-9]*", SUBSYSTEM=="tty", ATTRS{idVendor}=="2341", ATTRS{idProduct}=="0042", SYMLINK="ttyRVR"

# Lidar symlink
KERNEL=="ttyACM[0-9]*", SUBSYSTEM=="tty", ATTRS{idVendor}=="1a86", ATTRS{idProduct}=="7523", SYMLINK="ttyLID"

# Lidar symlink
KERNEL=="ttyUSB[0-9]*", SUBSYSTEM=="tty", ATTRS{idVendor}=="1a86", ATTRS{idProduct}=="7523", SYMLINK="ttyLID"

Użytkownik musi być w grupie dialout

TRZEBA USUNĄĆ BRLTTY
systemctl stop brltty-udev.service
sudo systemctl mask brltty-udev.service
systemctl stop brltty.service
systemctl disable brltty.service

cartographer

ros2 run cartographer_ros cartographer_occupancy_grid_node -resolution 0.05 -publish_period_sec 1.0

ros2 run cartographer_ros cartographer_node -configuration_directory install/rover_lidar/share/rover_lidar/config -configuration_basename cartographer.lua -r /points2:=/lidar_scan /imu:=/imu/data

Uruchamianie samego rviz:
rviz2 -d src/rover_lidar/rviz/urdf_config.rviz

Uruchamianie bez gui:
ros2 launch rover_lidar rover_full.launch.py gui:=false

ssh pi@192.168.1.106, admin
